Xavier8264/SAE-Aero-Design/reference/render/nau_2026_poster_p1.png

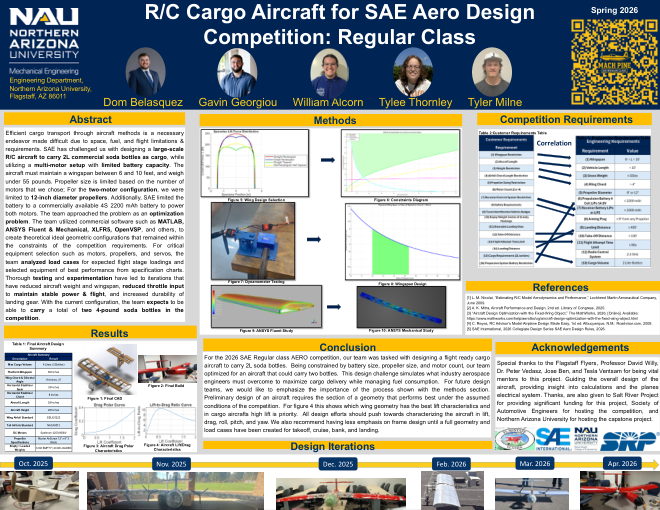
reference/render/nau_2026_poster_p1.png
