Xavier8264/SAE-Aero-Design/analysis/sizing/out/design_card.txt

DESIGN CARD: 2 x APC 12x6e, wing 95 x 26 in rectangular S1223, 6 bottle slots
Wing: S 17.15 ft2, AR 3.65, MAC 26 in, W/S 2.04 lb/ft2 at W_TO 35.0 lb
Tail (V_H 0.55, V_V 0.045, l_t 72 in): H-tail 3.41 ft2 (44 x 11.1 in, AR 4); V-tail 1.02 ft2 (15 in tall x 9.9 in, AR 1.5)
Bay: 1 layer(s), 29.9 in long x 13.5 in wide x 5.7 in tall (bottles transverse); fuselage pod ~46 in + boom; overall length ~93 in (< 120 rule)
Empty weight 17.66 lb (structure band x0.8 14.79 / x1.2 20.54): wing 7.18, fuselage 3.16, tail 1.08, gear 1.89, misc 1.07, propulsion 1.68, battery 0.55, avionics 1.05
Payload capability 17.38 lb (band: 14.50 .. 20.25); 1E4F needs 17.25 lb, 0E4F 16.20, 2E4F 18.30, 0E5F 20.25
Aero: clmax_2D 2.10, eta_max 1.173, CLmax wing 1.715, trimmed 1.661; e 0.925; CD0 non-wing 0.0163 (fus 0.0055, boom 0.0003, tail 0.0028, gear 0.0049, nac 0.0014)
  Cruise/circuit V 46.4 ft/s (32 mph), CL 0.85, CD 0.102, L/D 8.3, drag 4.22 lbf
Takeoff W 35.0 lb, DA 2000 ft: distance 100.0 ft (ground 89.1 ft, 4.5 s), V_stall 33.1 ft/s, V_R 36.4 ft/s, T0 12.17 lbf, T(V_R) 9.52 lbf
Takeoff W 35.0 lb, DA 1400 ft: distance 96.9 ft (ground 86.1 ft, 4.4 s), V_stall 32.8 ft/s, V_R 36.1 ft/s, T0 12.31 lbf, T(V_R) 9.64 lbf
Circuit (DA 2000): climb gradient 0.129 (5.6 ft/s at 1.3 V_s), 30 deg turn thrust margin 0.102 W, CL_turn 0.98
  current level 38 A / turn 48 A, flight 117 s, charge 1.38 Ah of 1.76 usable; landing roll from 1.2 V_s: 393 ft free, 114 ft braked (400 ft zone incl. touchdown)
Prop static DA  2000: Kv 843 rpm/V, 10527 rpm (APC limit 12500), thrust 6.54 lbf/motor (model, x0.93 applied in takeoff), battery 87 A total, shaft 519 W/motor, V_batt 13.8 V
Prop static DA  1400: Kv 843 rpm/V, 10494 rpm (APC limit 12500), thrust 6.62 lbf/motor (model, x0.93 applied in takeoff), battery 88 A total, shaft 524 W/motor, V_batt 13.8 V
Prop static DA     0: Kv 843 rpm/V, 10418 rpm (APC limit 12500), thrust 6.79 lbf/motor (model, x0.93 applied in takeoff), battery 90 A total, shaft 534 W/motor, V_batt 13.7 V
Bay option 6 slots: band 0.8: pay 20.3 -> 0E5F FS 55, E_FFS 59.2; band 1.0: pay 17.4 -> 1E4F FS 47, E_FFS 52.4; band 1.2: pay 14.5 -> 2E3F FS 39, E_FFS 45.0
Bay option 8 slots: band 0.8: pay 19.8 -> 3E4F FS 53, E_FFS 60.0; band 1.0: pay 16.8 -> 4E3F FS 45, E_FFS 52.0; band 1.2: pay 13.9 -> 5E2F FS 37, E_FFS 44.0
Aluminum-tube boom (4.1 ft): +0.38 lb empty -> payload 17.00 lb
