Xavier8264/SAE-Aero-Design/PROJECT_MEMORY.md

# SAE Aero Design 2027 Regular Class -- Project Memory Log

## RULES FOR THIS FILE (read first, every session)

1. APPEND-ONLY. Never delete or edit existing text. Add new entries at the END of the file only
   (e.g. `cat >> PROJECT_MEMORY.md <<'EOF' ... EOF`), never rewrite the file.
2. Every entry starts with a timestamp header: `## [YYYY-MM-DD HH:MM TZ] <task title>`.
   Get the time from the system clock (`date`), do not guess it.
3. CONTRADICTIONS: if two entries disagree, the entry with the LATEST timestamp is correct.
   To correct something, append a new entry that says what it supersedes. Do not edit the old one.
4. When in doubt, document. Record what was done, what was decided, the numbers used, where
   files/scripts live, sources, and what is still unverified, so a future Claude Code session
   can pick up without re-deriving anything.
5. Tag confidence where it matters: [VERIFIED] = read from a source/file, [INFERRED] = my
   reasoning, [UNVERIFIED] = assumption that still needs checking.
6. ASCII only in this file.

---

## [2026-09-18 20:31 CDT] Log created; back-fill of session 1 work (earlier this evening)

Note: the items below were done earlier in session 1 on 2026-09-18 before this file existed.
They are recorded now, so the timestamp is when they were written down, not when they happened.

### Source documents
- Rules: `2027_SAE_AeroDesign_Rules_Set.pdf` (Version 2027.0) in this folder.
- Text extraction: `pdftotext -layout` works (Git Bash, /mingw64/bin/pdftotext). Equations lose
  their symbols in text; render the page with PyMuPDF (`import pymupdf`, page.get_pixmap) to read them.
  The Read tool cannot render PDFs here (no pdftoppm).
- Regular Class = rules section 7 (pp. 33-36). TDS prediction = section 4.5 (p. 26).
  Flight rules = section 3 (pp. 17-20). Gross weight = p. 12.

### 2027 Regular Class rules summary [VERIFIED from rules PDF]
- Wingspan: > 72 in and < 96 in (max reduced vs 2026; Regular mission is in "year 2").
- Wing chord > 4 in. Body axis length < 120 in. Gross takeoff weight <= 55 lb.
- NO fiber-reinforced plastic anywhere (carbon, fiberglass; duct tape counts as FRP). Exceptions:
  commercially available FRP motor mounts, propellers, landing gear, control linkage parts.
- Rubber bands / elastics may not retain the wing or the payload.
- Propulsion: exactly 2 or 4 electric motors, any make/model. Props at motor RPM (1:1 if geared/belted).
  Max prop diameter 12 in (2 motors) or 9 in (4 motors). No metal props. Spinner or rounded safety nut.
- Battery: one commercially available 4S (14.8 V) LiPo, max 2200 mAh. NO power limiter required.
- Separate receiver battery required (Regular): LiPo or LiFe, >= 1000 mAh. Rx must work with arming plug out.
- Red arming plug on + lead, >= 9 in from any prop, top of fuselage near centerline, clearly visible.
- Wheeled gear needs ground steering (not aero surfaces alone).
- Ballast allowed if permanently installed, not in payload bay, not tradeable for payload.
- Payload: unmodified commercially available 2L cylindrical plastic bottles, carried internally.
  - EMPTY BOTTLE: gross weight > 1.0 lb and < 4.0 lb (unpressurized air or inert material).
  - FILLED BOTTLE: gross weight >= 4.0 lb.
  - Min 1 bottle per flight. After a scored flight, next attempt must add >= 1 empty bottle AND/OR
    swap >= 1 empty for a filled one. Total scored bottle count must stay constant or increase.
  - Spill that delays flight ops -> forfeit one flight attempt.
  - Cargo bay fully enclosed, bottles not exposed to airstream, must not shift. Any size/shape, multiple bays OK.
  - Unload demo at weigh station: <= 2 people, 1 minute, configuration unchanged since flight.
    Filled < 4.0 lb counts as empty; empty < 1.0 lb not counted. No tethers/harnesses on bottles.
- Flight: one flight per attempt, 60 s time limit from call to flight line, NO multiple takeoff tries (Regular).
  Airborne within 100 ft. No turn before 400 ft from start. One full 360 deg circuit. No aerobatics.
  Land within 400 ft, same direction as takeoff, no touch-and-go, stay on runway/zone.
  Two escorts + pilot; one member may hold the aircraft; main gear on takeoff line; no push on release.
  Anything other than a prop broken on landing falling off -> flight disqualified. Stickers/tape/covering
  detaching -> 25% deduction.
- Scoring (rules p. 36):
  - FS = 3*EB + 11*FB   (EB = # empty bottles, FB = # filled bottles)
  - FFS = (FS1 + FS2 + FS3)/3 + PPB   (top 3 flights)
  - PPB = max(10 - (FS - PS)^2, 0), PS = predicted max flight score read off the TDS curve at the
    measured density altitude. PPB uses whichever of the top-3 flights gives the largest PPB.
  - Tie-break: total filled bottles in top 3 scored flights.
- TDS: 1-page stand-alone doc (graph of predicted max flight score vs density altitude, English units,
  one value per altitude, monotonic, may include headwind/rolling drag/etc.) + a JSON data file.
  Bad JSON -> may lose the prediction bonus.
- Deadlines: lottery interest window Sept 16-30, 2026; lottery published Oct 1, 2026.
  Design Report + TDS + 2D drawing due 02/01/2027 11:59:59 EST (East/Florida, March)
  or 03/08/2027 (West/California, April). ECR deadline 02/26/2027 East, 04/02/2027 West.
  Late penalty 5 pts/day up to 5 days.

### Scoring insights [INFERRED]
- Points per pound are nearly equal: empty ~3.0 pts/lb (at ~1.0 lb), filled ~2.75 pts/lb (at 4.0 lb).
  Per bottle, filled is 3.7x better. Empties cost bay volume and drag more than weight.
  Likely direction: size the bay around filled bottles, use empties as +3 increments.
- Payload must increase every scored flight and FFS averages the top 3, so a planned payload
  "ladder" of >= 3 successful rungs is needed, and the bay must fit the top rung.
- PPB is effectively "predict your exact max configuration": missing by one empty bottle (3 pts)
  drops PPB from 10 to 1. Worth nearly one filled bottle.

### Team context (answers from Jordan)
- First-year team (no prior SAE aircraft or legacy data).
- Pilot: experienced with large/heavy (10+ lb) RC aircraft.
- Shop: laser cutter, 3D printers, machine shop / CNC mill. NO foam hot-wire.
- CAD: SolidWorks.
- Aircraft budget: under $1,000 (one airframe, value components, few spares). [INFERRED] favors 2 motors.
- Testing: thrust stand (have or can build) + flying field. No wattmeter/telemetry yet
  (recommended buying an inline wattmeter).
- Jordan wants help on everything: sizing & performance, aero & stability, structures & layout,
  report & TDS, and wants real external/online tools used (e.g. OpenFOAM, FluidX3D, not limited to these).

### Local compute [VERIFIED 2026-09-18]
- Laptop: AMD Ryzen 5 PRO 5675U, ~16 GB RAM, AMD integrated Radeon graphics only (no NVIDIA).
- WSL2 Ubuntu + docker-desktop distros installed (stopped). Python 3.14 with numpy 2.3.4, scipy 1.17.1,
  matplotlib 3.10.7, pandas 2.3.3, pypdf, pymupdf, pdfplumber.
- NOT installed: xfoil, avl, xflr5, openvsp, OpenFOAM, gmsh, paraview, aerosandbox.
- [INFERRED] FluidX3D (OpenCL) should run on the iGPU but at limited resolution; OpenFOAM feasible in WSL
  for a few-million-cell RANS case. Plan: AeroSandbox+NeuralFoil for sizing now, AVL/XFLR5 for
  stability, CFD later for targeted questions (fuselage drag, prop wash, flapped wing).

### Proposed plan (draft, to Feb 1, 2027)
1. Now -> mid-Oct: scoring/ladder model + conceptual sizing (100 ft takeoff model, motor/prop/battery,
   wing area, bottle count, 2 vs 4 motors). AeroSandbox + Python.
2. Mid-Oct -> Nov: airfoil, tail, CG/stability (AVL/XFLR5); spar/structure (wood/ply/aluminum);
   SolidWorks layout; thrust stand tests.
3. Late Nov -> Dec: build prototype, test-fly, measure takeoff distance at stepped weights.
4. Early Jan: targeted CFD. Jan: calibrate prediction with test data -> TDS curve + JSON, report, 2D drawing.

---

## [2026-09-18 20:31 CDT] Decisions from Jordan (session 1, second message)

- EVENT: assume the SOONER competition = East / Florida (March 2027). Design deadline = Feb 1, 2027
  (Design Report + TDS + 2D drawing, 11:59:59 PM EST). This supersedes "event undecided".
- This file (`PROJECT_MEMORY.md`) is the project memory: append-only, timestamped, latest wins.
- Standing rule: when in doubt, document work here for future Claude Code sessions.
- Bottle dimensions: use standard US 2L bottle dimensions from a web lookup (see next entries).
- Research what typically goes in the bottles, using 2026 (last year) info where possible.

---

## [2026-09-18 20:39 CDT] Research: standard US 2L bottle dimensions

- dimensions.com "Soda Bottle - 2 Liter": overall height 12.4 in (31.5 cm), diameter 4.33 in (11 cm). [VERIFIED source]
- Wikipedia "Two-liter bottle": height 300-330 mm (12-13 in), diameter 100-120 mm (3.9-4.7 in); PET, one piece,
  corrugated (petaloid) base. [VERIFIED source]
- Empty bottle mass: web sources disagree (30-80 g quoted); most say ~40-50 g. Working value 0.10 lb (~45 g)
  incl. cap. [UNVERIFIED -- weigh the actual bottles]
- WORKING BOTTLE MODEL for sizing: 4.33 in dia x 12.4 in tall, 0.10 lb empty.
- DESIGN ENVELOPE per bottle slot until real bottles are measured: 4.7 in dia x 13.0 in long [INFERRED:
  covers the whole Wikipedia range]. Shrink once the team buys and measures its chosen brand.
- TODO (Jordan/team): buy the brand you will fly, measure dia/height/empty mass of several, record here.

## [2026-09-18 20:39 CDT] Research: what goes in the bottles (2026 info)

### What the rules actually say [VERIFIED]
- 2026 rules: bottles contain "unpressurized air or material". 2027 rules: "unpressurized air or INERT material".
- No rule and no official FAQ (as of 2026-09-18) names a specific filler. Teams supply their own bottles
  [INFERRED from rules wording; not stated explicitly].
- Spill that delays flight ops -> forfeit one flight attempt (both years).
- 2027 adds: unloaded bottles must be free of tethers, harnesses, or similar external modification.
- Searched: official FAQ list, 2026 NAU capstone docs, TAMU/UC news articles, general web. No public source
  states what 2026 teams filled bottles with. Articles only say "weighted 2-liter plastic bottles".
  Per-team 2026 flight scores are not public (require saestars.com team login).

### Filler analysis [INFERRED; bulk densities are typical values, UNVERIFIED]
Targets with margin: FILLED = 4.05 lb gross, EMPTY = 1.05 lb gross (bottle 0.10 lb assumed).
Filler mass: FILLED 1.792 kg (3.95 lb), EMPTY 0.431 kg (0.95 lb). Nominal volume 2.0 L.
Brim-full average density needed: FILLED 0.896 kg/L, EMPTY 0.215 kg/L.

| Filler | kg/L | FILLED fill % | EMPTY fill % | Notes |
|---|---|---|---|---|
| water | 1.00 | 90% | 22% | sloshes if not full; brim-full = 4.51 lb (+0.46 lb waste); leak/spill risk; "inert"? ask FAQ |
| dry sand | 1.6  | 56% | 13% | cheap, dense; half-empty bottle lets sand shift at high pitch/vibration |
| pea gravel | 1.6  | 56% | 13% | like sand, less dust, easier cleanup |
| white rice | 0.8  | 112% (NO) | 27% | TRAP: brim-full rice = 3.63 lb gross -> scores as EMPTY, not filled |
| steel BBs | 4.7  | 19% | 5% | very compact, rolls freely -> worst for CG shift |
| sawdust | 0.21 | no | ~103% | brim-full ~1.03 lb gross: right at the 1.0 lb empty limit, too marginal |

Takeaways:
1. Most practical choices: dry sand or pea gravel (cheap, inert, dense, cleanable), or water if the FAQ allows it.
2. Free space inside the bottle lets the payload CG move when the aircraft pitches (rotation ~10-15 deg).
   Liquid moves immediately. Sand/gravel only flows past its angle of repose (~30-35 deg), so it is much
   better. Best: a BRIM-FULL dry mix tuned to the target density (e.g. sand + a lighter granular filler)
   so nothing can move.
3. Never use rice alone for a filled bottle (it cannot reach 4.0 lb).
4. Weigh every bottle on a calibrated scale before each flight; the weigh station is final.
   Filled < 4.0 lb scores as empty; empty < 1.0 lb does not count.
5. Cap security matters (spill = forfeit attempt), but tape/tethers may count as "external modification".

### Recommended official FAQ question to submit (saeaerodesign.com FAQ)
"Regular Class 2027 7.4: (a) Is water an acceptable 'inert material' for bottle fill? (b) May teams seal the
bottle cap with tape or thread sealant, or does that count as modification? (c) Are there restrictions on
granular fillers such as sand or gravel?"

## [2026-09-18 20:39 CDT] Research: 2026 Regular Class (last year) findings

### 2026 -> 2027 rule changes (diffed section 7 text) [VERIFIED]
- Max span: < 120 in (2026) -> < 96 in (2027). Min span > 72 in unchanged.
- Flight score: FS = 4*EB + 15*FB (2026) -> FS = 3*EB + 11*FB (2027). PPB formula unchanged.
- Filler wording: "material" -> "inert material".
- Payload increase rule now in the rulebook: "Total scored bottle count must remain constant or increase".
- New: unloaded bottles must be free of tethers/harnesses/external modification.
- Tie-break: lowest empty weight (2026) -> most filled bottles in top 3 flights (2027).
- Everything else in section 7 (materials, propulsion, battery, props, cargo bay) is unchanged.
- [INFERRED] every 2026 aircraft (many had 10 ft spans) must be redesigned for 96 in, so a first-year
  team is less disadvantaged than usual.

### Official FAQs (verbatim copies in reference/2026/SAE_FAQ_394_393_395_382.txt) [VERIFIED]
- FAQ 394 (2026): total bottle count must be constant or increasing. 2 empty + 2 filled -> 3 filled is NOT
  allowed. Valid: -> 1 empty + 3 filled, or -> 3 empty + 2 filled.
- FAQ 393 (2026): TDS breakpoints need not be evenly spaced; duplicate a density altitude at a score step to
  avoid interpolation (the highest score is used for duplicates); otherwise linear interpolation.
  (2026 used CSV; 2027 rules say JSON. Assume the same interpolation behavior [UNVERIFIED for 2027].)
- FAQ 395 (2027, posted 2026-09-14): prop diameter limit is the SUM of prop diameters per motor
  (2 motors: 12 in per motor, e.g. 1x12 or 2x6; 4 motors: 9 in per motor). No blade-count limit.
  SAE says battery + prop limits were set deliberately to cap payload capability since the power limiter was removed.
- FAQ 382 (2025): differential thrust does NOT count as ground steering; need a steerable wheel/mechanism.

### 2026 results (placings only; scores not public) [VERIFIED docs, column mapping INFERRED]
- East: March 6-8, 2026, Lakeland FL. Regular mission 1st Politechnika Poznanska (White Eagle), 2nd UW-Platteville
  (Pioneer Flyers), 3rd UFBA (Axe Fly). Regular overall: same order. Design 1st Warsaw UT (WUT Regular).
- West: April 17-19, 2026, Fort Worth TX (note: the 2027 rules say West is in California).
  Regular mission and overall: 1st NUAA (Phoenix), 2nd Poznan (White Eagle), 3rd Tarleton State (Texan Aero).
- TAMU Regular (Farmers Flight): 5th overall, 6th mission, 14th design report; 1st presentation.
  UC AeroCats Regular: 4th overall; ten-foot span.

### NAU "Mach Pine" 2026 Regular (a first-time capstone team) -- a useful low-end data point [VERIFIED poster/slides]
- Final: 80 in span, 19 in chord, 3 deg dihedral, S1223 wing airfoil, NACA 0012 tail, 39 in x 8 in stab,
  60 in long, 26 in tall. 2x Spektrum 4250-800kV with Master Airscrew 12x6 3-blade props.
  12.2 lb empty, 20 lb loaded. Cargo volume: 2 bottles. Goal: two 4-lb filled bottles.
- Tools: MATLAB, ANSYS Fluent & Mechanical, XFLR5, OpenVSP.
- Test: took off within 100 ft carrying 2 empty bottles (~1 lb each), but the flight ended in a crash.
- Lesson [INFERRED]: an empty-weight fraction around 60% leaves little payload. Plan early flight testing and repair time.

### Reference files saved to the project (for future sessions)
- reference/2026/2026_SAE_AeroDesign_Rules_Set.pdf
- reference/2026/2026_SAE_Aero_Design_East_Final_Results.pdf, ..._West_Final_Results.pdf
- reference/2026/NAU_MachPine_2026_Regular_poster.pdf
- reference/2026/UW_2026_rule_summary.pdf (a team's summary; it wrongly says "single electric motor")
- reference/2026/SAE_FAQ_394_393_395_382.txt

### Sources
- https://www.dimensions.com/element/soda-bottle-2-liter
- https://en.wikipedia.org/wiki/Two-liter_bottle
- https://saeaerodesign.com/cdsweb/rqa/BrowseFAQs.aspx (FAQ 382, 393, 394, 395)
- https://saeaerodesign.com/cdsweb/gen/DownloadDocument.aspx?DocumentID=10643d37-9fd1-4821-b413-9b7ddae8724b (2026 rules)
- https://www.saeaerodesign.com/content/2026-SAE-Aero-Design-East-Final-Results.pdf
- https://www.saeaerodesign.com/content/2026-SAE-Aero-Design-West-Final-Results.pdf
- https://www.ceias.nau.edu/capstone/projects/ME/2026/F25toSp26_Aero26/RegularClass.html (poster, slides;
  design report and most slides are password protected and were not opened)
- https://news.engineering.tamu.edu/news/2026/04/27/aero-design-team-continues-international-success/
- https://www.uc.edu/news/articles/2026/05/engineers-place-first-in-aircraft-design-competition.html
- https://aerouw.org/rule_summary.pdf

---

## [2026-09-18 20:54 CDT] Workflow: local reference library for token efficiency (tools/doc2text.py)

Jordan proposed: download documents once, convert PDFs/web pages to text with a Python script, and look
at the text instead of re-reading originals. Adopted, with these additions: an index, page markers,
per-page reliability flags, on-demand page rendering, and the file-rule amendments in the next entry.

### Commands (run from the project root)
- `python tools/doc2text.py fetch URL --name ID [--note TEXT]`  download + convert (cached; --force to refresh)
- `python tools/doc2text.py add PATH --name ID [--source URL] [--note TEXT]`  convert a local file in place
- `python tools/doc2text.py render ID PAGES`  PNG of PDF page(s) -> reference/render/ (only when needed)
- `python tools/doc2text.py note ID TEXT`, `rebuild`, `list`
- Handles PDF (PyMuPDF), HTML (BeautifulSoup+lxml), DOCX, PPTX (incl. truncated files), XLSX.
  Detects encrypted Office files and plain zips (flagged, not converted). No new packages were installed.

### Layout
- reference/INDEX.md: one row per document (ID, type, pages, ~tokens, flags, source, note). READ THIS FIRST.
- reference/text/ID.txt: text with markers like `=== PAGE 44 | p.36 | math ===` (PDF page | printed page | flags).
- reference/raw/: downloaded originals. reference/manifest.json: machine-readable index.
- reference/2026/: 2026 originals added in place.

### Lookup procedure (token-efficient)
1. Read reference/INDEX.md (small), not whole documents.
2. Grep reference/text/ for keywords, then Read only those line ranges. Cite printed page numbers.
3. Render a page image only if it is flagged (math/garbled/img) and the exact form matters.

### Measured [VERIFIED 2026-09-18]
- 15 documents: 4.30 MB of originals -> 0.30 MB of text (7%).
- Each SAE FAQ page: 17-30 KB of HTML -> about 150-420 tokens of text.
- rules_2027.txt is about 33k tokens in total: never read it whole, grep it.

### Extraction caveats found while testing [VERIFIED]
- PyMuPDF + Unicode NFKC recovers the Cambria Math equations that pdftotext drops. Rules p.36 reads
  "FS= Flight Score= 3(EB) + 11(FB)", "PPB= ... MAX(10 -(FS-PS)2, 0)". Sub/superscripts are flattened:
  "(FS-PS)2" means squared, "FS1" means FS_1. Those pages carry the `math` flag.
- The rules PDFs draw section NUMBERS (e.g. "7.6") as small images, so they are missing from the text.
  Search by heading words instead.
- The NAU poster has broken font encoding (flag `garbled`). Render it if needed.
- saeaerodesign.com is ASP.NET and wraps the whole page in a <form>; the converter must not strip <form>.
  The `lowtext` flag caught this bug on the first run.
- TOOL QUIRK: backslash-u escape sequences typed into Claude tool inputs (Write/Edit/Bash) get turned into
  literal Unicode characters. In code, build non-ASCII characters with chr(0x...) instead.

### Superseded / new
- reference/2026/SAE_FAQ_394_393_395_382.txt is superseded by reference/text/faq_*.txt (kept, not deleted).
- Library IDs as of now: rules_2027, rules_2026, results_2026_east, results_2026_west, nau_2026_poster,
  uw_2026_rule_summary, faq_list, faq_157, faq_170, faq_382, faq_393, faq_394, faq_395,
  wiki_two_liter_bottle, dimensions_2l_bottle.
- NEW [VERIFIED FAQ 170]: every pilot must present a valid AMA (Academy of Model Aeronautics) card at the
  field. The only exception is MAAC (Canada) members. ACTION: confirm the team pilot's AMA membership is current.
- NEW [VERIFIED FAQ 157]: all team members and the faculty advisor must be affiliated on www.sae.org. Students who
  submit documents or ask rules questions must also be affiliated on www.saeaerodesign.com.

## [2026-09-18 20:54 CDT] Amendment to RULES FOR THIS FILE (rules 7-9; appended, since the file is append-only)

7. CURRENT STATE SUMMARY entries: at the end of each design phase, or once ~400 lines have been added since the
   last one, append an entry titled "CURRENT STATE SUMMARY" that consolidates the latest truth (decisions,
   key numbers, open items, file locations). Future sessions: read the RULES header, then the LAST
   "CURRENT STATE SUMMARY" and everything after it. Grep older entries only when needed.
   (None written yet: the log is still short enough to read in full.)
8. Analysis scripts write full outputs to files and print only a short summary. Never paste full solver or CFD
   logs into the conversation.
9. Look things up library-first: reference/INDEX.md -> grep reference/text/ -> read line ranges -> render only
   if flagged. Use WebFetch only for one-off facts; archive anything that will be cited again with
   `doc2text.py fetch`.

---

## [2026-09-18 21:06 CDT] AI token-efficiency workflow set up (CLAUDE.md, AI_WORKFLOW.md, settings)

Verified against official Claude Code docs, archived as reference/text/cc_*.txt (costs, prompt_caching,
model_config, memory, best_practices, vs_code, context_window, commands, sessions, hooks, statusline,
troubleshooting, settings_reference, env_vars). These are big files (cc_hooks ~82k tokens,
cc_env_vars ~124k): grep them, never read them whole.

### Key facts [VERIFIED from docs]
- Every request re-sends the full conversation; cached re-reads still count toward usage. /clear costs nothing.
  /compact is itself a large request and is lossy.
- Auto-compact is ON by default. On Opus 4.7+ / Sonnet 5 / Fable (1M window, Anthropic API) it fires at about
  967K tokens. Settings: `autoCompactEnabled` (the /config "Auto-compact" toggle), `autoCompactWindow`
  (100K-1M; /autocompact writes it to USER settings), env CLAUDE_CODE_AUTO_COMPACT_WINDOW,
  CLAUDE_AUTOCOMPACT_PCT_OVERRIDE, DISABLE_AUTO_COMPACT.
- CLAUDE.md may contain a "# Compact instructions" section. The project-root CLAUDE.md and auto memory are
  re-injected from disk after compaction.
- These invalidate the prompt cache: switching model, changing effort (except Fable 5.1), fast mode, MCP
  connect/disconnect, plugin toggle, compaction, many images, upgrading Claude Code. Rewind keeps the cache.
  Editing CLAUDE.md mid-session keeps the cache but only applies after /clear, /compact or restart.
- Cache TTL: 1 hour on a subscription within limits (5 min on an API key / usage credits).
- VS Code extension: supports only a subset of slash commands (type / to list), has checkpoints/rewind via the
  message hover button, a context indicator in the prompt box, a Session history button, and /usage.
- Keep CLAUDE.md under 200 lines. MCP servers add tool names + server instructions to every session.
  Agent teams use about 7x the tokens.

### Changes made (Jordan approved both via questions)
- CREATED .claude/settings.json (project scope): {"autoCompactEnabled": true, "autoCompactWindow": 200000}.
  It is a backstop only. It takes effect from the NEXT session: the settings watcher only watches directories
  that had a settings file at session start [per update-config skill; not directly verified].
- EDITED C:/Users/jprun/.claude/settings.json (GLOBAL): effortLevel "xhigh" -> "high". Model stays "opus".
  Applies to new sessions. Pick xhigh at the START of hard design sessions.
- CREATED CLAUDE.md (project root, ~40 lines, auto-loaded every session): session-start protocol,
  working rules, checkpoint procedure, "# Compact instructions".
- CREATED AI_WORKFLOW.md: the human guide (session loop, which reset to use, auto-compact, model/effort,
  tips, cheat sheet). CLAUDE.md tells Claude not to load it unless asked.

### Session protocol (summary; CLAUDE.md is authoritative)
Start fresh with one task -> Claude reads the log header + LAST "CURRENT STATE SUMMARY" + later entries ->
work -> Jordan says "checkpoint" -> Claude appends to the log -> Jordan runs /clear.
Wrong path -> rewind (cheapest). Long session mid-task -> /compact with focus. Side question -> /btw.
Break > 1 hour -> checkpoint first.

### Suggestions left to Jordan (not done)
- Disable MCP connectors this project does not use (Indeed, Canva probably) via /mcp.
- Gmail / Google Calendar connectors need authorization in claude.ai connector settings if ever wanted.

## [2026-09-18 21:06 CDT] CURRENT STATE SUMMARY (end of setup/research phase; start here)

Consolidates everything above. Older entries hold the detail and sources; grep them only when needed.

### Project
- SAE Aero Design 2027 Regular Class (2L-bottle cargo). First-year team. Jordan leads the work with Claude.
- Event: plan for EAST / Florida (March 2027). Design Report + TDS (1-page PDF + JSON) + 2D drawing due
  2027-02-01 11:59:59 PM EST. Lottery interest window closes 2026-09-30.
- Team: experienced heavy-RC pilot; laser cutter, 3D printers, machine shop/CNC mill (no hot-wire);
  SolidWorks; budget < $1,000; thrust stand + flying field; no wattmeter yet (buy one).
- Compute: Ryzen 5 5675U laptop, 16 GB, AMD iGPU, WSL Ubuntu. Python: numpy/scipy/matplotlib/pandas,
  pymupdf, bs4, lxml, python-docx/pptx, openpyxl, requests. No aero tools installed yet.

### Rules that drive the design (rules_2027, printed pages 33-36 unless noted)
- Span > 72 in and < 96 in; chord > 4 in; length < 120 in; gross weight <= 55 lb (p.12).
- NO FRP (carbon/fiberglass/duct tape) except bought motor mounts, props, gear, linkages.
- 2 motors (12 in props) or 4 motors (9 in props); the limit is the SUM of prop diameters per motor
  (FAQ 395). One 4S LiPo <= 2200 mAh; no power limiter. Separate Rx battery >= 1000 mAh.
- Airborne within 100 ft, single try; one 360-degree circuit; land within 400 ft, same direction.
  Steerable ground gear required (differential thrust does not count, FAQ 382).
- Bottles carried internally, fully enclosed, no shifting; unloaded by 2 people in 60 s; no tethers.
  EMPTY: > 1.0 and < 4.0 lb. FILLED: >= 4.0 lb. Each scored flight must add payload, and the total bottle
  count can never go down (FAQ 394).
- FS = 3*EB + 11*FB. FFS = mean of the top 3 FS + PPB, where PPB = max(10 - (FS - PS)^2, 0).
  Tie-break: filled bottles in the top 3 flights.
- TDS: predicted max FS vs density altitude, monotonic, English units, plus JSON. Breakpoints may be uneven
  and duplicated at score steps (FAQ 393, 2026; assume the same for 2027).
- All pilots need a current AMA card (FAQ 170). Team + advisor must be affiliated on sae.org (FAQ 157).

### Working design assumptions
- Bottle slot envelope 4.7 in dia x 13.0 in until real bottles are measured (typical 4.33 x 12.4 in, ~0.10 lb).
- Targets: filled 4.05 lb, empty 1.05 lb gross. Filler: dry sand or pea gravel, ideally a brim-full mix
  tuned to ~0.9 kg/L (filled) so nothing shifts. NOT rice alone (brim-full = 3.63 lb, scores as empty).
  Water only if an FAQ confirms it counts as inert.
- Strategy [INFERRED]: size the bay around filled bottles; use empties as +3 steps; plan a payload ladder of
  3 or more successful flights; PPB rewards predicting the exact maximum configuration.
- 2 motors favored by budget (trade study still to do). 2026 NAU data point: 80 in span, 12.2 lb empty,
  aimed at 2 filled bottles, crashed in testing.

### Tooling in place
- PROJECT_MEMORY.md (this log, append-only). CLAUDE.md (auto-loaded rules). AI_WORKFLOW.md (human guide).
- tools/doc2text.py + reference/INDEX.md: 29 documents (rules 2026/2027, results, FAQs, bottle pages,
  Claude Code docs).
- .claude/settings.json: autoCompactWindow 200000. Global effort: high.

### Open items / action items for Jordan
1. Register interest in the lottery by 2026-09-30.
2. Confirm the pilot's AMA membership; affiliate everyone on sae.org.
3. Buy and measure the bottles you will fly (diameter, height, empty weight).
4. Optional: submit an FAQ on water as filler / cap sealing.
5. Optional: disable unused MCP connectors (/mcp).

### NEXT TASK (start of the design phase)
Conceptual sizing: pip install aerosandbox (with NeuralFoil); build the scoring/payload-ladder model and a
100 ft takeoff model; motor/prop/battery; wing area and span; bottle count; 2 vs 4 motors.
Suggested session setup: Opus, effort high (or xhigh), fresh session.

---

## [2026-09-18 21:25 CDT] Reference library expanded to 118 docs; model/agent selection guidance; project agents

### Jordan's standing guidance on models and agents (verbatim intent, 2026-09-18)
- Clearing chat context is often worth it: many tasks only need an agent doing one specific job, not the whole chat.
- Sometimes a Sonnet model is all a task needs. Sometimes an extra-high (xhigh) Opus 5 agent is needed.
  Do not lock yourself below Opus xhigh.
- Fable 5: sometimes needed, but use it SPARINGLY and ASK JORDAN FIRST.
- Now encoded in CLAUDE.md ("Model and agent selection") and in the project agents below.

### Project agents created: .claude/agents/ (docs verified in cc_sub_agents: frontmatter model + effort)
- sae-researcher: Sonnet, effort medium; tools WebSearch/WebFetch/Bash/Read/Grep/Glob. Web research; returns tables.
- sae-worker: Sonnet, effort medium. Routine execution: scripts, archiving, reformatting, small edits.
- sae-analyst: Opus, effort xhigh. Trade studies, analysis models, reviews.
- Subagents do NOT receive CLAUDE.md or the global rules, so each profile body repeats the essentials
  (never delete/vault.ps1, ASCII/chr() quirk, library-first, never write PROJECT_MEMORY.md).
- A running session does not detect a newly created .claude/ directory. Jordan must RESTART Claude Code
  (not just /clear) before the agents and .claude/settings.json (autoCompactWindow 200000) load.
  [per cc_sub_agents and the update-config skill]

### How the library was built (method worth reusing)
- 5 Sonnet general-purpose agents ran in parallel, one per topic (design methods, aero data/tools,
  propulsion/electrical, structures/materials, site climate + precedent). Each verified every URL by download
  and returned a table. The main session imported sequentially (tools/doc2text.py add), so manifest.json had
  one writer. Cost: about 546k subagent tokens total (101k-127k each), 7-10 min wall time.
- Import helper used: a script that copies the files into reference/raw/<id>.<ext>, then runs doc2text add with
  --source/--note. (It lived in the session scratchpad and is gone; trivial to rewrite.)
- doc2text.py fixes: on SSL certificate errors it falls back to curl (the NAU server sends an incomplete chain);
  fetch failures now print one line instead of a traceback, and nothing is added to the manifest.
- APC site (apcprop.com) returns 403 unless given a full browser UA + a Referer of the performance-data page.
  doc2text fetch does not send these, so download APC files with curl + headers, then `add`.

### What is in the library now (118 docs, ~2.9M tokens total; READ reference/GUIDE.md, the topic map)
- Methods: drela_design_rules, nicolai_rc_model_aero (written for SAE Aero; hosted by SAE), mit_airpower,
  mit_prop_appendix, scholz_tail_volume, nasa_grc_propeller_thrust.
- Aero: 10 airfoil .dat files (S1223, S1223RTL, S1210, E423, FX74-CL5-140, CH10sm, SD7062, NACA4412; tails SD8020,
  NACA0012), selig_guglielmo_1997, selig_lowre_lecture, UIUC LSAT wind-tunnel volumes 1-3 (plots: render pages),
  tool docs (AeroSandbox, NeuralFoil, AVL, XFOIL, XFLR5 parts 1-3, VSPAERO), CFD docs (OpenFOAM, FluidX3D).
- Propulsion: 11 APC PER3 data files (12x6E/8E/10E/12E, 11x7E/10E, 9x6E/4.5E/7.5E, 6x4E/5.5E), APC RPM limits,
  drela_motorprop, QPROP/QMIL docs, UIUC prop DB + Brandt-Selig paper, LiPo papers, servo sizing sources.
- Structures: Wood Handbook 2021 ch5/8/10/11/12, ANC-18 wood aircraft (OCR text), aluminum 6061/7075, balsa vs
  density (hobbyist), PLA/PETG/LW-PLA data sheets, FDM infill paper, spar design tutorial.
- Site/TDS: KLAL elevation 141.8 ft [VERIFIED airnav]; NOAA March normals Tmax 80.2 F / Tmin 56.5 F (Lakeland 2
  station); NWS density-altitude equations; reference/data/klal_asos_2021-03_to_2026-04.csv (hourly KLAL
  weather, all months, 68k rows, kept out of text/ so it does not flood grep; see reference/data/README.txt).
- Precedent: NAU 2026 reports 1+2 (same mission), FAMU-FSU 2020/2021, NAU 2018/2019/2021/2025, NYU 2018 (older
  missions; use for methods: payload prediction, takeoff analysis).

### Known gaps (searched, not found free/legit)
- Stanford AA241 (Kroo) site is offline (NXDOMAIN); no archived takeoff/tail/weight chapters.
- No public 2026 reports from the top teams (Warsaw, Concordia, TAMU, Poznan, NUAA).
- MatWeb is blocked (403); DTIC hinge-moment report down; Borrega & Gibson balsa paper behind a captcha.
- No LiPo-specific (vs Li-ion) government paper on voltage sag at high C; only nasa_uav_battery_model.
- The FAA 5010 record for KLAL needs a login (used AirNav instead).

### Files changed this entry
- NEW: reference/GUIDE.md (topic map), reference/data/ (CSV + README), .claude/agents/sae-{researcher,worker,analyst}.md
- EDITED: CLAUDE.md (model/agent section; GUIDE.md pointer), AI_WORKFLOW.md (tip 8), tools/doc2text.py (curl fallback)
- The CURRENT STATE SUMMARY above is still valid, except: the library is now 118 docs (not 29), and there are project agents.

---

## [2026-09-18 23:47 CDT] Conceptual sizing started (unattended overnight session)

- Installed with pip for Python 3.14.0: aerosandbox 4.2.10, neuralfoil 0.3.3, casadi 3.8.1, plus dill and
  sortedcontainers. All import cleanly [VERIFIED by running python].
- Delegated conceptual sizing to the sae-analyst agent (Opus xhigh). Its work goes ONLY in analysis/sizing/
  (scripts, out/, REPORT.md). Scope: scoring/payload-ladder model, KLAL March density altitude, 2x12 vs 4x9
  propulsion from APC PER3 data, 100 ft takeoff model, NeuralFoil airfoil comparison, empty-weight model,
  span/area/AR sweep -> recommended design point.
- IF THIS IS THE LAST ENTRY: the agent may not have finished (usage limit or session end). Check whether
  analysis/sizing/REPORT.md exists and is complete; if it does not, resume the sizing task from what is in
  analysis/sizing/.

---

## [2026-09-19 00:28 CDT] Conceptual sizing DONE (sae-analyst agent, ~41 min, 88k tokens)

All work in analysis/sizing/. Run order: density_altitude, scoring, propulsion, airfoils (slowest), aero, weight,
takeoff, sweep (~12 s), design_card, wing3d_check (~4 s). Libraries: common.py, mission.py. Headline numbers are
in analysis/sizing/out/design_card.txt [VERIFIED: file read by main session; values below match it].
Main session spot-checked rule citations in rules_2027.txt l.1548-1560, 1576-1578, 1592-1599 [VERIFIED].

### Recommended design point (DA 2000 ft, zero wind, 100 ft takeoff) [INFERRED, medium confidence overall]
- Wing 95 x 26 in rectangular S1223, untwisted: S 17.15 ft^2, AR 3.65, W/S 2.04 lb/ft^2.
- 2 x APC 12x6E, Kv ~840, ~90 A peak total, one 4S 2200 mAh pack (>= 45C burst). 4 x 9x4.5E ties on score
  (E_FFS 52.4 vs 52.6) but weighs 0.39 lb more -> choose 2 motors.
- 6-slot single-layer transverse bay, 29.9 x 13.5 x 5.7 in. Tail V_H 0.55, V_V 0.045, l_t 72 in
  (H 44 x 11.1 in, V 15 x 9.9 in), wood boom. Overall length ~93 in.
- W_TO 35.0 lb (takeoff-limited; the 55 lb limit is not active). W_empty 17.66 lb (band 14.8-20.5).
  Payload 17.4 lb (band 14.5-20.3).
- Top rung 1E4F = 17.25 lb, FS 47, margin only 0.13 lb. Ladder 1E3F (36) -> 0E4F (44) -> 1E4F (47);
  FFS 52.3 with full PPB.
- Speeds: Vs 33.1 ft/s, V_R 36.4, circuit 46.4 ft/s at L/D 8.3; the circuit uses 1.38 of 1.76 Ah usable.
- Draft TDS curve: payload = 18.96 - 0.79 lb per 1000 ft DA (out/design_payload_vs_DA.csv).
  FS 50 (2E4F) below DA ~900 ft, 47 (1E4F) from 1000 to 2000 ft, 44 (0E4F) from 2250 to 3000 ft.
- KLAL March, 09-17 local (n=1441): DA P10 533, P50 1410, P90 1975, max 2484 ft [VERIFIED from ASOS CSV via
  script]. Median wind 9 kt; no wind credit taken.

### Key findings
- The biggest levers on payload are empty weight (1:1; structure x1.2 -> 2E3F), span (~0.13 lb/in near 95 in),
  and pilot rotation technique (k_R 1.2 instead of 1.1 -> -2.8 lb W_TO). Then peak current (70 A 29.2 lb,
  110 A 33.5 lb W_TO), thrust (x0.85 -> -1.5 lb) and CLmax (-10% -> -1.8 lb). A 5 kt headwind is worth +6 lb W_TO.
- Airfoil ranking (NeuralFoil, anchored to tunnel data): S1223 > S1223RTL (-0.4 lb, fallback if the thin trailing edge
  is hard to build) > FX74 > E423 > CH10 > S1210 > SD7062. High confidence in the ranking.
- Chord at 95 in span is flat for 26-32 in; the agent took the smallest wing within 0.5 E_FFS of the optimum.
  The 6-slot bay beats 8 slots (2x4) at every empty-weight band.
- FRP ban (l.1557-1560) -> no carbon boom or spar. An aluminum tube boom costs 0.38 lb and drops the top rung to 0E4F.
- Landing roll 393 ft free vs the 400 ft zone (touchdown included) -> a WHEEL BRAKE IS REQUIRED (114 ft braked).
- AeroSandbox VLM check (wing3d_check.py): the Raymer AR/(AR+2) factor on Cm0 is wrong for this wing. Best wing
  Cm0 is ~ -0.28 (aero.py uses -0.178), and x_np is ~0.44c with the fuselage (hand formula 0.39c). The two errors
  nearly cancel (trimmed CLmax +1.1%), so the sizing stands. USE THE VLM VALUES FOR STABILITY WORK.
- Weight estimate calibrated only on NAU 2026 (K_BUILD 1.066). Our payload fraction of 0.50 vs NAU's 0.39 is the
  single largest uncertainty.

### UNVERIFIED (what confirms it)
- Thrust x0.93 knock-down, 90 A peak, pack sag, motor Rm 0.028 / I0 1.8 -> thrust stand with the real pack.
- Empty-weight coefficients, battery 0.55 lb, prop group 1.68 lb -> build and weigh a test wing panel.
- Bottle slot 4.7 x 13.0 in and the 4.05/1.05 lb fill targets -> measure real bottles.
- Landing friction and brake effectiveness; event runway heading.
- Stability and trim: no AVL/XFLR5 model yet; the tail is sized by volume coefficients only.

### Housekeeping
- analysis/sizing/REPORT.md was NOT written. The agent said the harness blocked sub-agents from writing report
  .md files and asked the main session to write it. It was not written without Jordan's approval. The full
  report text exists only in the overnight session's chat. The numbers are in out/*.txt and out/*.csv.
- out/airfoil_summary.txt still cites selig_guglielmo_1997 l.266 (the correct line is l.267) until airfoils.py is rerun.
- The agent archived one stray output to the vault (id 0e9c883b).
- Not committed to git.
- A multi-line heredoc append with shell variables was blocked by the delete-safety hook (false positive; nothing
  was being deleted). Workaround: write the entry to the scratchpad with the Write tool, then run a plain cat >>.

---

## [2026-09-19 00:28 CDT] CURRENT STATE SUMMARY (end of conceptual sizing; start here)

The [2026-09-18 21:06] summary still holds for the project, rules, team, bottles and scoring, with these updates:
- Library: 118 docs; the topic map is reference/GUIDE.md. Project agents are in .claude/agents/ (researcher,
  worker, analyst).
- Tools installed: aerosandbox 4.2.10, neuralfoil 0.3.3, casadi 3.8.1 (Python 3.14). No AVL/XFLR5/OpenFOAM yet.
- Design point (see the entry above; analysis/sizing/out/design_card.txt): 95 x 26 in rectangular S1223 wing,
  2 x APC 12x6E on 4S 2200, 6-slot bay, W_TO 35 lb, W_e 17.7 lb, payload 17.4 lb, top rung 1E4F (FS 47) at DA 2000 ft.
- Required features found by the analysis: wheel brake, wood (non-FRP) spar and boom, big tail for the S1223 Cm0.

### Action items for Jordan (hardware; these retire the top uncertainties)
1. Lottery interest by 2026-09-30; AMA card; sae.org affiliation (unchanged).
2. Buy and measure bottles.
3. Thrust stand: 12x6E and 12x8E on 800-900 Kv motors with a real 4S 2200 pack (thrust, amps, sag).
4. Build and weigh a wing test panel (refit K_BUILD in weight.py).
5. Decide whether to save the sizing report text as analysis/sizing/REPORT.md (see Housekeeping above).

### NEXT TASK
Stability and trim: install AVL (or XFLR5) and build a model of the design point, starting from the VLM values
(wing Cm0 -0.28, x_np ~0.44c). Size the tail and elevator for trim at CLmax with every bottle-ladder CG, and check
static margin, Cn_beta and Cl_beta. Then fix the Cm0 factor in aero.py and rerun sweep.py.
Suggested: sae-analyst agent; main session on Opus.

---

## [2026-09-19 16:11 UTC / 11:11 CDT] Dedicated compute box: task backlog brainstorm (no scripts written)

Task: Jordan has an always-on mini PC to dedicate to this project for its duration and asked for
ideas for long-running iterative jobs. Brainstorm only; explicitly NO scripts written this session.

### Hardware [VERIFIED 2026-09-19 via AMD product page / TechPowerUp / LaptopMedia]
GMKtec NucBox M6 Ultra. AMD Ryzen 5 7640HS: 6 cores / 12 threads, Zen 4, 4.3 GHz base, 5.0 GHz
boost, 16 MB L3, 35-54 W TDP. Radeon 760M iGPU (8 RDNA3 CUs). 32 GB RAM (DDR5-5600 supported),
512 GB SSD. NOTE: 6 cores, not 8; the 8-core part is the 7840HS.

### Compute budget [INFERRED, order of magnitude, not benchmarked]
- Analytic eval (takeoff integration + weight + aero + score): ~1 ms -> ~1e9 evals/day.
- NeuralFoil point ~1 ms. AVL run ~0.05-0.5 s -> ~2e6-2e7/day.
- XFOIL alpha sweep ~5-30 s -> ~3e4-2e5 polars/day.
- OpenFOAM 2D RANS (~1e5 cells) ~5-15 min -> ~100-300 cases/day.
- OpenFOAM 3D RANS (~5e6 cells, fits in 32 GB) ~8-20 h -> ~1-2 cases/day.
- FluidX3D on 760M: ~60 GB/s effective bandwidth / ~55 bytes per cell-step -> ~1e9 cell-updates/s,
  i.e. 256^3 at ~60 steps/s. UNVERIFIED arithmetic; benchmark before relying on it.

### Backlog written to COMPUTE_BACKLOG.md (NEW FILE, 184 lines)
Tier 1 (highest value per compute hour):
  T1-1 Model validation harness (RUN FIRST): reproduce NAU 2026 aircraft and UIUC LSAT tunnel
       polars; sweep XFOIL Ncrit/transition/roughness settings until they match, then freeze.
  T1-2 Payload-ladder + TDS strategy as a stochastic dynamic program over
       (flights remaining, bottles loaded, successes, scores banked); sweep declared PS to
       maximize expected FFS. Quadratic PPB term makes PS choice worth real compute.
       OPEN [UNVERIFIED]: number of flight attempts available at EAST 2027 (DP input).
  T1-3 Robust takeoff Monte Carlo: P(airborne within 100 ft) vs payload, with uncertainty on
       empty weight, CLmax, mu, thrust, LiPo sag, and density altitude/headwind drawn from
       reference/data/klal_asos_2021-03_to_2026-04.csv (March daytime hours). Feeds T1-2.
  T1-4 Full-factorial design-space MAP (8 vars x 10 levels = 1e8 evals ~ 2-3 h), then NSGA-II /
       CMA-ES multi-start; deliverable is the score plateau, not a single peak.
  T1-5 Structural weight optimization with Monte Carlo over balsa density scatter and spruce
       variability; CalculiX FEA on the shortlist.
Tier 2: T2-1 XFOIL polar farm + NeuralFoil-driven airfoil shape optimization; T2-2 propulsion
  combinatorics (prop x Kv x 2 vs 4 motors x sag, APC RPM limits as hard constraint);
  T2-3 AVL sweeps (trim, static margin, elevator authority at rotation, gust/crosswind vs KLAL
  wind rose); T2-4 bottle packing + CG across EVERY loading state of the ladder; T2-5 mission
  energy / 3-DOF trajectory (2200 mAh must fly the full pattern); T2-6 cross-validation of
  independent models over the whole sweep space.
Tier 3: T3-1 CFD used narrowly (2D check on XFOIL; 3D only for ground effect, junction drag,
  propwash; FluidX3D as an experiment); T3-2 surrogates + Bayesian calibration against thrust
  stand / flight test data; T3-3 QMIL custom prop [legality UNVERIFIED, stretch only];
  T3-4 topology optimization of printed parts (low payoff).
Background chores: daily SAE FAQ/rules diff with alert; nightly pipeline re-run + regression
  tests; density-altitude watch; build/weight tracker feeding the score prediction.
Setup: Ubuntu Server bare metal (not WSL), systemd + tmux, checkpointed resumable jobs writing
  SQLite/Parquet, 6-worker pools for bandwidth-bound work and 12 for cheap evals, log clocks and
  temps (a 35-54 W part in a mini chassis will throttle), watch SSD fill from CFD writes.

### Key judgement recorded
The biggest risk is hours of compute on an uncalibrated model producing a confident wrong
airplane. T1-1 gates everything else. Second judgement: T1-2 and T1-3 are where this project is
most likely to gain points over other teams, because the physics is cheap and the decision
analysis is what teams skip.

### Files changed
- NEW: COMPUTE_BACKLOG.md
- No scripts written (per Jordan's instruction).

### NEXT TASK
Either (a) stand up the mini PC: Ubuntu Server, Python env, aerosandbox/NeuralFoil, XFOIL, AVL,
and implement T1-1 the validation harness; or (b) proceed with conceptual sizing on the laptop as
the previous CURRENT STATE SUMMARY planned and let the mini PC pick up T1-1 in parallel.

---

## [2026-09-19 21:49 CDT] Git consolidated; 20 sources archived for the post-sizing phases

Task from Jordan: talk through how to approach building the airplane, with every decision grounded in an
outside source and using free/open-source tools; make the repo good for future sessions and token-efficient;
merge everything to main and trim stray branches.

### Git housekeeping [VERIFIED by running the commands]
- Local main had the uncommitted analysis/sizing work; origin/main was 2 commits ahead (COMPUTE_BACKLOG.md,
  merged from PR #1 branch claude/mini-pc-compute-ideas-p4tp5m).
- Committed the sizing work (9d8f8d6), merged origin/main (9c8168b), pushed. main == origin/main.
- PROJECT_MEMORY.md merge conflict resolved by keeping BOTH appended blocks in timestamp order
  (00:28 CDT sizing entries, then the 16:11 UTC compute-backlog entry). No existing text was changed.
- Branches: main is the only branch, local and remote. The PR branch was already deleted on GitHub.
  Nothing to trim.
- NOTE: reference/raw/ is tracked in git and is now ~213 MB; .git is 114 MB. Works, but if the repo keeps
  growing consider gitignoring reference/raw/ (text/ + manifest.json are what sessions actually read).

### Jordan's decisions this session
1. Push to GitHub: yes, done.
2. Session task: archive the researched sources.
3. ORDERING, standing guidance: TESTS FIRST. Physical tests (wing panel weigh-in, thrust stand) come before
   further analysis refinement, because the weight model rests on a single calibration point (NAU 2026) and
   every downstream number is scaled by it. This supersedes the "AVL stability and trim" next task from the
   [2026-09-19 00:28] summary as the immediate priority; AVL work resumes after or alongside the test data.

### Library: 118 -> 138 documents (~2.9M -> ~4.1M tokens)
sae-researcher pass (Sonnet, ~58k tokens) found free sources for the gaps conceptual sizing left open.
Every URL was HTTP-200 verified before archiving. New IDs, by gap:
- Design process: vt_aoe_a5_initial_sizing, vt_aoe_a7a_config_layout, vt_aoe_a10_prelim_design (Virginia Tech
  AOE 4065/4066, Raj), mit_1682_flight_vehicle_intro, nasa_se_handbook (SP-2016-6105 Rev2, 262k tokens).
- Structures and loads: nasa_vgh_load_factor_stats (NASA CR-132531, VG/VGH statistics -> V-n load factor),
  uf_wing_spar_optimization (14 lb / 7 ft span RC aircraft, closest scale match), syracuse_wing_spar_design,
  fpl_minimum_weight_sandwich (USDA FPL RN-086).
- Tools: openvsp_user_manual, gmsh_reference_manual (298k), calculix_manual (CalculiX 2.22, 448k),
  freecad_fem_workbench, su2_quick_start, paraview_docs.
- Flight test: nasa_takeoff_flighttest_method (NASA TN D-7603, takeoff performance INCLUDING pilot technique),
  ardupilot_airspeed_calibration, ama_national_safety_code.
- Build technique: modelaviation_sliced_rib_method, modelaviation_diy_laser_cutting (AMA magazine grade:
  cite as practice, never as allowables).
reference/GUIDE.md updated with three new sections and the notes above. The big ones are GREP ONLY.

### Gaps and dead ends found by the search [VERIFIED this session]
- NO published study compares AVL / XFLR5 / VSPAERO / OpenFOAM against wind-tunnel data at Re 100k-500k.
  We therefore have NO external error band for our own aero predictions. Close it in-house by running our
  tools against the uiuc_lsat_* polars already held (this is COMPUTE_BACKLOG T1-1, validation harness).
- Stanford AA241 is confirmed dead (adg.stanford.edu does not resolve). Stop looking for it.
- MIL-HDBK-23 was canceled in 1988 and folded into MIL-HDBK-17, which is not free. Use fpl_minimum_weight_sandwich.
- wiki.freecad.org is behind Anubis bot protection: curl and doc2text get an interstitial page, not content.
  The first freecad_fem_workbench download captured that interstitial; it was vaulted (id a1aad00b) and
  replaced by the raw.githubusercontent.com FreeCAD-documentation mirror. Browser-only for other wiki pages.
- Still missing: stall-speed and static-margin flight-test procedures; covering-film guidance; no
  SAE-Aero-specific requirements-traceability source (the held student team reports are the closest thing).

### Approach proposed to Jordan (not yet built; his reaction pending)
- DECISIONS.md: a flat ledger, one row per decision (ID, decision, number with units, source citation as
  library ID + line range or script path + output file, confidence, what would overturn it). Rule: nothing
  enters without an external citation or a script whose inputs are cited; anything else is [UNVERIFIED] with
  a retirement path. Purpose: a new session learns WHY the wing is 95 in without reading 600 log lines.
- analysis/README.md (run order and which outputs are current) and a short pinned state file, so context
  loading is one short read. The log stays append-only as the audit trail.
- Three kinds of claim need three kinds of grounding: physics/method -> literature; component behavior ->
  manufacturer data plus independent measurement; OUR airframe -> our own tests, because no source exists
  for an airplane nobody has built. That third category is why tests come first.

### NEXT TASK
Write the test plan for the two tests that retire the biggest uncertainties, with procedures grounded in the
new sources: (1) wing test panel build and weigh, to refit K_BUILD in analysis/sizing/weight.py; (2) static
thrust stand for 12x6E and 12x8E on 800-900 Kv motors with a real 4S 2200 pack, measuring thrust, current
and pack sag against the apc_* data. Include what to measure, how many runs, and how each result feeds back
into a specific script. Then, with data in hand, resume AVL stability and trim.

## [2026-09-20 21:55 CDT] TEST_PLAN.md written (T-1 wing panel weigh-in, T-2 static thrust stand)

Task: the NEXT TASK from the [2026-09-19 21:49] entry. Wrote the test plan for the two physical
tests that retire the biggest uncertainties, under Jordan's TESTS FIRST ordering.

### Files changed
- NEW: TEST_PLAN.md (about 440 lines, project root).
- NEW: analysis/tests/data/ (empty; holds the CSVs the plan specifies).
- No analysis scripts changed. No model constants changed. Nothing committed to git.

### Value of each test, computed from existing outputs [VERIFIED by reading the files]
- T-1: structure band x0.8/x1.0/x1.2 -> payload 20.25 / 17.38 / 14.50 lb -> FS 55 / 47 / 39
  (out/design_card.txt). 16 Flight Score points of spread, about 2.8 FS per lb of empty weight.
- T-2: THRUST_FACTOR x1.00 -> W_TO_max +1.18 lb; x0.85 -> -1.41 lb (out/takeoff_sensitivity.csv).
  About 2.6 lb of takeoff weight, roughly 7 FS points.
- Therefore T-1 ranks first if only one test gets done. The two are independent and can run in
  parallel with two people.

### Design choices in the plan worth remembering
1. T-1 weighs COMPONENTS, not just the finished panel. One panel total is one equation for three
   unknowns (A_WING0, A_WING1, K_BUILD) and wrong combinations that match the total extrapolate
   differently to a 95 in wing. Phase A weighs every piece of stock (n >= 15, gives the balsa
   density scatter that COMPUTE_BACKLOG T1-5 needs), Phase B weighs each rib (n = 9) and each
   part, Phase C weighs the assembly and the film. K_BUILD then becomes a measured glue-and-
   assembly overhead instead of a catch-all fudge factor.
2. T-2 takes all model-critical points at 100 PERCENT THROTTLE, varying load by changing props
   rather than throttle. At full throttle the ESC is effectively a closed switch, so
   V_motor = V_batt and the Drela first-order model applies directly (drela_motorprop eqs 1-2).
   At part throttle the effective motor voltage is an extra unmeasured quantity. Part-throttle
   points are still taken for the mission energy model but tagged lower confidence.
3. T-2 always logs THRUST AND RPM TOGETHER, so measured thrust is compared against the APC table
   at matched RPM. That isolates prop model error from motor, battery and ESC error. Comparing at
   matched throttle would yield a meaningless THRUST_FACTOR.

### Finding: A_WING1 looks 2 to 4 times too high [INFERRED, computed this session]
weight.py A_WING1 = 0.05 implies 23.7 g per rib at 26 in chord (0.05 * 2.167 * 4.33 ft^2 over
9 ribs). Computed the real number: S1223 area coefficient 0.0649 (aerosandbox af.area()), so a
26 in chord section is 43.9 in^2; in 1/8 in balsa that is 8.6 g solid at 6 lb/ft^3, 11.5 g solid
at 8 lb/ft^3, and 5.2 to 6.9 g at 40 percent lightening. So a real rib is 5 to 11 g against the
model's 23.7 g. Either A_WING1 is badly overestimated (wing lighter than modeled, payload goes UP)
or it is silently absorbing capstrips, shear web and rib doublers the model names nowhere else.
T-1 settles it. This is the single most likely-to-move number in the weight model.

### Load cell sizing for the DIY thrust gauge (Jordan asked) [VERIFIED from prop_candidates.csv]
Worst-case static thrust per motor across all 2-motor candidates at the 110 A sensitivity case,
DA 1400: 12x6e 7.30, 12x8e 6.88, 11x7e 6.62, 12x10e 6.33, 11x10e 5.80, 12x12e 5.78 lbf.
4-motor candidates are about 3.2 lbf per motor.
- Max expected one motor: 7.3 lbf (3.3 kg). Design the rig to 10 lbf (4.5 kg) for model error,
  denser air and spin-up transients.
- RECOMMENDATION: 10 kg (22 lbf) load cell, single-point or S-beam, loaded in line with the
  thrust axis at 1:1. Peak then sits near 33 percent of rating. A 5 kg cell puts peak at 66
  percent, fine on resolution, thin on overload margin. Both motors on one stand would need 20 kg.
- Resolution is NOT the binding constraint: the test needs about 0.065 lbf (30 g) and a 10 kg cell
  on an HX711 beats that easily. Rigidity, alignment and overload survival are the real limits.
- [INFERRED, verify on the board] the HX711 runs 10 or 80 SPS per its RATE pin and many cheap
  breakouts tie RATE to ground for 10 SPS. That is exactly the plan's minimum with no margin for
  the D3 droop test. Pick a board exposing RATE, cut the trace for 80 SPS, or use a faster ADC.
- A bare digital kitchen or luggage scale will NOT do: no 10 Hz logging, so it cannot measure
  thrust droop over the 4.5 s roll or give the V-vs-I trace that R_BATT is fitted from.

### What the plan feeds back into (tables in TEST_PLAN.md sections 2.8 and 3.8)
T-1 -> weight.py:27 A_WING0, :28 A_WING1, :32 SPRUCE_DENS, :73-84 calibrate() (keep the NAU case
as a printed cross-check, do not delete it), :34 BATTERY_LB. Then rerun weight, sweep, design_card
and diff design_card.txt; the wing area, bay size and top rung can all move, and the 6-vs-8 slot
decision re-opens.
T-2 -> takeoff.py:33 THRUST_FACTOR; propulsion.py:35 V_OC_TO, :36 V_OC_CRUISE, :37 R_BATT,
:38 I_DESIGN, :43 MOTOR_CLASS Rm/I0 and component masses, :100 allow a measured-Kv override;
weight.py:34,:38. Then rerun propulsion, takeoff, sweep, design_card. The prop choice is genuinely
in play: 2x12x6e and 4x9x45e differ by 0.1 lb of W_TO_max, far below the model's own error.

### Stated limits of the plan [VERIFIED as written into section 6]
- T-1 gives n = 1 on K_BUILD unless a second panel is built. If only one, keep a band of at least
  x0.92/x1.08. Two panels built by two different people is the most informative version.
- T-2 is STATIC only. It cannot measure thrust lapse with airspeed, and thrust at V_R (9.5 lbf at
  36.4 ft/s) is what actually decides the 100 ft takeoff. The static test calibrates the prop
  model and the calibrated model predicts the lapse. A taped-down measurement from a moving
  vehicle is NOT a substitute. The lapse gets checked later against flight data using
  nasa_takeoff_flighttest_method (NASA TN D-7603).
- No covering-film source is archived, so film weight has no external cross-check (GAP noted at
  reference/GUIDE.md:94).
- ETA_ESC_PART (propulsion.py:39) is only indirectly checked by the part-throttle map.

### Listed but NOT done (section 7, Jordan's call)
1. Proof-load the panel to n = 3.0 after weighing, to retest SPRUCE_ALLOW 3700 psi and N_DESIGN
   (both [INFERRED]). Needs its own rig and safety case and destroys the T-1 article; build a
   third panel if wanted.
2. Static thrust in ground effect vs clear of it.
3. Rolling friction (MU_R 0.04) by towing the finished gear on the real surface with a fish scale.

### Standing guidance recorded this session
Jordan: do not wait for approval to write PROJECT_MEMORY.md entries. Write them as part of
finishing the task; he commits to GitHub himself most of the time. Saved to Claude auto-memory.

### NEXT TASK
Jordan buys the load cell and builds the thrust gauge, and the team buys wing stock. Meanwhile the
next session should either (a) resume AVL stability and trim from the VLM values (wing Cm0 -0.28,
x_np ~0.44c) as the [2026-09-19 00:28] summary planned, since T-1 and T-2 are now blocked on
hardware, or (b) write analysis/tests/reduce_panel.py and reduce_thrust.py against the CSV schemas
in TEST_PLAN.md so the reduction is ready before data exists. (b) is cheap and removes a step from
test day; (a) is the bigger open design question.

## [2026-09-21 22:51 CDT] Hardware bought, E423 locked, TEST_PLAN.md v1.1 (T-2 rewritten for real hardware)

### Decisions (Jordan, 2026-09-21)
- AIRFOIL LOCKED: Eppler E423. Supersedes the S1223 design point. At the SAME 95 x 26 in wing the
  model gives E423 trimmed CLmax 1.55 vs S1223 1.66 and payload 16.2 vs 17.4 lb
  (analysis/sizing/out/sweep_summary.txt line 20). The sizing has NOT been re-optimized for the E423,
  so design_card.txt is stale (it is still the S1223 point).
- MOTOR BOUGHT: SunnySky X2820 800 KV, original black X Series (not the "X V3" line, which has no
  800 KV). Quantity on hand: OPEN (ask Jordan).
- PROPS ON HAND: APC 9x4.5E, 9x6E, 12x6E, 12x8E, 12x10E. All five have APC PER3 data in the library.
- THRUST STAND BOUGHT: Mayatech MT10PRO 10 kg. This replaces the DIY load cell + HX711 plan in v1.0.

### X2820 800 KV datasheet [VERIFIED from the official SunnySky USA page]
Kv 800; Rm 41 mOhm; I0 0.9 A at 10 V; 46 A for 30 s max continuous; 700 W; 3-5S; ESC 60 A;
12N14P (7 pole pairs); stator 28 x 20 mm; 5 mm shaft; 138 g. No PDF exists; the page is the datasheet.
4S 100 pct points (V column is nominal 14.8 V, W = 14.8 x A, no RPM published):
  12x6 32.7 A 2240 gf 54 C | 12x8 38.5 A 2300 gf 56 C | 13x6.5 40.1 A 2670 gf 60 C | 13x8 45.2 A 2790 gf 64 C.
  The 9x4.5E, 9x6E and 12x10E are not in SunnySky's table.
Files: reference/raw/sunnysky_x2820_800kv_datasheet.txt (library ID sunnysky_x2820_800kv_spec, READ THIS ONE),
reference/raw/sunnysky_x2820_800kv.html (ID sunnysky_x2820_800kv, raw page, ~47k tokens),
reference/data/sunnysky_x2820_800kv_testdata.csv (48 rows; checked against the typed table, 20 rows, 0 mismatches).

### MT10PRO findings [VERIFIED from the reseller page, reference/text/mayatech_mt10pro.txt lines 87-111]
Thrust 0-10 kg ("down to the gram" = display resolution, accuracy unpublished), V 0-60 V, A 0-150 A,
W; motor base 16/19/25 mm; power input 5-26 V (XT60); 733 g; CNC aluminium base with bench holes.
DISPLAY ONLY: no RPM, no torque, no data logging. No official Mayatech page or manual was found.
Safety sheet archived as mayatech_mt10pro_safety (generic).
Consequences written into the plan: a separate optical tach is required; the data logger is a phone
on a tripod at 60 fps with sound (display for T/V/A/W, audio blade-pass 2 x RPM/60 for RPM, via
ffmpeg + STFT in reduce_thrust.py); the display update rate must be measured once (Run 0.5).

### Model predictions on the X2820 [computed, analysis/tests/predict_x2820.py -> analysis/tests/out/predict_x2820.csv]
Datasheet constants (Kv 800, Rm 0.041, I0 0.9, Resc 0.003), V_oc 16.0 V, R_batt 0.025 ohm, DA 1400 ft, J = 0.
  prop    stand 1 motor: rpm / g / A / pct of 46 A      aircraft: n / total lbf / pack A
  9x4.5E  11883 / 1435 / 16.6 / 36                     4 / 11.0 / 59
  9x6E    11635 / 1634 / 21.1 / 46                     4 / 12.2 / 72
  12x6E   10531 / 3024 / 41.1 / 89                     2 / 12.0 / 74
  12x8E   10074 / 3210 / 49.4 / 107                    2 / 12.5 / 88
  12x10E   9736 / 3201 / 55.5 / 121                    2 / 12.4 / 98
- 12x8E and 12x10E are predicted ABOVE the 46 A rating on a fresh pack (upper bound, see next item).
  Plan now has a current ramp rule (50 -> 75 -> 90 pct, 3 s each; above 42 A at 90 pct means no
  100 pct; above 46 A is a hard cut) and tests props in increasing load order.
- vs design card: 2 x 12x6E static was 13.2 lbf (design_card.txt, generic 42xx-50xx motor, Kv 843,
  88 A). With the X2820 the model gives 12.0 lbf; SunnySky's table implies 9.9 lbf (2 x 2240 gf).
- Model vs SunnySky at a stiff 14.8 V, sea level: 12x6 model 3056 gf 41.6 A vs 2240 gf 32.7 A (0.73
  thrust ratio); 12x8 model 3323 gf 51.1 A vs 2300 gf 38.5 A (0.69).
- Back-calculation [INFERRED]: at the RPM where an APC prop absorbs SunnySky's measured current
  (12x6 9182 rpm, 12x8 8692 rpm), SunnySky thrust is 0.943 and 0.929 of APC, i.e. right at
  THRUST_FACTOR 0.93. That fits if their motor saw only about 12.4-12.8 V (3.1-3.2 V/cell) vs the
  model's ~15 V. So the gap is most likely voltage under load, not the prop data, and it is worth
  about 30 pct of static thrust. Unconfirmed: SunnySky publishes neither its loaded voltage nor
  whether its props were E versions. Only measured V_batt + RPM on our stand settles it.

### TEST_PLAN.md v1.1 changes
- Header and section 0: v1.1 note; E423 cost at fixed geometry.
- T-1 (section 2): airfoil row E423; rib table recomputed for E423 (area coefficient 0.0827, t/c
  0.125, 55.9 in^2 at 26 in chord; 1/8 in rib 7-15 g vs the model's implied 23.7 g, a factor of
  1.6-3.6); build note on the E423 thicker TE (0.015c vs 0.008c at 95 pct chord, 0.39 vs 0.20 in);
  record as-built TE thickness at 3 ribs.
- T-2 (section 3) rewritten: 3.1 objective with model status; 3.2 hardware on hand + ESC throttle
  calibration; 3.3 equipment around the MT10PRO (hanging-mass pulley calibration up and down, tach,
  60 fps video logging, mount fit check); NEW 3.4 variables to measure (per sample: T, RPM, V_batt,
  I, P, throttle, time; per run: IDs, cell V before/after, temperatures, air density inputs, prop
  clearance; per session: cal, display rate, masses; not measured: torque, airspeed) with the
  SunnySky worked example; 3.5 predictions + current ramp rule; 3.6 methodology (video is the log);
  3.7 procedure (Run 0 setup/cal, Run A masses, Run B pack, Run C motor constants over 6 load
  points incl. no-prop Kv check 12,000-13,400 rpm, Run D thrust with D5 Y-harness downstream of the
  MT10PRO); new CSV schemas (T_g raw grams, rpm_source, pack_id, pack_fresh, video_file, t2_cal.csv);
  3.8 reduction incl. audio RPM; 3.9 gates (Kv +/-10 pct, V_batt near 12.5-13 V, 46 A per motor,
  92 A pack, motor can 158 F, pack 140 F); 3.10 code feedback.
- Section 4 safety: transmitter throttle cut + failsafe OFF test, ramp rule, leads clear of the arc.
- Section 5: Run 0 added. Section 6: no torque; MT10PRO accuracy unpublished (calibration is the only
  accuracy statement); time resolution = display rate; D5 RPM by optical tach (two audio peaks).

### Code facts checked this session
- PropSystem already accepts kv= and motor= (propulsion.py:106); callers takeoff.py:43 and
  propulsion.py:196 do not pass them. So fixing Kv at 800 is a caller change, not a model change.
- ffmpeg is installed on the laptop (winget ffmpeg full build).

### Files
New: analysis/tests/predict_x2820.py, analysis/tests/out/predict_x2820.csv,
reference/raw/sunnysky_x2820_800kv_datasheet.txt, reference/data/sunnysky_x2820_800kv_testdata.csv,
library IDs sunnysky_x2820_800kv, sunnysky_x2820_800kv_spec, mayatech_mt10pro, mayatech_mt10pro_safety.
Modified: TEST_PLAN.md (v1.1), reference/GUIDE.md (Propulsion section), reference/data/README.txt,
reference/INDEX.md and manifest.json (via doc2text).

### UNVERIFIED / OPEN
- How many X2820s are on hand, and which ESC (SunnySky recommends 60 A). Ask Jordan.
- X2820 mount holes vs the MT10PRO 16/19/25 mm patterns.
- Whether the MT10PRO's 5-26 V power input is the pack itself or a separate supply.
- Rm 41 mOhm is presumably line-to-line [INFERRED]. I0 0.9 A is at 10 V; higher at 4S speed.
- The SunnySky low-voltage explanation above [INFERRED].
- The recharge threshold of about 3.9 V/cell per resting cell in Run B5 [INFERRED].
- None of the predictions above have been checked against a measurement yet.

### NEXT TASK
Rerun the sizing with the E423 locked and the X2820 as the fixed motor (Kv 800, datasheet Rm/I0,
passed through takeoff.py:43 and propulsion.py:196) as the interim baseline, so the design card
reflects the hardware actually bought; and/or write analysis/tests/reduce_thrust.py against the
TEST_PLAN.md 3.7 schemas before test day.

## [2026-09-21 22:56 CDT] Prop ranking on the X2820 800 KV, 2-motor and 4-motor

Task: Jordan asked for a best-to-worst ranking of the props in analysis/tests/out/predict_x2820.csv for
the 2-motor and 4-motor setups. Static (J = 0) alone is not enough because T(V_R) decides the 100 ft
takeoff, so the same model was also run over the ground roll.

### Method [computed; scratch script, not saved to the repo]
PropSystem(n, prop, kv=800, X2820 datasheet motor dict, v_oc=V_OC_TO 16.0, r_batt=0.025), DA 1400 ft,
THRUST_FACTOR 1.0 (raw APC). full_throttle over 0 -> V_R 36.4 ft/s (25 points); Tmean = velocity-averaged
thrust over the roll (rough). Peak current = max over the roll (APC Cp rises with J, so the peak is not
at V = 0). Cruise: part_throttle_current at 4.22 lbf, 46.4 ft/s, V_OC_CRUISE 15.2 (design_card.txt
line 8, S1223 point, so absolute cruise numbers are stale for the E423).

  cfg        T0 lbf  Tmean  T(V_R)  Ipk/motor A  pct 46 A  pack pk A  cruise A
  2x12x6e    11.99   10.68   9.23     38.2         83        76.3      34.5
  2x12x8e    12.54   11.49  10.31     47.1        102        94.3      34.2
  2x12x10e   12.38   11.58  10.67     53.5        116       107.0      35.0
  2x9x6e      6.79    6.21   5.52     21.2         46        42.4      37.1
  2x9x45e     6.03    5.26   4.36     16.1         35        32.2      cannot hold cruise
  4x9x6e     12.19   11.04   9.69     19.1         41        76.2      33.4
  4x9x45e    11.03    9.55   7.83     14.8         32        59.3      35.3

### Ranking given to Jordan [INFERRED from the model above]
2-motor: 1) 12x8E, conditional on the stand showing <= 46 A per motor (+1.08 lbf at V_R, +12 pct over
12x6E; model peak 47.1 A = 102 pct, pack 94 A just over the TEST_PLAN 92 A gate). 2) 12x6E, the only
12 in prop with current margin (83 pct); the fallback if 12x8E reads over. 3) 12x10E, out: 116 pct of
rating, 107 A pack, and only +0.36 lbf at V_R over 12x8E. 2 x 9 in is legal but about half the thrust.
4-motor (9 in max): 1) 9x6E (T(V_R) 9.69, above 2x12x6E's 9.23). 2) 9x45E (-1.86 lbf at V_R).
On this 800 Kv motor the 9 in props run at 32-46 pct of rating, so 4 motors carry the weight of two extra
motors and ESCs without using them. The earlier "2x12x6e vs 4x9x45e within 0.1 lb" result used Kv matched
per prop and does not apply to the fixed X2820.
Cruise current is 33-37 A for every viable setup, so it does not separate them.

### UNVERIFIED
- All numbers are model output. The model is about 30 pct above SunnySky's published thrust, most likely
  loaded voltage [INFERRED, see 22:51 entry]. Lower real voltage cuts current too, which helps 12x8E's
  current case, but also cuts high-load props the most, so the 12x8E/12x10E thrust edge may shrink.
- Stand vs aircraft: one motor on the stand draws more than one motor in the aircraft (less pack sag):
  12x8E 49.4 A stand vs 44.0 A aircraft static. Judge the 46 A question with the aircraft-equivalent
  current, or with the D5 two-motor run.
- Number of X2820s on hand is still OPEN; the 4-motor option needs four.

### NEXT TASK
Unchanged from the 22:51 entry. T-2 settles the 12x6E vs 12x8E call.

## [2026-09-23 22:53 CDT] MT10PRO video reader written (read_mt10pro_video.py); 12x8E.MOV not yet processed

### What was done
- Jordan filmed the Mayatech MT10PRO screens during a 12x8E run (phone on a tripod, gantry clamped to a
  table, some wind shake). Video moved to analysis/tests/video/12x8E.MOV (201.7 MB).
- New .gitignore: analysis/tests/video/ (the video is over GitHub's 100 MB file limit) and
  analysis/tests/out/video/ (the script's regenerable cache and overlays).
- Wrote analysis/tests/read_mt10pro_video.py (v1.0, 1303 lines, accuracy over speed). Claude did NOT run
  it on the video; Jordan runs it (commands below). Only its functions were imported in scratch tests.
- Product facts (ranges, display-only, no RPM/torque/logging) are already in the 2026-09-21 22:51 entry.
  This entry adds what the video shows.

### Video [VERIFIED, OpenCV + ffprobe]
3840x2160 H.264, 30.0 fps CFR (TEST_PLAN asked for 60), 3676 frames, 122.53 s, AAC audio 48 kHz stereo.
The displays leave the picture from about frame 3580 (119.3 s). Motion blur from about 40-75 s (high
throttle).

### MT10PRO display, as read from the video [VERIFIED from frames unless tagged]
- Blue backlit dot-matrix LCD, 2 rows x 16 cells of 5x7 dots, HD44780 A00 ROM glyph forms.
  Row 0 "  34.12A  13.14V": current A (2 dp), battery V (2 dp). Row 1 "    2.0Wh 448.4W": aux field, power W (1 dp).
- Aux field cycles about every 3 s: Ap, Vm, Wp, Ah, Wh. Meanings [INFERRED from units and values]: peak A,
  minimum V, peak W, charge used, energy used. Frames 0/45/150: 0.17Ap, 15.40Vm, 1.7Wp at 0.11-0.12 A, 15.40-15.41 V live.
- Glyphs seen (18): space . 0-9 A V W p h m.
- Thrust: red-plate 7-segment LCD, 5 digits, grams [UNVERIFIED unit, none shown], triangle marker at the
  left; the leading digit was blank in every frame checked.
- Blue display refresh about 0.46 s (2.2 Hz), from frame counting in the prototype work; the script
  re-measures it and logs it. The thrust value can change on consecutive frames, so its refresh is faster
  than 30 fps can resolve [VERIFIED lower bound only]. Frames at a blue update are rolling-shutter mixes
  (upper cells from one state, lower from the next).
- |P - V x I| = 0.09, 0.18, 0.32, 0.07 W on four hand-checked states.

### Hand-checked single frames [VERIFIED; points only, not the processed run]
  frame  t s    I A     V      P W     thrust g
  1147   38.2   2.83   15.17    43.0     352
  2059   68.6  32.33   13.38   432.9    2053
  2129   71.0  34.12   13.14   448.4    2111
  2142   71.4  33.95   13.12   445.6    (not checked)
First look vs the 22:51/22:56 model [INFERRED, throttle position unknown]: the model's 12x8E stand peak is
49.4 A; 34.12 A is the highest hand-checked here. Voltage went 15.41 V at 0.12 A -> 13.14 V at 34.12 A,
an apparent source resistance of 0.067 ohm (an upper bound for pack + leads, because the open-circuit
voltage also fell as 2.0 Wh were used). The model assumes V_OC 16.0 V, r_batt 0.025 ohm. This supports the
earlier guess that loaded voltage explains the model's thrust over-prediction. Wait for the full run and
the Ap/Vm aux values before concluding.

### Script method (analysis/tests/read_mt10pro_video.py)
- Setup: scan every 15th frame; the sharpest clean in-state pair is the registration reference; up to 8
  sharp frames at least 45 frames apart train lit/unlit dot footprints by least squares (with gain
  normalization and outlier drop/relearn).
- Pass 1, per frame: color detection of both displays -> homography from the fitted outline -> masked ECC
  homography against the reference using static features only (borders, A/V/W unit glyphs, thrust
  triangle). ECC failure falls back to the outline homography. Blue: frame = plane + gain * K conv
  (sharp dot model); per-frame NNLS blur kernel K; glyph costs in dot-equivalents. Thrust: 35 segment
  darkness values, per-frame on/off levels, costs in segment-equivalents.
- Pass 2: per-cell / per-digit Viterbi (switch penalty 4.0 dot-eq blue, 1.0 seg-eq thrust; blurry frames
  down-weighted). Blue mix runs (1-3 frames) dropped; thrust 1-2 frame neighbor mixes kept, flagged
  possible_mix, and left out of T_g. P check tolerance 0.5 + 0.003 P W. T_g per blue state = mean of the
  thrust frames over that state.
- ECC finding: most frames converge in 15-50 iterations (1.0-1.9 s); frame 2058 needs 200-330 (13 s), with
  corners moving 0.42 px while the correlation changes 0.0005. Cap kept at 200 for accuracy.
- Outputs: analysis/tests/data/RUN_t2.csv (TEST_PLAN t2 columns, one row per clean blue state),
  RUN_blue_states.csv, RUN_thrust_states.csv, RUN_frames.csv; debug in analysis/tests/out/video/RUN/
  (log, setup.json, model.npz, pass-1 chunk cache, overlays). RUN defaults to the video name. An interrupted
  run resumes from the chunk cache (--fresh ignores it).

### Validation [VERIFIED, scratch tests importing the script's functions; not an end-to-end run]
- Blue reader: 832/832 cells on 26 truth frames, with the prototype footprints and with the script's own
  training path. Thrust reader: 17/17 frames. Registration and frame seek match the prototype.
- Pass-2 block executed on synthetic pass-1 data with known truth (900 frames, 49 injected mixes, blur,
  6 invalid frames): 66/66 blue states correct, T_g within 0.51 g of the true state mean, 117/117 thrust
  states, refresh period 0.4615 s recovered (true 0.4613 s).
- First 10 s: displays found and 31-32 of 32 cells decode in frames 0-299, so the smoke test is valid.

### Commands (Git Bash, repo root)
  python analysis/tests/read_mt10pro_video.py analysis/tests/video/12x8E.MOV --end 10 --run-id 12x8E_smoke
  python analysis/tests/read_mt10pro_video.py analysis/tests/video/12x8E.MOV --prop 12x8E
  (optional: --motor-id --esc-id --pack-id --pack-fresh --n-motors-live --throttle-pct, copied into t2)

### UNVERIFIED / open
- Full-video runtime: estimate 2-3 s per frame per worker, 6 workers -> about 35-75 min; share of slow-ECC
  frames unknown.
- Thrust unit (grams assumed); thrust refresh rate; latency between the thrust and blue displays (T_g
  pairing may lag); aux field meanings; throttle position during the run.
- Only the 18 glyphs above are modeled; other camera framings/orientations untested.
- RPM: the audio track is present but not processed (TEST_PLAN blade-pass method, not written yet).
- Next videos: film at 60 fps as TEST_PLAN says (30 fps cannot resolve the thrust refresh).

### NEXT TASK
Jordan runs the two commands. Next session: review 12x8E_t2.csv, the flagged states and a few overlays,
then write the audio blade-pass RPM extraction for the same video.

## [2026-09-24 03:04 CDT] 12x8E.MOV processed: video reader run reviewed, audio RPM tool written; first T-2 data

Task (Jordan, overnight, no permission prompts): run the two read_mt10pro_video.py commands, review the output
and fix the script, then write the RPM estimator. All done unattended. Nothing committed (Jordan commits).

### Video reader run [VERIFIED against hand reads of the video]
- Smoke (frames 0-299): 15.3 min, 100 pct readable, 20 blue states, refresh 0.455 s. The 12x8E_smoke_*.csv
  files are left in analysis/tests/data/.
- Full video: 3676 frames (122.5 s at 30 fps) took 171.8 min on 6 workers = 15.6 s per frame per worker
  (median 9.2 s, p90 50 s, max 105 s; slow ECC convergence dominates). The 22:53 estimate (35-75 min) was wrong.
- Readable: blue 3601 (98 pct), thrust 3596 (98 pct). All unreadable frames are at 119.3-122.5 s (unit off).
- 237 blue states (231 good, 5 short, 1 bad end state), 231 rows in 12x8E_t2.csv. 221 thrust states, 0-2193 g.
- Blue refresh 0.457 s (alignment R 0.50). Thrust value changes: median interval 0.333 s, min 0.100 s.
- Hand checks, exact match: frame 1147 2.83 A 15.17 V 43.0 W 352 g; 2059 32.33 A 13.38 V 432.9 W 2053 g;
  2129 34.12 A 13.14 V 448.4 W 2111 g; 2142 2193 g.
- |P - V x I| max 0.39 W. Fit T = 17.07 x P^0.800 g (105 states with P > 20 W, residual std 5.8 pct).
- One current spike (frame 1017, 2.91 A) is a mid-update frame and is excluded from every state.
- Fix: the run_jobs() ETA divided elapsed time by chunks done, so early in the pool it read 576 min (true
  about 150). It now counts at least one chunk per worker. Edited after the run ended, because spawned
  workers re-import the file.

### Audio RPM tool: analysis/tests/audio_rpm.py v1.0 (new)
Method:
1. ffmpeg audio -> STFT (8192 window, 20 ms hop). Stationary lines are removed.
2. Harmonic salience of the blade-pass frequency F = B x RPM/60 over 10 harmonics.
3. Sub-harmonic penalty at m = 2 and 3. For a 2-blade prop the m = 2 threshold is relative:
   max(C_THR, mean of the neighbouring harmonic levels - SUB_REL 6 dB). Without it, the 1/rev imbalance lines
   (10-18 dB below the blade-pass lines) made the tracker lock onto the shaft rate (F/2).
4. Power prior from the display states: n_lim = 1.3 x ((dP + 1 W)/(0.8 Cp_min rho D^5))^(1/3). The motor is
   treated as off when I is within 0.05 A of idle.
5. Viterbi with an unvoiced state (max jump 1/8 octave per hop), then WLS refinement on the harmonic peaks.
6. Each blue state's window is shifted by --state-lag, default -0.35 s (display latency, below).
7. APC PER3 thrust check: flag rpm_thrust_mismatch when T_meas/T_apc is outside 0.5-2.0 and
   max(T_apc, T_meas) >= 100 g. The max catches an F/2 error, which drops T_apc by 4x.
Outputs:
- data/RUN_rpm.csv (per hop) and data/RUN_rpm_states.csv.
- The rpm, rpm_source and notes columns are merged into RUN_t2.csv; rerunning the merge gives the same file.
- out/audio/RUN/RUN_rpm.png and RUN_rpm_log.txt.
- Runtime 0.2 min.
Command: python analysis/tests/audio_rpm.py analysis/tests/video/12x8E.MOV --prop 12x8E

Fixes made during review:
- The octave error at about 38 s is fixed by the relative m = 2 threshold. Verified on real and synthetic data.
- The thrust gate uses the max of T_apc and T_meas, as in step 7.
- A column-name clash with the pandas .flags attribute.
- The docstring.

Validation:
- Synthetic: state means 4999.3 / 7000.2 / 8250.0 / 2999.4 rpm (truth 5000 / 7000 / 8250 / 3000). Held states
  have an rpm std of 0.6-0.9.
- 12x8E: 3619 of 6127 hops voiced; 883-8315 rpm; no lock onto the motor whine (7F).
- States: 151 have an rpm. Flags: motor_off 35, unsteady 44, no_rpm 51, rpm_thrust_mismatch 1. The mismatch is
  state 12, the start transient (2037 rpm at 0 g, weak evidence), and it is correctly excluded.
- 150 of the 231 t2 rows have an rpm.

Display latency [measured, one video only]:
- The MT10PRO shows values about 0.35-0.40 s after they are measured. The best lag is -0.35 s for I and P and
  -0.40 s for T. The two halves of the run give -0.40 and -0.35 s.
- Fit rms improves from 4.3 to 2.5 pct for I and from 3.3 to 2.0 pct for T.
- Throttle cut: heard at 76.46-76.50 s, while the display still showed 33.49 A until 77.07 s.

### First T-2 data: X2820 800 KV + APC 12x8E on 4S [measured; throttle position not recorded]
  state  t s    rpm (std)   I A    V V    P W    T g    T_apc g  T/T_apc
  77     38.07  3502 (31)   2.83   15.17   43.0   352    388     0.908  unsteady
  143    68.33  8125 (51)  32.33   13.38  432.9  2029   2114     0.960
  145    69.27  8276 (16)  33.86   13.17  446.2  2119   2195     0.965  highest rpm
  148    70.73  8235 (13)  34.12   13.14  448.4  2111   2173     0.971  highest current
  149    71.13  8242 (5)   33.95   13.12  445.6  2108   2177     0.968
- Peaks: current 34.1 A (74 pct of the 46 A rating), rpm 8276, thrust 2120 g state mean (2193 g single frame).
- Measured / APC thrust at the audio rpm (rho 1.20, T_apc >= 200 g): median 0.957, range 0.869-1.056, n 105.
  At matched rpm the APC PER3 data holds within about 4 pct.
- Thrust offset [INFERRED, medium confidence]:
  - Below 400 g of T_apc: T_meas = 0.9986 T_apc - 27.3 g (n 39).
  - All steady states: T_meas = 0.9747 T_apc - 20.0 g (residual 13.3 g, n 107).
  - An offset that stays constant with thrust looks like stand zero or friction, not a Ct error.
  - With +27 g added, the top-end ratio is about 0.98.
  - Settle it with the TEST_PLAN Run 0.2 hanging-mass calibration (load up, then down).
- During the 69-76.5 s hold, rpm decays from 8280 to 8170 as V sags from 13.26 to 13.03 V.
- At 8276 rpm the shaft power is about 348 W (APC Cp 0.0417) against 446 W electrical, so motor + ESC
  efficiency is about 0.78 [INFERRED].
- Against the model (22:51 entry), which predicted 10074 rpm / 3210 g / 49.4 A for the 12x8E stand at full
  throttle:
  - The measured top was 8276 rpm / 2120 g / 34.1 A.
  - The throttle position is unknown, so this is not a full-throttle comparison. A Kv back-calculation
    (about 708 rpm/V if the throttle was at 100 pct) is inconclusive.
  - The prop data matches at matched rpm, so the thrust gap is in the rpm reached (motor/voltage side). This
    agrees with the 22:51 inference.
  - If the run was at full throttle, the 12x8E stays inside the 46 A rating and wins the 12x6E vs 12x8E call.
    Ask Jordan.
- After shutdown the displayed current decays from 0.44 to 0.17 A over about 25 s (idle was 0.11-0.12 A
  before). Cause UNVERIFIED; possibly current-sensor zero drift after load. Those states are not treated as
  motor off, but they are correctly flagged no_rpm.

### Files
New (untracked):
- analysis/tests/audio_rpm.py
- analysis/tests/data/: 12x8E_{t2,blue_states,thrust_states,frames,rpm,rpm_states}.csv and 12x8E_smoke_*.csv
- analysis/tests/out/audio/12x8E/ (plot 0.86 MB + log; not in .gitignore)
- analysis/tests/out/video/12x8E/ (37 MB, gitignored)
Modified: analysis/tests/read_mt10pro_video.py (the ETA line in run_jobs).
Scratch only (not in the repo): diag4.py (penalty variants), lag.py (latency fit), synthetic test data.

### UNVERIFIED / open
- Display latency (-0.35 s) is from one video only.
- --order 7 (tracking the motor whine instead of blade pass) is untested.
- The cause of the -20 to -27 g thrust offset.
- rho 1.20 is assumed: air temperature and pressure were not recorded.
- The cause of the post-shutdown current decay.
- The throttle position during the run.
- The start transient at 5.2-6.5 s is ambiguous in the audio.
- Stand vs aircraft current (22:56 entry), unchanged.

### Adjacent issues (listed, not fixed)
- The video reader is slow: 172 min for 122 s of video. ECC iterations dominate. Starting ECC from the
  previous frame's warp may cut this; worth trying before the next batch of videos.
- Blank end frames (unit off) read as thrust 0, which stretches the last thrust state.
- Post-shutdown states are flagged no_rpm, not motor_off (idle current drifts up after load).
- The smoke outputs are still in data/. Archive them once they are no longer needed.
- Next videos: 60 fps (TEST_PLAN); write down the throttle pct, air temperature and pressure; run Run 0.2.

### NEXT TASK
See the CURRENT STATE SUMMARY below.

---

## [2026-09-24 03:04 CDT] CURRENT STATE SUMMARY (after the first T-2 data; start here)

The [2026-09-19 00:28] summary (and the [2026-09-18 21:06] one it points to) still hold for rules, team,
bottles, scoring and the library, with these updates:
- AIRFOIL LOCKED: E423 (2026-09-21).
  - analysis/sizing/out/design_card.txt is STALE: it is still the S1223 point (95 x 26 in).
  - At the same wing the E423 gives CLmax 1.55 and a payload of 16.2 lb (model).
  - The sizing has not been re-optimized.
- Hardware on hand:
  - Motor: SunnySky X2820 800 KV. Quantity OPEN.
  - ESC: OPEN.
  - Thrust stand: Mayatech MT10PRO 10 kg (display only, no logging).
  - Props: APC 9x4.5E, 9x6E, 12x6E, 12x8E, 12x10E.
- Prop ranking (model, 22:56 entry): for 2 motors, 12x8E if it draws <= 46 A per motor, else 12x6E. For
  4 motors, 9x6E.
- Tests (TEST_PLAN.md v1.1):
  - T-1 wing panel weigh-in: no data logged yet.
  - T-2 thrust stand: first run done (12x8E; entry above).
- T-2 data pipeline:
  1. Phone video.
  2. analysis/tests/read_mt10pro_video.py (display values; about 15.6 s per frame per worker).
  3. analysis/tests/audio_rpm.py (rpm from blade pass; 0.2 min).
  4. Output: analysis/tests/data/RUN_t2.csv.
  - analysis/tests/reduce_thrust.py (TEST_PLAN 3.8) is NOT written yet.
- First T-2 result, 12x8E (throttle unknown): up to 34.1 A, 8276 rpm, 2120 g. APC PER3 thrust matches within
  about 4 pct at matched rpm (median ratio 0.957). There is a probable -20 to -27 g stand offset.
- Stability and trim (the 2026-09-19 NEXT TASK) is not started. AVL/XFLR5 is not installed.

### Action items for Jordan
1. For the 12x8E run: was it full throttle? Also the air temperature and the pressure or altitude. Also: how
   many X2820s are on hand, and which ESC?
2. Next stand session:
   - Film at 60 fps.
   - Run 0.2 hanging-mass calibration (settles the thrust offset).
   - Full-throttle ramps for 12x6E and 12x8E using the TEST_PLAN current rule.
   - Write down the throttle pct for each hold.
3. T-1 wing panel weigh-in (tests before analysis).
4. From the old summary: lottery interest by 2026-09-30, AMA card, sae.org affiliation (status not logged).
5. Commit the new files (audio_rpm.py, the 12x8E data, the reader ETA fix, this log).

### NEXT TASK
Write analysis/tests/reduce_thrust.py per TEST_PLAN.md 3.8, using 12x8E_t2.csv as the first input:
- air density;
- T_apc from parse_apc/coeffs in propulsion.py:51-93;
- THRUST_FACTOR_meas per prop, with the zero-offset term;
- Kv/I0/Rm fit.
Then rerun the sizing with the E423 and the X2820 as the fixed motor. Use the throttle answer from item 1
if Jordan has given it.

---

## [2026-09-24 10:11 CDT] reduce_thrust.py written; 12x8E run reduced as full throttle; ESC identified

### Jordan's answers (2026-09-24), from the 03:04 action item 1
- The 12x8E run WAS AT FULL THROTTLE at the peak thrust. It is an assumption: the stick was not recorded,
  and ESC throttle-range calibration is NOT confirmed. Full-throttle window: states 145-160 (69.3-76.5 s).
- Air: 72 F indoors (assumed, not measured), Jackson TN.
- ESC: SunnySky X series ESC X60A V2 (label ESC-X60, 2-6S, SBEC 8 A at 5.6/7.4 V) [VERIFIED sunnysky_esc_x60]:
  60 A continuous, 80 A for 10 s, 61 g, XT60 in, 3.5 mm bullets out, $45.99. Firmware, on-resistance and
  programmability for the X60A itself: UNVERIFIED. sunnysky_esc_manual (32-bit proprietary firmware; calibration =
  stick max, power on, "beep~beep" within 2 s, stick to min, cell-count beeps, long beep; default timing 15 deg,
  LVC 3.0 V/cell) is written for X45A/X65A/X85A LW/PRO; the X60A is not in its model table.
  The model's m_esc_lb 0.14 lb (63.5 g) matches the 61 g listing.
- Still OPEN: how many X2820s are on hand.

### Test conditions (analysis/tests/data/t2_conditions.csv, new; one row per run, each value with its source)
- Video metadata: 2026-09-23 20:56:43 CDT (01:56 UTC), GPS 35.6750 N 88.8635 W, iPhone 15.
- Elevation 464.1 ft [VERIFIED USGS EPQS]. KMKL field is 434.8 ft [VERIFIED airnav].
- KMKL altimeter 30.20 inHg at 01:53Z and 30.21 at 02:53Z; outdoor 68 F / dewpoint 59 F
  [VERIFIED IEM ASOS, saved as reference/data/kmkl_asos_2026-09-24.csv].
- Indoor dewpoint taken as the outdoor 59 F [INFERRED]. It is worth under 0.3 pct of density.
- Result: rho 1.1785 kg/m^3 (0.962 x ISA SL), DA 1333 ft. The 03:04 entry assumed 1.20, 1.8 pct too high.
  DA 1333 ft is close to the design DA of 1400 ft, so these numbers compare directly with the sizing.

### analysis/tests/reduce_thrust.py (new, TEST_PLAN 3.8)
Run: `python analysis/tests/reduce_thrust.py 12x8E`
- Inputs: RUN_rpm_states.csv and t2_conditions.csv.
- Outputs: analysis/tests/out/reduce/RUN_{summary.txt, points.csv, predict.csv}.
- Reuses parse_apc/coeffs (propulsion.py) and density_altitude() (density_altitude.py).
- Covers items 1, 3-9. Item 2 (rpm) stays in audio_rpm.py. Item 7 uses the hold, not a D3 burst.
- pyflakes clean. Checked by running on 12x8E: fits A and B reproduce the measured point (8218 vs 8228 rpm,
  33.6 vs 33.7 A, 2077 vs 2083 g).

### 12x8E results, full throttle (16 states, mean 8228 rpm, 33.67 A, 13.09 V, 2083 g, 441 W) [measured + INFERRED fits]
- THRUST_FACTOR_meas = 0.978 +/- 0.007 (full throttle, rho 1.1785). The median over all steady points is 0.975.
  - Offset fit over steady points: T = 0.9747 T_apc - 20 g (unchanged).
  - The APC PER3 Ct holds to about 2 pct. Gate 3.9 "0.90-1.00": PASS. The takeoff.py value is still 0.93;
    not changed yet.
- Current: 33.7 A mean, 34.1 A peak = 73-74 pct of the motor's 46 A (30 s) and 56 pct of the ESC's 60 A.
- Pack [measured]:
  - Resting before the run: 15.40 V = 3.85 V/cell. THE PACK WAS NOT FULLY CHARGED (full = 16.8 V).
  - Fit over the ramp: V = 15.37 - 68.3 mOhm x I (includes polarization).
  - Step at the throttle cut: 39.2 mOhm (13.03 V at 33.3 A -> 14.32 V at 0.44 A, 0.6 s later).
  - The model assumed V_oc 16.0 V and 25 mOhm.
  - Gate 3.9 "V_batt 12.5-13 V instead of about 15 V" is TRIGGERED (13.09 V), but partly because the pack
    was part-charged.
- Against predict_x2820 (datasheet motor, V_oc 16.0 V, 25 mOhm): rpm 0.817, I 0.682, V 0.886, T 0.649.
  Most of the gap is voltage. Fed this pack's V-I line, the datasheet motor would give 8845 rpm and 38.4 A.
  Measured rpm is 0.930 of that, which is the motor-side part of the gap.
- Motor fit. One prop = one load point, so Kv and R cannot both be pinned:
  - A (torque from APC Cp, I0 0.9 A): Kv 809 rpm/V, R_eff 86.6 mOhm, i.e. datasheet 44 mOhm + 43 extra
    (ESC, wiring, hot winding). A +/-5 pct Cp error moves Kv to 770-851.
  - B (R fixed 44 mOhm): Kv 709 rpm/V (-11.4 pct vs 800). The APC Cp would have to be x 1.141 to match the
    current. A duty ceiling near 89 pct from an uncalibrated throttle would look the same on the speed side.
  - C (free LSQ over the hold): Kv 690 +/- 20, R 35 mOhm. Leans toward B, but the hold is 7 s of warming
    winding and sagging pack, so low confidence.
  - Power balance at datasheet constants: 48 W of 441 W unaccounted (= 43 mOhm at 33.7 A). A explains it with
    resistance, B with APC Cp being 14 pct low. Either could be true [UNVERIFIED].
  - What separates them: the no-prop run on the same pack predicts about 12,340 rpm under A and 10,850
    under B. Also do the ESC throttle calibration first.
- Hold droop over 7.2 s: thrust 0.967, rpm 0.990, V 0.989. rpm^2 alone gives 0.980; the extra 1.3 pct
  may be room recirculation or stand drift [INFERRED]. Gate 3.9 (10 pct): PASS.

### Predictions at full throttle, static, rho 1.1785, thrust x 0.978 (out/reduce/12x8E_predict.csv) [INFERRED]
Fresh-pack bracket: pessimistic = V0 16.0 V with 68 mOhm; optimistic = V0 16.4 V with 39 mOhm.
  prop    per motor A, 1 motor (pct of 46 A)      aircraft 2 motors: total lbf / pack A
  12x6E   29-35 A (62-77 pct)                     7.2-9.7 lbf / 47-63 A
  12x8E   34-42 A (73-90 pct)                     7.4-9.8 lbf / 55-72 A
  12x10E  37-47 A (80-102 pct)                    7.2-9.7 lbf / 60-80 A
Fits A and B agree within about 3 pct on every 12 in case, so the prop call does not depend on the
Kv/R question.
- PROP DECISION (2-motor): 12x8E.
  - It stays under 46 A in every case (worst 41.6 A, 90 pct).
  - It gives the most static thrust of the three (1-4 pct over 12x6E).
  - Per the 22:56 rule, 12x8E wins. 12x10E: no thrust gain, and it reaches 46.8 A in the optimistic case. Drop it.
- BIG FLAG for the sizing: 2 x 12x8E gives 7.4-9.8 lbf static against 12.5 lbf in predict_x2820 / the
  sizing assumptions. The pack is the main lever: V0 and R_pack are worth about 2.4 lbf between the
  bracket ends. A pack IR check and a fully charged run are needed before the sizing rerun means much.

### Files
New:
- analysis/tests/reduce_thrust.py
- analysis/tests/data/t2_conditions.csv
- analysis/tests/out/reduce/12x8E_{summary.txt,points.csv,predict.csv}
- reference/data/kmkl_asos_2026-09-24.csv (+ README entry)
- reference: sunnysky_esc_x60, sunnysky_esc_manual (doc2text; INDEX/manifest updated; GUIDE line 61)

### UNVERIFIED / open
- Full throttle is an assumption. Whether the ESC throttle range was calibrated is unknown.
- Air temperature 72 F not measured. Indoor humidity inferred.
- Kv/R split (fit A vs B). APC Cp accuracy for the 12x8E at static (uiuc_propdb may have measured APC TE data).
- Pack identity, C rating and IR. The fresh-pack V0 bracket 16.0-16.4 V is a guess.
- Motor count on hand.
- I0 at 4S rpm (0.9 A at 10 V used).

### Adjacent issues (listed, not fixed)
- analysis/sizing/__pycache__/ is untracked and not in .gitignore.
- t2_conditions.csv is hand-entered; read_mt10pro_video.py still writes empty temp/throttle columns in RUN_t2.csv.

### NEXT TASK
Next stand session, then rerun the sizing:
1. Fully charge the pack and write down its resting V. Get the pack IR from the charger if it reports it.
2. Do the ESC throttle-range calibration (sunnysky_esc_manual steps).
3. No-prop run (C1) with the motor-whine audio (--order 7), to settle Kv (A vs B).
4. 12x8E and 12x6E full-throttle holds. Record the stick/throttle pct, a thermometer reading and Run 0.2.
Then update propulsion.py and takeoff.py per TEST_PLAN 3.10 with the measured THRUST_FACTOR, Kv/R and
pack, and rerun the sizing with the E423 and 2 x X2820 + 12x8E. If no new stand data is coming soon, run the
sizing now with the bracket above (V0 16.0/68 mOhm and 16.4/39 mOhm).

---

## [2026-09-26 12:00 CDT] 2026-09-25 T-2 session: 5 videos read, audio rpm, throttle from callouts, battery / ESC check

Task (Jordan, unattended): run the MT10PRO frame reader on the new videos (camera moved), get audio rpm despite the
spoken callouts, interpolate throttle between the logged callout points (prop_data_9.25.xlsx), put the videos in a
dated folder, and check Jordan's idea that low packs limited the motor above ~80 pct throttle.

### Layout (use this for future sessions)
- Videos: analysis/tests/video/YYYY-MM-DD/<PROP> Trial #N.MOV (gitignored, 0.6-1.6 GB each). 2026-09-25 folder:
  12X6E Trial #1/#2, 12X10E Trial #1/#2, 9X4.5E Trial #1. run_id = YYYY-MM-DD_<prop>_T<N> (e.g. 2026-09-25_12x6E_T1).
- Callouts: analysis/tests/data/2026-09-25_throttle_callouts.csv (run_id, video_file, prop, point, throttle_pos,
  thrust_callout_g, source), transcribed from prop_data_9.25.xlsx (one sheet per video). throttle_pos is the stick on
  -100..+100 (Jordan, confirmed); throttle_pct = (pos + 100) / 2.
- Per-run data (analysis/tests/data/RUN_*.csv): frames, thrust_states, blue_states, t2 (reader); rpm, rpm_states
  (audio_rpm); throttle, holds (throttle_merge). Session: 2026-09-25_battery_{runs,holds}.csv, 2026-09-25_rpm_drops.csv.
- Plots: analysis/tests/out/audio/RUN/, out/throttle/, out/battery/. Reader debug (gitignored): out/video/RUN/.
- Weather: reference/data/kmkl_asos_2026-09-26.csv (+ README entry). t2_conditions.csv: 5 new rows.

### Pipeline, in order (from the repo root)
  V=analysis/tests/video/2026-09-25; C=analysis/tests/data/2026-09-25_throttle_callouts.csv
  python analysis/tests/read_mt10pro_video.py "$V/12X6E Trial #1.MOV" --run-id 2026-09-25_12x6E_T1 --prop 12x6E --step 2 --workers 6
  python analysis/tests/audio_rpm.py "$V/12X6E Trial #1.MOV" --run-id 2026-09-25_12x6E_T1 --prop 12x6E --rho 1.175 --blades 1 --kmax 4
  python analysis/tests/throttle_merge.py $C            (all runs in the callouts file; --run-id for one)
  python analysis/tests/battery_check.py $C
Reader: about 35-180 min per video at --step 2 (30 fps effective) on this laptop, with several running in
parallel. A v1.4 re-sample of a cached run takes 15-38 min. The rest takes minutes.

### Tool changes
All four scripts carry the details and the evidence in their docstrings. All are ASCII and compile.
- read_mt10pro_video.py v1.0 -> v1.4.
  - v1.1: 59.94 fps phone video with 90 deg rotation metadata (--rotate auto). The thrust pocket runs off the
    bottom of the picture (new camera position), so it is handled as a "partial" pocket: the bottom is placed
    THR_ASPECT 0.422 x the top width down, and the sampler offset search also fits a vertical scale. Other changes:
    - ECC is masked, and thrust ECC is Euclidean.
    - ECC stops at 100 iterations or 1e-5.
    - "- 98" parses as -98.
    - Relaxed setup for blurred video.
    - Frame-count constants scale with fps.
  - v1.2: thrust top-segment (a) row refinement. A hundreds "7" was read as "1" (1745 -> 1145 g) because the
    a bar was half off its sample row. Pass-1 caches are split: blue/registration is keyed by PASS1_VERSION,
    thrust by a thrust key, so a sampler change re-samples the cached chunks in minutes instead of re-reading.
  - v1.3: sampler guard. The fitted offset is kept only if it lowers the training-frame thrust sigma below
    its value at (0, 0). 12X10E Trial #1 fitted (8, 33, 1.02) and decoded every training frame blank (sigma
    0.394 vs 0.240 at (0, 0)).
  - v1.4: thrust darkness against a per-frame background field, and a sampler geometry fit on high-power frames.
    - Cause of the remaining misreads [VERIFIED on frames]: uneven light and a moving shadow on the thrust display
      in the new camera position. Against the per-digit loop-center patches, an unlit tens "a" read 0.27 darkness
      (lit ~0.6), so a tens "1" could read "7". The v1.3 geometry of 12X10E T1 was also off (its training frames
      showed 1-2 digits, so the v1.3 fit was rejected and (0, 0, 1.0) used).
    - Darkness is now (B - I)/B, with B a robust full-cubic fit to patches in the unlit gaps between digits plus the
      loop centers, per frame. Geometry (offset, vertical scale, a row) minimizes the median decode sigma on up to 8
      high-power frames. It is kept only if it beats the v1.3 geometry. The v1.3 fit still runs (old darkness), so
      the pass-1 signature is unchanged: v1.3 caches are only re-sampled (~10-35 min per run).
    - Rejected on the way: a per-segment on/off calibration over time ("681" -> "68 ", "1627" -> "1621").
    - Pass-1 npz now keeps the (5, 7) segment darkness "tv" per frame.
    - Checks: legacy darkness bit-identical to v1.3; field darkness equals the offline prototype to 1e-16.
    - 12X10E T1: geometry (-9, 8, 0.945), a -9 px; high-power sigma 0.290 -> 0.102, training sigma 0.240 -> 0.065.
      Thrust states 315 -> 229 (under 0.1 s: 112 -> 50).
      - Hold 4 (callout 681) at 63.2-65 s: 770-778 -> 708-719 g (true ~713). 75.6 s: 1077 -> 1019 g.
      - Hold mean minus callout (max): 50.1 -> 22.6 g. The rest is real: a thrust rise after the hold-4 callout,
        sag in hold 5, and the uncalled stick push in hold 8.
    - 12X10E T2: geometry (-6, 9, 0.935), a -2 px; high-power sigma 0.100 (v1.3 geometry (-10, 25, 0.90),
      a -20) -> 0.080. Thrust states 352 -> 286 (under 0.1 s: 140 -> 74). The v1.3 misreads "1500" at 100.2 s
      and "1899"/"1878" in hold 13 are gone. Hold mean minus callout (max): 19.4 -> 17.3 g. Re-sample 30.7 min.
    - 9X4.5E T1: geometry (-7, 11, 0.935), a -2 px; sigma 0.095 -> 0.070. Hold mean minus callout (max, merge
      v1.2): 16.1 -> 6.3 g (hold 5: 16.1 -> 1.1). Short states 195 -> 192: 160 outside holds (real ramps), 29 of the
      32 inside holds are within 20 g of their neighbours (LCD digit transitions). Re-sample 37.6 min.
    - 12X6E T2: geometry (-10, 10, 0.945), a 0 px; sigma 0.069 -> 0.058. Thrust states 228 -> 177 (under 0.1 s:
      75 -> 34). Max hold error 17.5 -> 21.7 g, and both changes are real drift that v1.3 had hidden:
      - Hold 5: v1.3 read "1098" at 34.37 s and 37.67 s (true 1048/1038). That made two fake events and pulled
        the mean up to the 1040 callout. v1.4 shows a smooth drift 1040 -> 1017 g (mean 1033).
      - Hold 10: it now ends at 81.02 s, not 80.78 s. Mean 1915.5 -> 1911.3 g, with thrust decaying from 1929
        to 1885 g during the hold.
      Re-sample 15.1 min.
    - 12X6E T1 (the driver read it with v1.3 first, 178.9 min; the v1.4 re-sample took 16.3 min): geometry
      (0, 15, 0.93), a -2 px; high-power sigma 0.119 (v1.3 (-6, -6), a +8) -> 0.103, training sigma 0.051. Thrust
      states 238 -> 194 (under 0.1 s: 69 -> 38). Holds 1-9 move 0.6 g or less.
      - The v1.3 single-frame "88839" at 114.25 s (motor off, same pattern as the 9X4.5E "88880" tare state) is
        gone.
      - Hold 10: 88.9 -> -0.9 g against the callout. That comes from the throttle_merge uncalled-push rule, not the
        reader.
      - Two 0.13 s states "1094"/"1099" at 105.88-106.21 s are ramp misreads (true ~1994). They sit inside the
        uncalled push, not in a hold.
- audio_rpm.py v1.0 -> v1.3.
  - v1.1: thrust window. APC Ct(rpm) at the displayed thrust bounds F within a factor f.
  - v1.2: f 1.4 -> 1.25 (a 2/3 F alias at 270 g).
  - v1.3: tare = median of the motor-off states within 10 s of the motor-on span. It was every motor-off
    state; post-run stand handling set the 9x4.5E tare to 77 g.
  - Session flags: --blades 1 --kmax 4 (the 1/rev lines are as strong as blade-pass on these videos)
    --rho 1.175.
  - 12x8E.MOV is unchanged by v1.1-v1.3 (0 of 151 states moved > 50 rpm).
- throttle_merge.py (new, v1.3). Callouts -> throttle(t).
  - Each callout is anchored by dynamic programming to the display thrust state equal to it.
  - Stick moves are found from the thrust rate. Throttle is linear across each move and flat during holds.
  - Per-hold output: T, I, V, P, rpm, drift and events (RUN_throttle.csv, RUN_holds.csv); throttle_pct is
    written into RUN_t2.csv.
  - v1.1 pv_fallback: I = P/V where only the current cell is unreadable. The meter's P = V x I to 0.32 W.
    The readable d.ddA digits must agree mod 10 A within 0.1 A.
  - v1.2 staged stick moves: the move between two callouts also takes in any other same-direction fast thrust
    segment that is event-sized and whose blue current moves with it (dI/I >= 0.75 dT/T; a prop gives ~1.5).
    v1.1 kept only the largest segment, so a second stage > 1.2 s later stayed in the next hold. Cleaner v1.4
    thrust states exposed it: 12X10E T2 hold 11 started at 96.00 s during the move (mean 1586 g, callout 1600);
    v1.2 starts it at 97.55 s (1598 g). Changed 4 holds (12X10E T1 7, 12X10E T2 9 and 11, 9X4.5E 5), each mean
    moved toward its callout. 12X10E T1 hold 4 (+29 g at 62.93 s, I 8.14 -> 7.96 A) stays an in-hold event.
  - v1.2 uncalled stick push: a rising segment after the last callout that passes the same current test ends
    the last hold. Throttle is blank after it, and the phase is "uncalled" until the cut (flag
    uncalled_move_after). Found twice:
    - 12X6E T1 105.37-106.49 s, +378 g, I 21.55 -> 29.51 A. Hold 10 (stick 58) was 94.94-110.15 s, mean
      1790 g against the 1701 callout. Now 94.97-105.37 s, 1700 g.
    - 12X10E T1 111.05-111.51 s, +80 g, I 31.58 -> 36.69 A. Hold 8 (stick 70) mean 1767.6 -> 1751.3 g
      (callout 1745). 110 more throttle rows are blank.
    The stick position in these two windows is unknown. They are the highest-power parts of both runs, and they
    are where the full-throttle windows below come from.
  - v1.3 overshoot pulled back: after a stick move, an opposite-sign fast segment before the next callout state that
    passes the current test with the sign reversed also belongs to the move (flag overshoot_before). Two found:
    - 12X10E T1 move 0 -> 20: thrust 1093-1100 g, then 68.67-69.30 s -44 g with I 14.92 -> 13.66 A (ratio +2.0),
      callout 1030 at 73.48 s. Hold 5 mean 1044.1 -> 1035.1 g.
    - 12X10E T2 move 40 -> 50: 1486-1491 g, then 88.77-88.97 s -36 g, I 24.03 -> 23.09 A (+1.6), callout 1435 at
      91.00 s. Hold 10 mean 1452.3 -> 1443.8 g.
    The other opposite-sign segments score -0.53 to +0.22, so the 0.75 threshold separates them cleanly. No other
    hold changed. During the overshoot, throttle(t) is below the true stick (linear interpolation) [known limit].
- battery_check.py (new, v1.4). Per run and session:
  - Resting V before/after, pack line V0/R, V min loaded vs the 12.0 V LVC reference.
  - Duty d = (rpm/Kv + I R)/V per hold, with 12x8E fits A (Kv 809, R 86.6 mOhm) and B (709, 44 mOhm).
  - Sudden audio-rpm drops (>= 3 pct), classified against the display thrust (tracking artefact or real)
    and the blue I/V (load shed, or I and V unchanged).
  - ESC 3-beep alarm-group scan of the audio. The only 3-beep pattern in the SunnySky manual is LVC.
  - Plots.
  - v1.4: session CSVs written with %.6g (v1.3's %.4g wrote rpm >= 10000 as 1.004e+04).

### Results per run
Final data: reader v1.4, audio_rpm v1.3, throttle_merge v1.3, battery_check v1.4 (all 5 runs re-run on it).
Runs in time order (video start, CDT 2026-09-25): 12x6E T1 20:12, 12x6E T2 20:25, 12x10E T1 20:33, 9x4.5E T1 20:40,
12x10E T2 20:45.
  run          callouts  |hold mean - callout| max / median  holds with rpm  top of the run: T, rpm, I, V (stick)
  12x6E_T1     10        4.8 / 0.9 g                          9/10           2028 g, 8585, 29.5 A, 13.28 V (uncalled)
  12x6E_T2     10        21.7 / 4.2 g (real drift, hold 10)   10/10          1979 g, 8440, 29.2 A, 13.07 V (82)
  12x10E_T1    8         17.5 / 5.7 g (hold 4 real +29 g)     6/8            1823 g, 7337, 36.6 A, 12.22 V (uncalled)
  9x4.5E_T1    11        6.3 / 0.9 g                          11/11          1006 g, 10041, 13.3 A, 13.93 V (80)
  12x10E_T2    13        9.8 / 2.1 g                          12/13          1844 g, 7386, 36.4 A, 12.24 V (80)
- The callouts are the display values read aloud, so "hold mean - callout" checks the reader plus the hold finder.
  The holds without rpm are the lowest sticks (18-95 g), flagged no_rpm.
- throttle_pct in RUN_t2.csv is filled only between the first and last hold. It is blank before spool-up, in the
  uncalled windows and after the cut.
- The top-of-run numbers are wduty windows (overlap-weighted clean blue states, voiced audio hops) for the uncalled
  windows, and hold means otherwise.
- t2_conditions.csv: ft_t_start_s / ft_t_end_s filled for the 5 runs, each with its evidence in notes:
  - 12x6E_T1 106.49-110.42 s (uncalled)
  - 12x6E_T2 64.02-81.02 s (sticks 82 + 100)
  - 12x10E_T1 111.51-114.52 s (uncalled, ends before the LVC drop)
  - 9x4.5E_T1 68.84-96.76 s (sticks 80/91/100)
  - 12x10E_T2 109.33-113.25 s (stick 80, ends before the LVC drop)
  These windows are the ESC ceiling. Whether the ceiling is 100 pct duty is NOT known (see verdict).
- reduce_thrust.py was NOT run on these runs. It finds few clean rpm_states in the windows (most are flagged
  unsteady), and 12x6E_T2 has no per-state I_A. Use RUN_holds.csv and 2026-09-25_battery_holds.csv.

### Battery / ESC verdict (Jordan's question)
Jordan's report: both packs were low; above about 80 pct throttle the rpm sometimes dropped suddenly; was the low
battery limiting the motor? I read "80" as the stick value 80 on the -100..+100 callout scale (90 pct of travel)
[ASSUMPTION]. Nothing changes at stick 60, so the answer is the same if it meant 80 pct of travel.

Short answer: partly right. Two different things happened, and only one of them was the battery.

1. The sudden drops were the ESC low-voltage cutoff (LVC), caused by the low packs. Only the 12x10E runs hit it:
   they drew the most current (36-37 A) and ran on the lowest packs (14.69 and 14.76 V resting).
   [VERIFIED on the display, the blue meter and the audio; that it is LVC: medium-high]
   - 12x10E T1 (stick unknown, after an uncalled push past 70): at about 115.0 s thrust went 1818 -> 540-548 g,
     I 36.3 -> 7.4 A, V 12.17 -> 13.15 V (audio rpm 7346 -> about 4190 at 114.75 s).
   - 12x10E T2 (stick 80, 3.9 s into the hold): at 113.45 s thrust went 1854 -> 546-548 g, I 36.2 -> 7.4 A,
     V 12.20 -> 13.2-13.3 V (audio 113.55 s).
   - Why LVC and not the stick:
     a. The loaded V was 12.17-12.20 V, only 0.17-0.20 V above the 12.0 V cutoff (the manual's default is
        3.0 V/cell).
     b. Both runs dropped to the same level, 540-548 g at 7.4 A (about 0.5 of the ceiling duty), and held it
        until the operator cut (2.7 s and 1.0 s later). That matches the manual's default LVC "Reduce Power" mode.
        A hand on the stick would not land on the same level twice.
        The manual says 70 pct power in one place (line 25) and "at most 50 pct" in another (lines 123-125).
        Measured: 97 W against 442 W before the drop.
     c. The 3-beep alarm group (the manual's LVC alarm, line 145) started after the cut, at 118.9 s and 115.5 s.
        No other run had an alarm group.
2. The flat top was not the battery. Every run that went past stick 70 reached the same ESC output ceiling, and
   where the stick is known it got there by stick 80-82. From there to stick 100, rpm and current stay flat and
   thrust drifts down with pack sag:
   - 12x6E T2: 1979 g at stick 82 -> 1911 g at 100.
   - 9x4.5E: 1006 g at 80 -> 966 g at 91 -> 941 g at 100.
   This slow fall in thrust at higher stick may be part of what felt like the rpm dropping at the top.
   - One ceiling [fit VERIFIED numerically; meaning INFERRED, high]. All 8 top-end points sit on one motor line,
     rpm = 776.1 x (V - 0.0750 x I), to within 0.3 pct. They span 4 props, 2 sessions, 13-37 A and 12.2-13.9 V:
       12x8E 09-23 top +0.3, 12x6E T1 uncalled -0.1, 12x6E T2 st82 -0.1, st100 -0.0,
       12x10E T1 uncalled -0.2, 12x10E T2 st80 +0.0, 9x4.5E st80 +0.1, st100 -0.1 pct.
     The line is the ESC ceiling: K = Kv x dmax and R' = R / dmax^2. The motor sees I/d under PWM.
   - Relative duty from that line rises linearly with stick: 0.0057 per stick unit, rms 0.031 over 40 holds.
     It is 0.87-0.88 at stick 58-60, 0.94-0.95 at stick 69-70, and 1.00 from stick 80-82 on.
     The linear fit reaches the ceiling at stick 82 and zero near stick -93 (rough).
   - A low pack lowers rpm at every stick (rpm ~ d x V), but it cannot move the stick where the ESC tops out.
     [INFERRED, high that the plateau is not the battery]
   - Most likely cause: the ESC's stored throttle range does not match this radio, so the ESC reaches its maximum
     at about stick 80 [INFERRED, medium]. Radio endpoints, travel or a throttle curve could do the same.
   - Whether the ceiling is 100 pct duty is unknown.
   - The 12x8E "full throttle" point from 2026-09-23 is on the same line, so it was this same ceiling.
3. 12x6E T1: the callouts stop at stick 58. An uncalled push then took it to the same ceiling (-0.1 pct from the
   line) at 13.24-13.33 V, 1.24 V above the cutoff. No alarm, and a clean throttle cut at 110.4 s (2023 -> 23 g).
   No sudden drop.
4. The other real drops were throttle movements, not the battery.
   - 12x6E T2 at 81.2 s (audio 80.95 s): the cut at the end of the stick-100 hold (1889 -> 189 -> 0 g). It happened at 12.95 V,
     with no alarm and no reduced-power level.
   - 12x10E T1 at 68.95 s: the stick overshoot pulled back before callout 20 (-3 pct).
   - 9x4.5E at 97.95, 100.75 and 102.45 s: the operator stepped the throttle down in about 100 g steps
     (938 -> 100 g over 7 s), 1.9-2.3 V above the cutoff.
   The other 11 audio drops are tracking artefacts: the display thrust did not move.

Pack state:
- Resting V at the start of each run: 15.55, 15.01, 14.69, 15.06, 14.76 V (3.89-3.67 V/cell; full is 4.20).
  After the last run: 13.97 V (3.49 V/cell).
- Pack line V0 / R: 14.67-15.55 V / 64-85 mOhm.
- Loaded minimum: 12.17-13.83 V.
- Which pack was on which run was not logged.

Kv consequence (corrects the 2026-09-24 plan):
- The ceiling line gives only Kv x dmax = 776 rpm/V and R / dmax^2 = 75 mOhm.
- Fit B (Kv 709, R 44) would need dmax = 1.09 > 1, so it is excluded [INFERRED, medium-high].
- Fit A (Kv 809) implies dmax 0.96 and R about 69 mOhm.
- If dmax = 1: Kv 776 and R 75 mOhm (datasheet 44 + about 31 mOhm of ESC, wires and hot winding).
- A no-prop run at full stick also measures only Kv x dmax, so it cannot split them by itself.
- What splits them: calibrate the ESC first (then dmax is presumably 1 [UNVERIFIED]), or back-drive the motor
  (drill, phase voltage and rpm), or read the ESC's throttle telemetry. The manual lists telemetry, but it is
  UNVERIFIED for the X60A.
- For sizing on these packs and this ESC setting, the ceiling line is the measured top end:
  rpm_max = 776 x (V - 0.075 I).

What would settle it:
1. Fresh packs: 4S full is 16.8 V.
2. ESC throttle-range calibration to this radio, per reference/text/sunnysky_esc_manual.txt lines 116-133
   (X45/65/85 manual, UNVERIFIED for the X60A):
   a. Radio on, stick at the top.
   b. Connect the battery and wait 2 s for two beeps.
   c. Within 3 s, pull the stick to the bottom.
   d. N short beeps (the cell count), then a final long beep.
3. One 12x10E run to stick 100, with callouts at 60/70/80/90/100.
If duty keeps rising past stick 80 (rpm above the 776 line) and no alarm sounds, both findings are confirmed.

### UNVERIFIED / open
- ESC and motor for 2026-09-25 are assumed to be the same as for 12x8E (X60A, X2820 800KV) [UNVERIFIED].
  - The archived SunnySky manual is for the X45A/X65A/X85A.
  - The LVC default (3.0 V/cell, 12.0 V on 4S), the "Reduce Power" mode and the 3-beep LVC alarm come from it
    [UNVERIFIED for the X60A].
- ESC throttle-range calibration: not known (Jordan: "Not sure").
  - The ceiling at about stick 80 is explained by an uncalibrated range [INFERRED, medium].
  - Other causes are not excluded: radio endpoints or travel below 100 pct, a throttle curve, ESC limits.
- dmax (the ESC ceiling as a fraction of full duty) is unknown, so Kv and R are not separated (see the verdict).
- "80 pct" was read as stick 80 [ASSUMPTION; the conclusion does not depend on it].
- Indoor temperature 72 F assumed (not measured on 2026-09-25); indoor dewpoint = outdoor KMKL [INFERRED].
- Which of the two packs was on which run: not logged.
- The duty in battery_check.py v1.4 uses d = (rpm/Kv + I R)/V with the 12x8E fits.
  - It ignores that the motor sees I/d under PWM, so it reads about 0.01-0.02 low at stick 58-70.
  - It is exact at the ceiling.
  - The stick-duty numbers in the verdict use the PWM form and the ceiling line [INFERRED model].
- 12x10E T2 hold 2 (stick -40): audio rpm mixed (2215 median, likely about 2450) [UNVERIFIED].
- 12x6E T2 blue display from 56.9 s: glare and blur on the left LCD cells. I comes from P/V where the digit check
  passes.
- Thrust states under 0.1 s still exist (LCD digit transitions). Holds use means over long states.
- 12x10E T1 hold 5: a 1-frame v1.4 "1000" misread at 68.94 s, inside the overshoot (minor; the hold starts at
  69.30 s).
- During the two overshoots (12x10E T1 68.67-69.30 s, T2 88.77-88.97 s), throttle(t) is below the true stick
  (linear interpolation).

### Adjacent issues (listed, not fixed)
- 12x8E.MOV (2026-09-23) is not in a date folder, and prop_data_9.25.xlsx sits at the repo root.
- analysis/tests/__pycache__/*.pyc files show up in git status (one is tracked). A .gitignore entry would fix it.
- The 12x8E audio rpm was run with rho 1.200 (out/audio/12x8E summary), not the air() value of its t2_conditions
  row. rho only sets the APC thrust window, not the rpm itself [INFERRED].
- reduce_thrust.py needs states with flags == "" and with I_A and rpm, and it has no I = P/V fallback. The
  2026-09-25 windows are mostly "unsteady", and 12x6E_T2 has no per-state I_A. Its full-throttle model
  (V_motor = V_batt) does not hold if the ceiling is below 100 pct duty.
- battery_check.py could carry the ceiling-line fit and the PWM duty form. Both were done here in scratch; the
  inputs are listed in the verdict.
- Reader: the a-row sweep limit (+-20 px) was touched on 12x10E T1 (band -20..+2). Widen it if a run needs it.
- rh_pct in t2_conditions.csv is blank for all rows (RH is computed from the dewpoint by design).
- The read_mt10pro_video.py v1.2 docstring says thrust has "a separate cache key". Since v1.4 the key is
  SCRIPT_VERSION|offset|a-row and the geometry fit is in setup (imprecise wording, not a bug).
- The Gmail and Google Calendar MCP connectors need authorization in claude.ai connector settings (not used here).

### NEXT TASK
Next stand session (T-2), before any sizing rerun:
1. Fully charge both packs and write down the resting V and which pack goes on which run.
2. Do the ESC throttle-range calibration (steps in the verdict).
3. Re-run one 12x10E and one 12x8E to stick 100, with callouts at 60/70/80/90/100. Check that rpm rises above the
   776 x (V - 0.075 I) line and that no LVC cut happens.
4. If possible, check Kv directly (back-drive, or ESC telemetry).
Then feed the measured top end into propulsion.py and takeoff.py (TEST_PLAN 3.10) and rerun the sizing with the
E423.

---

## [2026-09-26 12:01 CDT] CURRENT STATE SUMMARY (after the 2026-09-25 T-2 session; start here)

The [2026-09-24 03:04] summary still holds (rules, team, library, TEST_PLAN, T-2 pipeline), with these updates:
- AIRFOIL LOCKED: E423.
  - analysis/sizing/out/design_card.txt is still STALE (S1223 point).
  - The sizing has not been rerun.
- Hardware:
  - Motor: SunnySky X2820 800 KV. Quantity OPEN.
  - ESC: SunnySky X60A V2.
  - Two identical 4S packs, both low on 2026-09-25. Capacity, C rating and IR are not logged.
  - Stand: MT10PRO.
  - Props: APC 9x4.5E, 9x6E, 12x6E, 12x8E, 12x10E.
- Prop decision (2026-09-24, 2-motor): 12x8E. The 2026-09-25 data does not change it.
  - At the same ESC ceiling on low packs:
    - 12x6E: 2028 g, 29.5 A at 13.28 V.
    - 12x10E: 1823-1844 g, 36.4-36.6 A at 12.2 V, and it tripped the LVC.
    - 12x8E (2026-09-23): 2083 g, 33.7 A at 13.09 V.
  - The packs differ between runs, so this is not a clean comparison [INFERRED].
- BIG FLAG (2026-09-24) still stands: 2 x 12x8E gives 7.4-9.8 lbf static, against 12.5 lbf in the sizing.
- NEW:
  - All stand data so far is at an ESC output ceiling that is reached at about stick 80. It may be below full
    duty (ESC throttle range probably not calibrated [INFERRED, medium]).
  - Measured top end on this setup: rpm_max = 776 x (V - 0.075 I), within 0.3 pct over 4 props.
  - Fit B (Kv 709) is excluded. Kv and dmax are not separated.
- T-2 pipeline (analysis/tests/; order and commands in the entry above):
  1. read_mt10pro_video.py v1.4
  2. audio_rpm.py v1.3
  3. throttle_merge.py v1.3 (throttle from spoken callouts)
  4. battery_check.py v1.4
  reduce_thrust.py has only been used on 12x8E. Videos go in analysis/tests/video/YYYY-MM-DD/.
- T-1 wing panel weigh-in: no data logged yet.
- Stability and trim: not started.

### Action items for Jordan
1. Commit. New: throttle_merge.py, battery_check.py, the 2026-09-25 data CSVs, out/audio|throttle|battery plots,
   reference/data/kmkl_asos_2026-09-26.csv. Modified: read_mt10pro_video.py, audio_rpm.py, t2_conditions.csv,
   reference/data/README.txt, and this log. prop_data_9.25.xlsx is still at the repo root.
2. Next stand session (NEXT TASK below). Write down which pack goes on which run.
3. T-1 wing panel weigh-in (tests before analysis).
4. From the old summary: lottery interest by 2026-09-30, AMA card, sae.org affiliation (status not logged).
5. How many X2820s are on hand (still OPEN).

### NEXT TASK
Next stand session:
1. Full packs.
2. ESC throttle-range calibration.
3. 12x10E and 12x8E to stick 100, with callouts at 60/70/80/90/100.
4. A Kv check if possible.
Then process it with the 4-step pipeline and rerun the sizing with the E423.

---

## [2026-09-26 19:59 CDT] Max-thrust layout prediction: 2 x 12 in vs 4 x 9 in, calibrated to the stand data

Task (Jordan): from the existing prop data, predict which setup gives the most thrust under ideal conditions,
2 or 4 motors, and which props.

### Method (analysis/tests/predict_config.py, new; out/predict_config/{calibration.csv, predict.csv, summary.txt})
Run: `python analysis/tests/predict_config.py`
- Top end = the measured ESC-ceiling line, rpm = K (V - R' I). Refit over 9 ceiling points gives K 776.2,
  R' 75.0 mOhm (log line 776.1 / 75.0, max err 0.35 pct) [VERIFIED numerically].
- Battery current I = c0 + K_si k_q Q_apc. This works at any duty because I = d I0 + (Kv d) Q. c0 = 0.9 A.
- Thrust = k_t T_apc. N identical motors on one pack: V = V0 - N I R_pack.
- Per-prop factors against APC PER3 [computed from the holds files and 12x8E_points.csv]:
    prop    k_t (upper half of thrust range)  k_t all holds  k_q (ceiling points)
    12x6E   1.018 (n 10)                      1.006          1.113 (n 3)
    12x8E   0.981 (n 43)                      0.975          1.042 (n 1, 2026-09-23)
    12x10E  1.009 (n 11)                      1.006          1.170 (n 2)
    9x4.5E  0.973 (n 6)                       0.950          1.150 (n 3)
  - k_t rises with rpm: 12 in props read 0.88-0.94 below 4500 rpm and 0.98-1.04 above 6000. Hence the
    upper-half rule.
  - APC Cp under-predicts the torque by 4-17 pct, so the measured current is higher than APC implies.
- 9x6E was never on the stand. It borrows the 9x4.5E factors. Band = worst/best factor pair over all 4 tested props.
- Scenarios [INFERRED brackets]:
  - ESC "as set": 776 / 75 mOhm. ESC "calibrated": 809 / 69 mOhm (fit A, dmax 0.96).
  - Pack "fresh ideal": 16.4 V, 39 mOhm. Pack "fresh real": 16.0 V, 68 mOhm.
  - DA 1400 ft. V_R 36.4 ft/s (from the stale S1223 card).
- Gotcha found: in 12x8E_points.csv, T_over_Tapc is from audio_rpm at rho 1.200. The reduce_thrust ratio at the
  run's rho 1.1785 is T_ratio (0.975). Use T_ratio.

### Results: totals per aircraft, full throttle, nominal factors (lbf, static T0 / at V_R)
    layout      as set+ideal   as set+real   calib+ideal   calib+real   calib+ideal: A/motor, pack A
    2 x 12x8E   9.80 / 7.71    7.91 / 5.97   10.22 / 8.07  8.16 / 6.17  41.0 (89 pct of 46), 82
    4 x 9x6E    9.75 / 7.43    7.83 / 5.68   10.23 / 7.84  8.12 / 5.93  18.9 (41 pct), 76
    2 x 12x6E   9.65 / 7.09    7.88 / 5.54   10.11 / 7.48  8.16 / 5.78  35.2 (77 pct), 70
    4 x 9x4.5E  9.07 / 6.21    7.43 / 4.84    9.56 / 6.64  7.75 / 5.12  15.2 (33 pct), 61
    2 x 12x10E  9.18 / 7.47    7.30 / 5.68    9.53 / 7.77  7.49 / 5.83  48.0 (104 pct), 96
- 4 x 9x6E band (calibrated + ideal): 10.16-11.12 lbf static, 7.78-8.60 at V_R.
- Sensitivity (calibrated + ideal):
  - c0 0.5 A: 2x12x8E 10.21 vs 4x9x6E 10.19 static. c0 1.5 A: 10.23 vs 10.28. The static order flips.
    V_R: 12x8E +0.22-0.25 lbf both ways.
  - Stiff 16.8 V, 0 ohm pack (theoretical bound):
    - 4x9x6E 15.23 / 12.64 at 28 A per motor.
    - 2x12x8E 15.01 / 12.69 at 60 A per motor. That is over the motor's 46 A and at the ESC's 60 A. Not reachable.
- APC-only props (not on hand, borrowed factors): 4 x 9x7.5E 10.29 / 8.40 nominal (calib+ideal), which is within
  about 1 pct of the leaders. The 11 in props and the 12x12E are worse. 12x12E is at 111 pct of 46 A.

### Answer given to Jordan [INFERRED from the model]
- STATIC thrust is a tie: 4 x 9x6E and 2 x 12x8E, about 10.2 lbf under ideal conditions. They are within 0.5 pct,
  which is inside the model error [confidence low on the order].
- At takeoff speed, 2 x 12x8E is ahead by about 3 pct in all 4 scenarios [medium].
- Recommendation unchanged: 2 x 12x8E.
- 12x10E is out: the least 12 in thrust and over 46 A. 4 x 9x4.5E is last or next to last.
- 4 x 9x6E is the only layout with a real upside, because its factors are borrowed.
  - One stand run of the 9x6E would settle it. The prop is on hand.
  - A 4-motor layout also needs 4 X2820s and 4 ESCs, and carries about 0.4 kg more motor+ESC mass.
    Motor count on hand is still OPEN.

### Findings to carry forward
- LVC risk: on the "fresh real" pack (16.0 V, 68 mOhm), 2 x 12x8E sags to 11.5-11.8 V and 4 x 9x6E to 11.9 V.
  Both are below the 12.0 V default LVC [INFERRED; LVC value UNVERIFIED for X60A].
  - So pack IR and the LVC setting matter as much as the prop choice.
- Pack current is 76-82 A for either leader, about 35-37C on 2200 mAh. The pack C rating is still not logged.
- BIG FLAG stands: best case about 10.2 lbf static against 12.5 lbf in the sizing.

### UNVERIFIED
- 9x6E factors (borrowed). The ESC-calibrated case (Kv 809 / dmax 0.96 is fit A, not measured). Both pack brackets.
- k_t and k_q are calibrated at J = 0 and applied at V_R. Thrust lapse with airspeed is unmeasured.
- k_q for 12x8E rests on 1 point from a different day.
- There is no prop-prop or airframe interference, and no harness resistance beyond the pack R.

### NEXT TASK
Unchanged (next stand session), plus one item: add a 9x6E run to stick 100. It is the only prop that could beat
the 12x8E, and the model cannot settle that without data.

---

## [2026-09-28 15:02 CDT] Memory system: STATE.md hot cache + DECISIONS.md register + memcheck (after claude-obsidian)

Task (Jordan): use github.com/AgriciDaniel/claude-obsidian (v2.2.0) to optimize memory for this project.

### What was adopted, and what was not
- Adopted the patterns only. The plugin itself was NOT installed: its mutation core refuses native Windows and
  Git Bash (UNSUPPORTED_PLATFORM; needs WSL/Linux/macOS) [VERIFIED in its compound-vault-guide.md].
- claude-obsidian -> this project:
  - wiki/hot.md (bounded cache, under 500 words, refreshed on every save) -> STATE.md.
  - claim/source ledger (status, support, confidence, contradictions visible) -> DECISIONS.md.
  - wiki-fold (extractive rollups; every line cites its child entry) -> citation rule: every STATE/DECISIONS
    item cites a log entry [YYYY-MM-DD HH:MM]. Folds themselves are deferred (not needed yet).
  - SessionStart hook injecting hot.md -> a native `@STATE.md` import in CLAUDE.md. No hook, no python on
    PATH needed. Claude Code docs: @imports expand at launch; the project-root CLAUDE.md is re-read after
    /compact [VERIFIED reference/text/cc_memory.txt lines 103-107, 586].
  - wiki-lint (deterministic, read-only) -> tools/memcheck.py.

### New files
- STATE.md: hot cache, 500 words max, overwritten at every checkpoint, auto-loaded through the CLAUDE.md
  import. Sections: Reflects log through, Phase, Hardware, Key numbers, BIG FLAG, Decisions in force,
  Open items, NEXT TASK.
- DECISIONS.md: 34 rows (R1-R8 rules, D1-D10 design, H1-H5 hardware, N1-N9 numbers, P1-P2 process).
  Columns: ID | decision/number | status (LOCKED/CURRENT/OPEN/SUPERSEDED) | conf | source | overturned by.
  Rows are never deleted; a changed decision gets a SUPERSEDED old row plus a new row.
- tools/memcheck.py (read-only). Checks:
  - log is ASCII; the committed HEAD copy is a byte prefix of the working copy (append-only);
    headers in time order (warning);
  - STATE.md is ASCII, <= 500 words, has the sections, and is not older than the newest log entry;
  - DECISIONS.md IDs unique, status/conf valid, every row cites an entry;
  - every cited [timestamp] exists as a log header; backticked paths exist.
  - Tested in a scratch git repo: stale cache, edited log line, duplicate ID, bad status, bad conf,
    missing citation, missing path, non-ASCII, over 500 words, missing section and CRLF working copy
    all behave as intended [VERIFIED this session].

### Changed files
- CLAUDE.md:
  - New session start: STATE.md (auto) -> grep DECISIONS.md -> grep the cited log entry and read only it.
  - New checkpoint: log entry -> DECISIONS.md rows -> rewrite STATE.md -> `python tools/memcheck.py`.
  - Agents never write STATE.md or DECISIONS.md either.
- AI_WORKFLOW.md: file table, session loop, section 7, cheat sheet.
- .claude/agents/sae-analyst.md and sae-researcher.md: read STATE.md/DECISIONS.md instead of the last summary.

### Supersedes (RULES amendment; rules 1-6 and 8-9 unchanged)
- Rule 7 and the old session-start protocol ("read the RULES header, then the LAST CURRENT STATE SUMMARY
  and every entry after it") are SUPERSEDED. Sessions now start from STATE.md.
- CURRENT STATE SUMMARY entries are now written only at the end of a design phase, as a copy of STATE.md,
  and must be self-contained (no "the older summary still holds" chains). The ~400-line trigger is dropped.
- This log stays the source of truth and stays append-only. STATE.md and DECISIONS.md are derived and may be
  overwritten (git history + vault snapshots keep old versions). If they disagree with the log, the log's
  latest entry wins.

### Numbers (session-start context, bytes; about 4 bytes per token [INFERRED rule of thumb])
- Before: CLAUDE.md 3166 + log header 2993 + latest summary and after 7856 = 14015 B. Following the
  "still holds" chain to the 09-24, 09-19 and 09-18 summaries: +8180 = 22195 B. Also 2-5 extra Read calls.
  It also grew with every entry after the last summary (up to about 400 lines).
- After: CLAUDE.md 4100 + STATE.md 2730 = 6830 B, loaded with no tool calls. The cap is about 500 words.
  DECISIONS.md (6688 B) is grepped, not read.
- Result: about 51-69 pct less at session start, and the cost no longer grows with the log.

### UNVERIFIED
- The VS Code extension expanding `@STATE.md`. Check: after a restart or /clear, /context -> Memory files
  should list STATE.md, or ask Claude for the NEXT TASK without letting it read files.
- The import being re-expanded after /compact (the docs say the project-root CLAUDE.md is re-injected).

### NEXT TASK
Unchanged: the next stand session (see STATE.md NEXT TASK).

---

## [2026-09-30 06:59 CDT] 2026-09-29 T-2 session: 3 videos read (reader v1.5 thrust refine), audio rpm, throttle from callouts, battery / ESC check

Task (Jordan, unattended overnight): pull the frames from the new videos and write the data to CSV "same as before"
(the 2026-09-25 pipeline, [2026-09-26 12:00]). Interpolate throttle from Throttle Data 9.29.xlsx (stick position
vs thrust in grams). State assumptions; ground decisions in data.

### Inputs and layout
- Videos (gitignored): analysis/tests/video/2026-09-29/{9X6E, 12X8E, 9X4.5E} Trial #1.MOV. run_id
  2026-09-29_<prop>_T1. Jordan wrote "4 video files"; there are 3 videos plus the Excel.
- Callouts: analysis/tests/data/2026-09-29_throttle_callouts.csv, 49 rows (13 / 18 / 18), transcribed from
  Throttle Data 9.29.xlsx (repo root, like prop_data_9.25.xlsx; one sheet per video) by make_callouts.py (scratch,
  not in the repo). Every sheet says "Battery A, Fully Charged". No sheet mentions the ESC calibration.
  throttle_pos is the stick -100..+100 as on 2026-09-25 [ASSUMPTION, same sheet layout]; throttle_pct = (pos+100)/2.
- Video metadata (ffprobe): 9x6E 19:54:17 CDT, 105.2 s; 12x8E 20:08:14, 159.0 s; 9x4.5E 20:42:08, 167.7 s. Phone GPS
  35.6750-35.6751 -88.8633/-88.8634, the same site as 2026-09-25 (t2_conditions.csv), elev 464 ft.
- Weather: reference/data/kmkl_asos_2026-09-30.csv (+ README entry). KMKL 00:53Z 67 F, dewpoint 52, 29.96 inHg;
  01:53Z 62 F, dewpoint 53, 29.98 inHg. rho 1.171 kg/m^3 at the assumed 72 F indoors [UNVERIFIED].
- t2_conditions.csv: 3 new rows. Numbers are pulled from the holds and battery files by a script, not typed.

### Pipeline, in order (from the repo root)
  V=analysis/tests/video/2026-09-29; C=analysis/tests/data/2026-09-29_throttle_callouts.csv
  python analysis/tests/read_mt10pro_video.py "$V/12X8E Trial #1.MOV" --run-id 2026-09-29_12x8E_T1 --prop 12x8E \
      --pack-id A --pack-fresh yes --step 2 --workers 4 --thrust-refine 24
  python analysis/tests/audio_rpm.py "$V/12X8E Trial #1.MOV" --run-id 2026-09-29_12x8E_T1 --prop 12x8E --rho 1.171
  python analysis/tests/throttle_merge.py $C
  python analysis/tests/battery_check.py $C
- Run times, one read at a time (4 workers use the whole CPU): v1.4 full reads 12x8E 134.2 min, 9x6E 80.2 min.
  v1.5 re-samples of those caches: 25.3 and 17.5 min. 9x4.5E v1.5 full read: 153.6 min. The rest takes minutes.
- Outputs: data/2026-09-29_<run>_{frames, thrust_states, blue_states, t2, rpm, rpm_states, throttle, holds}.csv;
  session 2026-09-29_battery_{runs, holds}.csv and 2026-09-29_rpm_drops.csv. Plots and logs: out/throttle/2026-09-29_*,
  out/battery/2026-09-29_*, out/audio/2026-09-29_*_T1/. Reader debug (gitignored): out/video/2026-09-29_*_T1/.

### Tool change: read_mt10pro_video.py v1.4 -> v1.5 (installed, NOT committed; md5 33cd4afc2f0b04b92529a5aade49f960)
- Symptom (12x8E, v1.4): a hundreds 6 read as 5 (1614 -> 1514) and a thousands 2 read as 3 (2200 -> 3200).
  Hold 13 (stick 49) read 1546 g while the display showed 1600-1618 g.
- Cause [VERIFIED on frames]: per-frame registration drift of 9-12 px on blurred high-power frames, so the left
  segments were sampled on their edges. The setup was relaxed (3 training frames); the geometry fit was skipped.
  A better fixed geometry was tested and refuted: the v1.4 fit run offline on 8 high-power frames decoded 2 / 18
  truth frames, against 10 / 18 for the v1.4 sampler.
- Fix: --thrust-refine PX. A per-frame translation search of the thrust sampler: 4 px grid over +-PX in x and
  +-2/3 PX in y, then 1 px steps within +-2 px of the best. The lowest decode sigma wins; ties keep the unmoved
  sampler. PX 24 is far below the 111 px between a digit's left and right segments. The default 0 = v1.4.
  The shift is stored per frame (frames.csv thrust_dx_px / thrust_dy_px). PX is in the thrust key, so cached
  chunks are re-sampled, not re-read. Details and evidence are in the docstring.
- Validation (scratch validate15.py; v1.4 outputs kept in scratch pre_v15/, session temp, may not survive):
    run      truth frames   sigma med      isolated outliers   states   max state g   frames moved >= 6 px
    12x8E    10/18 -> 18/18  0.074 -> 0.062  15 -> 2            408->449 2998 -> 2284  48 pct
    9x6E     -              0.070 -> 0.056  2 -> 0              264->291 1650 (1 frame) 72 pct
    9x4.5E   - (v1.5 only)  0.060           4                   -        -             44 pct
  An isolated outlier is a frame more than 100 g from the median of its +-0.5 s neighbours.
  - 12x8E: 441 frames changed T_g, 37 of them by >= 500 g. Hold max |error| 69.0 -> 12.1 g. The fake event in
    hold 13 is gone (1546 -> 1603 g). The 2 left outliers are flagged frames (127.94 s LCD transition 1984 -> 2024
    read 1084 / 2084; 153.59 s spin-down).
  - 9x6E: max state 1650 g is one possible_mix frame in the spin-down at 99.8 s; a 1383 g weak state at 90.8 s
    is in a ramp. Both are outside the holds.
  - 9x4.5E: geometry (13, 22, 0.955), a row -3 px. 4 frames read 114 at 141.5 s, in the slow throttle-down after
    the last hold (409 / 309 / 399 / 114 / 304, mostly weak). Outside the holds; true values UNVERIFIED.
  - 9x6E and 9x4.5E: the coarse geometry best sits on the search boundary [minor; the holds match the callouts].

### Audio rpm: audio_rpm.py defaults (blades 2, kmax 10), not the 2026-09-25 --blades 1 --kmax 4
Both settings were run on scratch copies (aud_cmp.py). Criterion as for the 12x8E choice: states not flagged
motor_off / no_rpm / mismatch, T_over_Tapc spread for T > 300 g, median rpm_std.
    run      clean states (b2k10 vs b1k4)  rpm_std median  unsteady flags  mismatch flags
    12x8E    329 vs 316                    5.9 vs 44.5     -               -
    9x6E     225 vs 223                    6.4 vs 42.4     28 vs 128       1 vs 4
    9x4.5E   312 vs 313                    5.4 vs 36.5     45 vs 165       1 vs 10
Measured / APC thrust at the audio rpm (rho 1.171, T_apc >= 200 g), median: 12x8E 0.996, 9x6E 0.984, 9x4.5E 0.964.
- 12x8E hold 1 (stick -78, 44 g): rpm 2980 is above hold 2 (148 g, 2361 rpm), so it is not credible [INFERRED].
  Low power only.

### Holds (throttle_merge v1.3): all 49 callouts anchored; hold mean minus callout
- 9x6E: 13 / 13, max |err| 9.9 g (hold 13), median 0.5 g.
- 12x8E: 18 / 18, max 12.1 g (hold 13: 1603 vs 1615, a real sag to 1600), median 1.6 g. Callout 17 now matches
  2100 g exactly at 140.45 s.
- 9x4.5E: 18 / 18, max 9.0 g (hold 15: 939 vs 948), median 0.8 g.
Stick-100 holds (full-throttle windows, also in t2_conditions.csv):
    run      window s         T g    rpm     I A     V V     duty A  duty B  rpm / 776 line  rpm / 809 line
    9x6E     90.98-99.36      1320   10458   18.70   14.99   0.970   1.039   0.991           0.943
    12x8E    143.02-152.43    2198   8364    36.11   13.70   0.983   0.977   0.980           0.922
    9x4.5E   124.71-137.35    1166   10859   15.75   15.26   0.969   1.049   0.994           0.947
776 line = 776 x (V - 0.075 I), the 2026-09-25 ceiling (N2). 809 line = 809 x (V - 0.069 I), the "calibrated"
case of [2026-09-26 19:59] (fit A, dmax 0.96).

### Battery / ESC (battery_check v1.4)
- Rest V at start 16.73 / 16.74 / 16.74 V (4.18 V/cell). 9x6E ended at 15.84 V, and 12x8E started at 16.74 V, so the
  pack was recharged between those runs [INFERRED from V; the sheets only say "Fully Charged"].
- Pack line V0 / R: 16.76 V / 93 mOhm (9x6E), 16.74 / 85 (12x8E), 16.75 / 92 (9x4.5E). R includes the leads and
  wiring. It is higher than on 2026-09-25 (64-85 mOhm, packs not full). Pack IR itself is still not logged.
- V min loaded: 14.95 V at 18.6 A; 13.63 V at 35.7 A; 15.20 V at 16.1 A. Margin to the 12.0 V LVC reference
  +2.95 / +1.63 / +3.20 V [LVC reference UNVERIFIED for the X60A]. No ESC alarm. All 8 real rpm drops are throttle
  cuts (display thrust fell with them), not LVC.

### Answer to the 2026-09-26 test ("rpm rises above the 776 line past stick 80")
1. Duty keeps rising past stick 80: YES. duty A climbs 0.05-0.06 per 10 stick units, all the way to stick 100
   (12x8E 0.757 / 0.819 / 0.879 / 0.931 / 0.983 at stick 59 / 70 / 81 / 90 / 100). On 2026-09-25 it went flat
   at stick 80-82. At stick 90, rpm / 776 line is 0.92-0.95.
2. rpm above the 776 line: NO. At stick 100 rpm is 0.980-0.994 of it.
   - Fit of rpm = K (V - R' I) to the 3 stick-100 holds (scratch top_fit.py): K 776.5 rpm/V, R' 81.2 mOhm,
     residuals under 0.05 pct [VERIFIED numerically; 3 points, 1 dof]. The same K as the 2026-09-25 ceiling
     (776.2).
   - With R' fixed at 75 mOhm, K_eff is 761-771, i.e. stick 100 sits 0.6-2.0 pct below the old line. The data
     cannot tell "at the ceiling, R' 81" from "just below it, R' 75". Either way, it is not above.
   - Meaning [INFERRED, medium-high]: the stick-to-output mapping changed, so stick 100 now reaches what stick 80
     reached on 2026-09-25. The maximum output did not rise. This fits an ESC throttle-range calibration (NEXT
     TASK item 2 of [2026-09-26 19:59]), but Jordan has not confirmed one was done. Radio endpoint changes would
     look the same.
3. Consequences [INFERRED; predict_config.py NOT rerun]:
   - The "calibrated" case (Kv x dmax 809) is not reached: stick-100 rpm is 5.3-7.8 pct below the 809 line. Of the
     N4 prediction cases, the "as set" ones match the measured top end. 2 x 12x8E: 9.80 / 7.71 lbf (ideal pack),
     7.91 / 5.97 (real). 4 x 9x6E: 9.75 / 7.43, 7.83 / 5.68 (borrowed factors). The "calibrated" 10.22 / 10.23 lbf
     is optimistic.
   - BIG FLAG: the best predicted static thrust is about 9.8 lbf, not 10.2, against 12.5 lbf in the sizing.
   - Kv and dmax are still not separated. If the calibrated ESC's top is 100 pct duty [UNVERIFIED], Kv x dmax 776
     means Kv about 776, not fit A's 809.

### Single-motor stick-100 results (measured; NOT a layout comparison)
- 9x6E 1320 g at 18.7 A / 14.99 V. 12x8E 2198 g at 36.1 A / 13.70 V. 9x4.5E 1166 g at 15.75 A / 15.26 V.
- These are one motor on one pack. In the aircraft either layout pulls about 76-82 A from one pack
  ([2026-09-26 19:59]), so the per-motor bench numbers sit at different pack voltages. Multiplying them by the
  motor count (9x6E x 4 = 11.6 lbf, 12x8E x 2 = 9.7 lbf) is NOT a valid comparison.
- The D4 / N4 overturn condition ("9x6E stand run") now has its data. The comparison needs predict_config.py rerun
  with the measured 9x6E factors and the 2026-09-29 top end and pack line. Not done here.

### UNVERIFIED / INFERRED
- Indoor 72 F assumed (not measured on 2026-09-29), so rho 1.171 is assumed. Indoor dewpoint = outdoor KMKL.
- ESC and motor assumed to be the same as for 12x8E on 2026-09-23 (X60A, X2820 800 KV).
- The pack recharge between 9x6E and 12x8E (from rest V). Pack A on all three runs (from the sheets).
- The ESC calibration (inferred from the duty curve; Jordan to confirm what changed since 2026-09-25).
- The LVC reference 12.0 V (from the X45/65/85 manual).
- Thrust in ramps outside the holds: some weak or flagged states are misreads (see validation).
- v1.5 was validated on the 2026-09-29 runs only, not rerun on the 2026-09-25 runs.
- 12x8E hold 1 audio rpm (not credible).

### Adjacent issues (listed, not fixed)
- v1.5 --thrust-refine defaults to 0. Consider making 24 the default after rerunning the 2026-09-25 runs with it.
- The reader's debug overlays call read_one without the rotation argument (overlays only; data unaffected
  [INFERRED]).
- The reader log's "mean s per frame" label is imprecise.
- The relaxed setup (3 training frames on 12x8E) skipped the geometry fit; the refine search covered it here.
- pre_v15/ (v1.4 outputs), validate15.py, aud_cmp.py, top_fit.py and make_callouts.py live in session scratch
  only. Copy them if they should be kept.
- Stale grep processes from 2026-09-26 may still be running.
- analysis/tests/__pycache__/*.pyc still shows in git status (one tracked). Throttle Data 9.29.xlsx is at the
  repo root.
- The Gmail and Google Calendar MCP connectors need authorization in claude.ai connector settings (not used).

### NEXT TASK
Rerun analysis/tests/predict_config.py (2 x 12x8E vs 4 x 9x6E) with the measured 2026-09-29 data: 9x6E factors
from its own run, the top end K 776.5 / R' 81 mOhm (drop the "calibrated" 809 case unless Jordan says the ESC was
not calibrated), and pack line 16.75 V / 85-93 mOhm. Then put the top end into propulsion.py / takeoff.py and rerun
the sizing with the E423. Ask Jordan first: was the ESC calibrated before 2026-09-29? Pack C rating and IR?
How many X2820s?

---

## [2026-09-30 09:21 CDT] 2026-09-29 T-2 data packaged as a zip for an outside Claude Code session

Task (Jordan): a comprehensive zip of the 2026-09-29 test data to hand to someone else's Claude Code.

- Output: C:\Users\jprun\Downloads\SAE_T2_2026-09-29.zip (63.5 MB, 1003 files, outside the repo).
  Zip integrity checked (testzip: all CRCs OK). Repo files unchanged.
- Layout mirrors the repo, so the scripts run from the zip root. Contents:
  - Throttle Data 9.29.xlsx.
  - All 29 analysis/tests/data/2026-09-29_* CSVs, plus t2_conditions.csv (all rows; 3 are 09-29).
  - out/{throttle, battery, audio} 09-29 plots and logs.
  - out/video/2026-09-29_*_T1: log, setup.json, thrust_sampler.jpg and 929 overlay JPGs (from the v1.5 reads).
  - Scripts as installed: read_mt10pro_video.py v1.5 (md5 33cd4afc...), audio_rpm.py 1.3,
    throttle_merge.py 1.3, battery_check.py 1.4.
  - analysis/sizing/{propulsion, common}.py; reference/raw/apc_{12x8e, 9x6e, 9x45e}.dat;
    kmkl_asos_2026-09-30.csv; X2820 test data and spec text.
  - context/: verbatim log entries [2026-09-30 06:59], [2026-09-26 12:00] and [2026-09-26 19:59], plus
    TEST_PLAN.md section 3.
  - README.md for a cold-start reader (setup, pipeline, file map, key results, caveats) and MANIFEST.csv
    (size and md5 per file).
- Left out: the 3 videos (4.5 GB), the reader .npz caches, data from 09-23 and 09-25, predict_config.py and
  the sizing code.
- Self-containment check [VERIFIED] on a copy of the package:
  - throttle_merge.py reproduced every holds, throttle and t2 CSV byte for byte.
  - battery_check.py --no-alarms reproduced every number. Without the videos three things are lost: the run
    order (from the video timestamps), the created column, and the alarm columns.
- The README's stick-100 table, hold errors and pack line were checked against the CSVs.
- Build script: scratch build_pkg.py (session temp only).
- The package contains the test site's phone-GPS coordinates (t2_conditions.csv, logs). Flagged to Jordan in
  the handoff message.

### NEXT TASK
Unchanged from [2026-09-30 06:59]: rerun predict_config.py with the 2026-09-29 data.

---

## [2026-09-30 09:24 CDT] Jordan's answers: ESC calibrated, lottery registered, 4 motors, prop counts

Jordan (2026-09-30), verbatim: "i did calibrate the esc and controller. we have already registered for the
lottery, so that is a closed matter. i have 4 motors and 2 of each of the 12" props and 4 of the 9" props."

### Recorded (Jordan)
- ESC throttle range calibrated to the transmitter before the 2026-09-29 session. This answers open item 1
  of [2026-09-30 06:59].
  - When this happened relative to the 2026-09-25 session was not stated. On 09-25 the output went flat near
    stick 80, which fits a range that was not yet calibrated [INFERRED].
- Competition lottery: registered. Jordan calls it closed.
  - The result (which event) is not logged. R8 (East/Florida) is unchanged.
  - The AMA card and sae.org affiliation (R7) were not mentioned. Their status is still not logged.
- Motors on hand: 4 x SunnySky X2820 800 KV.
- Props on hand: 12x6E, 12x8E and 12x10E, 2 of each.
  - 9 in props: "4 of the 9 in props". Read here as 4 each of 9x4.5E and 9x6E [INTERPRETED; Jordan to
    confirm, it could mean 4 in total].

### What changes [INFERRED unless marked]
- Top end. With a calibrated range, stick 100 is the ESC's full output.
  - So the measured rpm = 776.5 x (V - 0.081 I) ([2026-09-30 06:59]) is the calibrated maximum.
  - It has the same K (776) as the 09-25 ceiling. The calibration moved where the ceiling is reached, from
    about stick 80 to stick 100. It did not raise the maximum.
  - Confidence high: Jordan's confirmation plus 3 stick-100 holds.
- The "calibrated" prediction case of [2026-09-26 19:59] (Kv x dmax 809, fit A) is ruled out.
  - That case assumed the calibration would raise the top end. It did not.
  - The "as set" numbers are therefore the calibrated numbers: 2 x 12x8E 9.80 lbf static / 7.71 at V_R
    (ideal pack); 4 x 9x6E 9.75 / 7.43 (borrowed factors). predict_config.py is not rerun yet.
- BIG FLAG is firmer: about 9.8 lbf best static, against 12.5 lbf in the sizing.
- Kv and dmax are still not separated.
  - Whether the X60A's calibrated top is 100 pct duty is UNVERIFIED.
  - A Kv measurement that does not go through the ESC (for example a back-EMF spin test) would separate them.
  - If dmax = 1, Kv is about 776.
- Motor count. The hardware no longer limits the layout choice: both 2 x 12 in and 4 x 9 in can be built
  from the motors and props on hand. D4 (2 x 12x8E) stands until predict_config.py is rerun with the
  measured 9x6E factors.
- Not stated: how many ESCs are on hand. The 4-motor layout needs 4; the bench used one X60A V2.
- Spares (listed, not a decision):
  - 2 of each 12 in prop leaves a 2-motor aircraft with no spare of its prop.
  - 4 of each 9 in prop, if that reading is right, leaves a 4-motor aircraft with none either.
- TEST_PLAN 3.2 asks for at least 2 motors on the stand, to see motor-to-motor scatter. All bench data so
  far is from one motor (assumed to be the same unit).

### Files updated
- DECISIONS.md: D5, H4, N10 and N11 SUPERSEDED. New rows D11, H6, H7, N16, N17 and P4.
- STATE.md rewritten.
- TEST_PLAN.md 3.2: the motor count line.
- analysis/tests/data/t2_conditions.csv: in the three 2026-09-29 rows, the note "[ESC throttle-range
  calibration INFERRED from this, not confirmed by Jordan]" now says it is confirmed. Text replace only.
- C:\Users\jprun\Downloads\SAE_T2_2026-09-29.zip rebuilt with the updated README and t2_conditions.csv.
  The previous zip was archived to the vault.

### Still open for Jordan
- How many ESCs are on hand.
- Pack capacity, C rating and IR.
- AMA card and sae.org affiliation.
- T-1 wing panel weigh-in.
- Does "4 of the 9 in props" mean 4 of each?
- Commit reader v1.5 and the 2026-09-29 data.

### NEXT TASK
Rerun analysis/tests/predict_config.py with the 2026-09-29 data:
- drop the "calibrated" 809 case (ruled out);
- use the 9x6E factors from its own run;
- top end K 776.5 / R' 81 mOhm;
- pack line 16.75 V / 85-93 mOhm.
Then rerun the sizing with the E423.

---
