Xavier8264/SAE-Aero-Design/reference/INDEX.md

# Reference library index

Generated by `tools/doc2text.py`; do not edit by hand. Add notes with `python tools/doc2text.py note ID TEXT`.

How to use (token-efficient):
1. Read this index, not whole documents.
2. Grep `reference/text/` for keywords, then Read only the matching line ranges.
3. Page markers look like `=== PAGE 44 | p.36 | math ===` (PDF page | printed page | flags).
   Grep `=== PAGE 44 ` to jump to a page; cite the printed page.
4. Flags: math = equation recovered but sub/superscripts flattened; garbled = broken font, render it;
   lowtext = little text (scan/figure/JS page); img = figures not in text; truncated-file = partial recovery.
5. Render a page image only when a flag or a figure requires it: `python tools/doc2text.py render ID PAGE`.

| ID | Type | Pages | ~Tokens | Flags | Source | Note |
|---|---|---|---|---|---|---|
| aerosandbox_readme | txt | 1 | 4146 |  | https://raw.githubusercontent.com/peterdsharpe/AeroSandbox/master/README.md | AeroSandbox README (install, aircraft/airfoil optimization API) |
| aerotoolbox_wing_spar | html | 1 | 5375 |  | https://aerotoolbox.com/wing-structural-design/ | Wing structural design tutorial: spar caps, shear web, shear flow |
| airfoil_ch10sm | txt | 1 | 557 |  | https://m-selig.ae.illinois.edu/ads/coord/ch10sm.dat | UIUC airfoil coordinates. CH 10-48-13 smoothed (Hollinger) high-lift RC section |
| airfoil_e423 | txt | 1 | 361 |  | https://m-selig.ae.illinois.edu/ads/coord/e423.dat | UIUC airfoil coordinates. Eppler E423: high-lift low-Re benchmark vs S1223 |
| airfoil_fx74cl5140 | txt | 1 | 416 |  | https://m-selig.ae.illinois.edu/ads/coord/fx74cl5140.dat | UIUC airfoil coordinates. Wortmann FX 74-CL5-140 high-lift |
| airfoil_naca0012 | txt | 1 | 737 |  | https://m-selig.ae.illinois.edu/ads/coord/n0012.dat | UIUC airfoil coordinates. NACA 0012 tail / CFD validation. NOTE: coords start at LE, not TE |
| airfoil_naca4412 | txt | 1 | 173 |  | https://m-selig.ae.illinois.edu/ads/coord/naca4412.dat | UIUC airfoil coordinates. NACA 4412 baseline |
| airfoil_s1210 | txt | 1 | 571 |  | https://m-selig.ae.illinois.edu/ads/coord/s1210.dat | UIUC airfoil coordinates. S1210 (12%): high-lift, thicker than S1223 -> deeper spar |
| airfoil_s1223 | txt | 1 | 468 |  | https://m-selig.ae.illinois.edu/ads/coord/s1223.dat | UIUC airfoil coordinates (Selig format). S1223: classic ultra-high-lift low-Re (Clmax ~2.1 at Re 200k). Top wing candidate; large nose-down Cm |
| airfoil_s1223rtl | txt | 1 | 852 |  | https://m-selig.ae.illinois.edu/ads/coord/s1223rtl.dat | UIUC airfoil coordinates. S1223 RTL: reflexed-TE mod, lower pitching moment than S1223 (eases tail sizing). Data in LSAT vol 2 |
| airfoil_sd7062 | txt | 1 | 308 |  | https://m-selig.ae.illinois.edu/ads/coord/sd7062.dat | UIUC airfoil coordinates. SD7062 (14%) moderate high-lift low-Re |
| airfoil_sd8020 | txt | 1 | 307 |  | https://m-selig.ae.illinois.edu/ads/coord/sd8020.dat | UIUC airfoil coordinates. SD8020 (10%): tail candidate |
| aluminum_6061 | html | 1 | 1222 |  | https://www.aircraftmaterials.com/data/aluminium/6061.html | 6061-T6 properties by temper/form (vendor data page) |
| aluminum_7075 | html | 1 | 1471 |  | https://www.aircraftmaterials.com/data/aluminium/7075.html | 7075-T6 properties by temper/form (vendor data page) |
| ama_national_safety_code | pdf | 1 | 693 |  | https://www.modelaircraft.org/system/files/documents/105.pdf | AMA National Model Aircraft Safety Code (doc 105). Required safety reference. |
| anc18_wood_aircraft | txt | 1 | 119469 |  | https://archive.org/download/designofwoodairc00fore/designofwoodairc00fore_djvu.txt | ANC-18 Design of Wood Aircraft Structures (1944, public domain), OCR text: spar caps, shear webs, glue joints, allowables |
| apc_11x10e | txt | 1 | 31167 |  | https://www.apcprop.com/files/PER3_11x10E.dat | APC prop performance data (vortex-theory simulation, v2022). ~30k+ tokens: PARSE WITH A SCRIPT, do not read. Rows = airspeed at each RPM block |
| apc_11x7e | txt | 1 | 32851 |  | https://www.apcprop.com/files/PER3_11x7E.dat | APC prop performance data (vortex-theory simulation, v2022). ~30k+ tokens: PARSE WITH A SCRIPT, do not read. Rows = airspeed at each RPM block |
| apc_12x10e | txt | 1 | 31167 |  | https://www.apcprop.com/files/PER3_12x10E.dat | APC prop performance data (vortex-theory simulation, v2022). ~30k+ tokens: PARSE WITH A SCRIPT, do not read. Rows = airspeed at each RPM block |
| apc_12x12e | txt | 1 | 31167 |  | https://www.apcprop.com/files/PER3_12x12E.dat | APC prop performance data (vortex-theory simulation, v2022). ~30k+ tokens: PARSE WITH A SCRIPT, do not read. Rows = airspeed at each RPM block |
| apc_12x6e | txt | 1 | 31167 |  | https://www.apcprop.com/files/PER3_12x6E.dat | APC prop performance data (vortex-theory simulation, v2022). ~30k+ tokens: PARSE WITH A SCRIPT, do not read. Rows = airspeed at each RPM block |
| apc_12x8e | txt | 1 | 31167 |  | https://www.apcprop.com/files/PER3_12x8E.dat | APC prop performance data (vortex-theory simulation, v2022). ~30k+ tokens: PARSE WITH A SCRIPT, do not read. Rows = airspeed at each RPM block |
| apc_6x4e | txt | 1 | 56420 |  | https://www.apcprop.com/files/PER3_6x4E.dat | APC prop performance data (vortex-theory simulation, v2022). ~30k+ tokens: PARSE WITH A SCRIPT, do not read. Rows = airspeed at each RPM block |
| apc_6x55e | txt | 1 | 54736 |  | https://www.apcprop.com/files/PER3_6x55E.dat | APC prop performance data (vortex-theory simulation, v2022). ~30k+ tokens: PARSE WITH A SCRIPT, do not read. Rows = airspeed at each RPM block |
| apc_9x45e | txt | 1 | 42952 |  | https://www.apcprop.com/files/PER3_9x45E.dat | APC prop performance data (vortex-theory simulation, v2022). ~30k+ tokens: PARSE WITH A SCRIPT, do not read. Rows = airspeed at each RPM block |
| apc_9x6e | txt | 1 | 42952 |  | https://www.apcprop.com/files/PER3_9x6E.dat | APC prop performance data (vortex-theory simulation, v2022). ~30k+ tokens: PARSE WITH A SCRIPT, do not read. Rows = airspeed at each RPM block |
| apc_9x75e | txt | 1 | 39585 |  | https://www.apcprop.com/files/PER3_9x75E.dat | APC prop performance data (vortex-theory simulation, v2022). ~30k+ tokens: PARSE WITH A SCRIPT, do not read. Rows = airspeed at each RPM block |
| apc_engineering | html | 1 | 2554 |  | https://www.apcprop.com/technical-information/engineering/ | APC theoretical basis: aero, structural (RPM limits), performance-data methodology |
| apc_performance_data_page | html | 1 | 2260 |  | https://www.apcprop.com/technical-information/performance-data/ | APC: how PER3 data is generated; links every prop file. Site needs browser UA + Referer to download |
| apc_rpm_limits | html | 1 | 292 |  | https://www.apcprop.com/technical-information/rpm-limits/ | APC max RPM vs diameter by prop series (Thin Electric: 150000/D_in). Check since no power limiter |
| ardupilot_airspeed_calibration | html | 1 | 2584 |  | https://ardupilot.org/plane/docs/calibrating-an-airspeed-sensor.html | Official ArduPilot airspeed sensor calibration. Flight test instrumentation. |
| avl_doc | txt | 1 | 20215 |  | https://web.mit.edu/drela/Public/web/avl/avl_doc.txt | AVL 3.40 user primer (Drela/Youngren): geometry syntax, trim, stability derivatives |
| balsa_strength_vs_density | pdf | 4 | 1968 | img 1-2,4; math 2-4 | http://stealthsquadron-fac49.com/wp-content/uploads/2023/02/Balsa-Strength-Article.pdf | Balsa strength vs density (HOBBYIST article; cross-check against Wood Handbook ch5 before relying on it) |
| basicairdata_servo_sizing | html | 1 | 1909 |  | https://basicairdata.eu/knowledge-center/design/elevator-hinge-moment/ | RC-specific hinge moment -> servo torque worked method. KEY for rules-required servo sizing |
| brandt_selig_2011 | pdf | 18 | 11889 | img 2,4-6 | https://m-selig.ae.illinois.edu/pubs/BrandtSelig-2011-AIAA-2011-1255-LRN-Propellers.pdf | Brandt & Selig AIAA 2011-1255: low-Re prop test method and results (UIUC prop DB paper) |
| calculix_manual | pdf | 832 | 448498 | garbled 1-11,336-338,363,697,736-737; img 19,23-25,28-29,31,33,38,43-44,52,54-55,57-58,61,76-80,82-86,88-89,107,122,125,223,238-239,293 | http://www.dhondt.de/ccx_2.22.pdf | Official CalculiX CrunchiX 2.22 user manual (Dhondt). FEA solver behind the FreeCAD FEM workbench. |
| cc_best_practices | txt | 1 | 9996 |  | https://code.claude.com/docs/en/best-practices.md | Claude Code official docs (fetched for token-workflow guide) |
| cc_commands | txt | 1 | 44146 |  | https://code.claude.com/docs/en/commands.md | Claude Code official docs (fetched for token-workflow guide) |
| cc_context_window | txt | 1 | 15554 |  | https://code.claude.com/docs/en/context-window.md | Claude Code official docs (fetched for token-workflow guide) |
| cc_costs | txt | 1 | 10545 |  | https://code.claude.com/docs/en/costs.md | Claude Code official docs (fetched for token-workflow guide) |
| cc_env_vars | txt | 1 | 124061 |  | https://code.claude.com/docs/en/env-vars.md | Claude Code official docs |
| cc_hooks | txt | 1 | 82412 |  | https://code.claude.com/docs/en/hooks.md | Claude Code official docs (fetched for token-workflow guide) |
| cc_memory | txt | 1 | 13094 |  | https://code.claude.com/docs/en/memory.md | Claude Code official docs (fetched for token-workflow guide) |
| cc_model_config | txt | 1 | 27799 |  | https://code.claude.com/docs/en/model-config.md | Claude Code official docs (fetched for token-workflow guide) |
| cc_prompt_caching | txt | 1 | 10325 |  | https://code.claude.com/docs/en/prompt-caching.md | Claude Code official docs (fetched for token-workflow guide) |
| cc_sessions | txt | 1 | 9691 |  | https://code.claude.com/docs/en/sessions.md | Claude Code official docs (fetched for token-workflow guide) |
| cc_settings_reference | txt | 1 | 110931 |  | https://code.claude.com/docs/en/settings-reference.md | Claude Code official docs |
| cc_statusline | txt | 1 | 19747 |  | https://code.claude.com/docs/en/statusline.md | Claude Code official docs (fetched for token-workflow guide) |
| cc_sub_agents | txt | 1 | 28879 |  | https://code.claude.com/docs/en/sub-agents.md | Claude Code official docs: custom subagents (frontmatter: model, effort, tools) |
| cc_troubleshooting | txt | 1 | 3752 |  | https://code.claude.com/docs/en/troubleshooting.md | Claude Code official docs (fetched for token-workflow guide) |
| cc_vs_code | txt | 1 | 18306 |  | https://code.claude.com/docs/en/vs-code.md | Claude Code official docs (fetched for token-workflow guide) |
| colorfabb_lwpla_tds | pdf | 3 | 1113 |  | https://colorfabb.com/media/datasheets/tds/colorfabb/TDS_E_ColorFabb_LW-PLA.pdf | ColorFabb LW-PLA (foaming, lightweight) data sheet |
| data_readme | txt | 1 | 308 |  | reference/data/README.txt | Index of raw datasets in reference/data (KLAL hourly weather 2021-2026). Read this, then parse the CSV with a script |
| dimensions_2l_bottle | html | 1 | 444 |  | https://www.dimensions.com/element/soda-bottle-2-liter |  |
| drela_design_rules | pdf | 8 | 4265 |  | https://web.mit.edu/16.unified/www/SPRING/systems/Lab_Notes/desrules.pdf | Drela MIT 16.Unified Basic Aircraft Design Rules: wing loading, CLmax choice, tail volumes, stability margin, structure rules of thumb. KEY first-pass sizing source; short, OK to read whole |
| drela_motorprop | pdf | 6 | 3156 |  | https://web.mit.edu/drela/Public/web/qprop/motorprop.pdf | Drela MIT 16.50 DC motor/prop matching; first-order motor model (Kv, Rm, I0). KEY for propulsion sizing |
| famu_fsu_2020_report | pdf | 30 | 12706 | garbled 3-5; img 1-2,7,9,12-15,18-21,23-25,30; lowtext 2,29 | https://eng-web1.eng.famu.fsu.edu/me/senior_design/2020/team513/docs_pdfs/Design_Report.pdf | FAMU-FSU 2020 Regular design report (East): density altitude payload prediction method, no composites. Different mission year |
| famu_fsu_2021_report | pdf | 30 | 13533 | garbled 3-5; img 1,7-8,11-14,17-24; lowtext 26-28 | https://web1.eng.famu.fsu.edu/me/senior_design/2021/team507/docs_pdfs/Design_Report.pdf | FAMU-FSU 2021 Regular design report: canard layout, payload prediction and margin section. Different mission year |
| faq_157 | html | 1 | 156 |  | https://saeaerodesign.com/cdsweb/rqa/ViewFAQ.aspx?faqnum=157 |  |
| faq_170 | html | 1 | 404 |  | https://saeaerodesign.com/cdsweb/rqa/ViewFAQ.aspx?faqnum=170 |  |
| faq_382 | html | 1 | 165 |  | https://saeaerodesign.com/cdsweb/rqa/ViewFAQ.aspx?faqnum=382 |  |
| faq_393 | html | 1 | 320 |  | https://saeaerodesign.com/cdsweb/rqa/ViewFAQ.aspx?faqnum=393 |  |
| faq_394 | html | 1 | 238 |  | https://saeaerodesign.com/cdsweb/rqa/ViewFAQ.aspx?faqnum=394 |  |
| faq_395 | html | 1 | 419 |  | https://saeaerodesign.com/cdsweb/rqa/ViewFAQ.aspx?faqnum=395 |  |
| faq_list | html | 1 | 362 |  | https://saeaerodesign.com/cdsweb/rqa/BrowseFAQs.aspx | List of all official FAQs; re-fetch with --force to check for new ones |
| fdm_infill_orientation | pdf | 7 | 5352 | img 5-6; math 5-6 | https://iopscience.iop.org/article/10.1088/1757-899X/429/1/012101/pdf | Open-access paper: FDM PLA strength vs infill and build orientation |
| fluidx3d_readme | txt | 1 | 42932 |  | https://raw.githubusercontent.com/ProjectPhysX/FluidX3D/master/README.md | FluidX3D README (LBM CFD on consumer/integrated GPUs via OpenCL) |
| fpl_minimum_weight_sandwich | pdf | 17 | 4932 | img 1,4-6,8-17 | https://www.fpl.fs.usda.gov/documnts/fplrn/fplrn086_rev_a.pdf | USDA FPL RN-086 minimum weight structural sandwich design. Free substitute for the canceled MIL-HDBK-23. |
| freecad_fem_workbench | txt | 1 | 1419 |  | https://raw.githubusercontent.com/FreeCAD/FreeCAD-documentation/main/wiki/FEM_tutorial.md | Official FreeCAD FEM workbench tutorial (Gmsh mesh + CalculiX solve), from the FreeCAD-documentation GitHub mirror. wiki.freecad.org itself is behind Anubis bot protection and cannot be fetched by script: open it in a browser. |
| gmsh_reference_manual | pdf | 458 | 297628 | garbled 5,7-9,75,366-368,373-375,441-458; img 25,28,31,33,36,40,42-43,46-47,50,52-53,55,57-58,60-61,64-65,67,69,72,76,79,81,85,89-90; lowtext 1-2,6,10,12,14,16,88,100,318,336,364,388,426,432,440 | https://gmsh.info/doc/texinfo/gmsh.pdf | Official Gmsh mesh generator reference manual. Pairs with FreeCAD FEM and CalculiX. |
| klal_airnav | html | 1 | 5771 |  | https://www.airnav.com/airport/klal | KLAL Lakeland Linder: elevation 141.8 ft; runways 10/28 8500 ft, 5/23 5000 ft asphalt, 8/26 turf |
| klal_windrose | html | 1 | 1895 |  | https://mesonet.agron.iastate.edu/sites/windrose.phtml?station=LAL&network=FL_ASOS | IEM wind rose page for KLAL (select month on the live page) |
| mayatech_mt10pro | html | 1 | 2337 |  | https://www.flyingtech.co.uk/product/mayatech-mt10-pro-thrust-stand-and-power-analyser/ | Mayatech MT10PRO 10 kg thrust stand + power analyser, reseller spec page (no official Mayatech site found). Display-only: no RPM, no logging. |
| mayatech_mt10pro_safety | pdf | 1 | 341 |  | https://www.flyingtech.co.uk/wp-content/uploads/2021/02/Safety-Disclaimer-%E2%80%93-Thrust-Stand-and-Power-Analyser.pdf | Reseller (Flying Tech) safety sheet for the Mayatech MT10PRO thrust stand; linked from mayatech_mt10pro page. |
| mit_1682_flight_vehicle_intro | pdf | 15 | 8498 | img 5 | http://web.mit.edu/16.82/www/html/16.82_fall03/old%20html/Intro.pdf | MIT 16.82 capstone: phased flight vehicle design process (CDIO). Design process gap. |
| mit_airpower | pdf | 4 | 2541 |  | https://web.mit.edu/16.unified/www/SPRING/systems/Lab_Notes/airpower.pdf | MIT 16.Unified Lab 1: thrust/power/velocity relations, propeller efficiency |
| mit_prop_appendix | pdf | 7 | 3503 |  | https://web.mit.edu/16.unified/www/SPRING/systems/Lab_Notes/appendix.pdf | MIT 16.Unified Lab 10 appendix: measured thrust/RPM/power vs airspeed for small APC props |
| modelaviation_diy_laser_cutting | html | 1 | 3953 |  | https://www.modelaviation.com/diy-laser-cutting | AMA Model Aviation: DIY laser cutting of balsa and plywood parts. Magazine grade. |
| modelaviation_sliced_rib_method | html | 1 | 2897 |  | https://www.modelaviation.com/Sliced-Rib-Method-of-Building | AMA Model Aviation: sliced rib built-up wing construction. Magazine grade, cite as practice not allowables. |
| nasa_grc_propeller_thrust | html | 1 | 1277 |  | https://www1.grc.nasa.gov/beginners-guide-to-aeronautics/propeller-thrust/ | NASA Glenn: propeller thrust from momentum theory (thrust falloff with speed) |
| nasa_ground_effect_propellers | pdf | 11 | 4864 | img 1-11 | https://ntrs.nasa.gov/api/citations/19930094580/downloads/19930094580.pdf | NASA NTRS: ground effect on propellers/lifting rotors (limited relevance to fixed-wing takeoff) |
| nasa_liion_guidelines | pdf | 54 | 39879 | img 1,3,47-48 | https://ntrs.nasa.gov/api/citations/20090023862/downloads/20090023862.pdf | NASA Li-ion guidelines: internal resistance ranges, C-rate behavior. Background only (Li-ion, not LiPo) |
| nasa_se_handbook | pdf | 297 | 261603 | garbled 7; img 1,3,5-9,11,13,15,27,53,87,123,152,183,186,207,211,213,215-216,224,226,233,245-246,249-254,261,264,270,280; lowtext 251,253 | https://www.nasa.gov/wp-content/uploads/2018/09/nasa_systems_engineering_handbook_0.pdf | NASA SP-2016-6105 Rev2 Systems Engineering Handbook. Requirements and decision traceability. 297 pp, grep only. |
| nasa_takeoff_flighttest_method | pdf | 42 | 17963 | garbled 37; img 1-42; lowtext 27 | https://ntrs.nasa.gov/api/citations/19740008604/downloads/19740008604.pdf | NASA simplified flight test method for measuring takeoff performance. |
| nasa_tm78664_hinge_moment | pdf | 27 | 12723 | garbled 19,22; img 1-27 | https://ntrs.nasa.gov/api/citations/19780023100/downloads/19780023100.pdf | NASA TM-78664 hinge-moment calculation method (full-scale case; use method, not numbers). For servo sizing |
| nasa_uav_battery_model | pdf | 8 | 7559 | img 2-3 | https://c3.ndc.nasa.gov/dashlink/static/media/publication/2011_AIAA_UAVBHM.pdf | NASA AIAA 2011: Li-Po discharge model on an electric UAV (voltage sag under load) |
| nasa_vgh_load_factor_stats | pdf | 133 | 108754 | garbled 2,60-61,63-67,71,73,75,82,87-88,92,97,110,123,125,127; img 1-133; lowtext 21,54,59,68,70,74,84,99,103,109,117 | https://ntrs.nasa.gov/api/citations/19750002861/downloads/19750002861.pdf | NASA statistical VGH gust and maneuver load factor data. Basis for V-n diagram load factor. |
| nau_2018_report | pdf | 39 | 14542 | img 1,5,12-17,20,22-25,28,36-39; lowtext 35,38-39; math 14-15,17-18 | https://ceias.nau.edu/capstone/projects/ME/2018/18F5_SAEAeroReg/Site%20docs/FINAL%20REPORT.pdf | NAU Skyjacks 2018 Regular report: 72 in span, 18.6 lb empty, 28.3 lb loaded, payload prediction appendix. Different mission year |
| nau_2019_report | pdf | 56 | 26586 | img 1,8-11,13-14,21-29,31-35,38,40,44,51-56; lowtext 40,51,53-55 | https://ceias.nau.edu/capstone/ | NAU 2019 Regular report (Ponderosa). Exact URL not recorded by the research agent; from the NAU capstone site. Different mission year |
| nau_2021_report | pdf | 71 | 32480 | img 1,14,16-20,22,27-28,30-36,38-41,43-44,48-53,57-58,60-61,66-67; lowtext 33-35; math 38-42 | https://ceias.nau.edu/capstone/ | NAU 2021 Regular report. Exact URL not recorded; NAU capstone site. Different mission year |
| nau_2025_report | pdf | 27 | 8507 | img 1-2,5-8,15-22,26-27; lowtext 2,27; math 9-10,13,16 | https://ceias.nau.edu/capstone/ | NAU 2025 Regular report (Aerojacks). Exact URL not recorded; NAU capstone site. Mission year before the bottle mission |
| nau_2026_poster | pdf | 1 | 784 | garbled 1; img 1 | https://www.ceias.nau.edu/capstone/projects/ME/2026/F25toSp26_Aero26/RegularClass.html | NAU 2026 Regular poster. Fonts broken: use render. Key data already in PROJECT_MEMORY.md |
| nau_2026_report1 | pdf | 51 | 30314 | img 1,8,22-23,26-35,38-43,45,51; math 7,22-26,28,44 | https://www.ceias.nau.edu/capstone/projects/ME/2026/F25toSp26_Aero26/images/Report%201.pdf | NAU 2026 initial design report; EARLIER DRAFT of nau_2026_report2, prefer report2 |
| nau_2026_report2 | pdf | 73 | 41602 | img 1,8,24-25,28-37,40-45,47-54,56,63,72-73; math 7,24-28,30,46,59,62 | https://sce.nau.edu/capstone/projects/ME/2026/F25toSp26_Aero26/images/Report%202.pdf | NAU Mach Pine 2026 Regular: conceptual design report (later draft of report1) |
| neuralfoil_readme | txt | 1 | 7949 |  | https://raw.githubusercontent.com/peterdsharpe/NeuralFoil/master/README.md | NeuralFoil README (fast Cl/Cd/Cm vs Re/alpha; accuracy limits vs XFOIL) |
| nicolai_rc_model_aero | pdf | 13 | 6098 | img 6 | https://saeaerodesign.com/cdsweb/gen/DownloadDocument.aspx?DocumentID=cd49237c-65b1-4744-9638-68903b7faf1d | Nicolai (Lockheed Martin) Estimating R/C Model Aerodynamics and Performance, written FOR SAE Aero Design; hosted by SAE. KEY: drag polar, Re effects, performance. 13 pp |
| noaa_lakeland_normals | txt | 1 | 2801 |  | https://www.ncei.noaa.gov/access/services/data/v1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 | NOAA 1991-2020 monthly normals, Lakeland 2 FL (2 mi from KLAL). March: Tmax 80.2 F, Tmin 56.5 F. No dewpoint/pressure (use reference/data ASOS file) |
| nws_density_altitude_calc | html | 1 | 1136 |  | https://www.weather.gov/epz/wxcalc_densityaltitude | NWS density altitude calculator page (JS calculator; equations are in nws_density_altitude_formula) |
| nws_density_altitude_formula | pdf | 2 | 421 | math 1-2 | https://www.weather.gov/media/epz/wxcalc/densityAltitude.pdf | NWS density altitude equations (vapor pressure, virtual temperature, DA). KEY for the TDS prediction curve |
| nyu_2018_report | pdf | 29 | 16377 | img 1,5-7,9-10,12-13,15-17,19-20,23-24; lowtext 29; math 6,13,15-20,27-28 | https://raw.githubusercontent.com/m-roz/SAE-Aero/master/SAE%20Aero%20Technical%20Design%20Report.pdf | NYU WingingIt 2018 Regular report: payload prediction curve, takeoff analysis. 141 in span (old rules) |
| openfoam_airfoil2d_allrun | txt | 1 | 59 |  | https://raw.githubusercontent.com/OpenFOAM/OpenFOAM-dev/master/tutorials/incompressibleFluid/airFoil2D/Allrun | OpenFOAM-dev airFoil2D tutorial run script; full case at tutorials/incompressibleFluid/airFoil2D (foamRun) |
| openfoam_user_guide | pdf | 292 | 176246 | garbled 9-15,272-273,277-279,290; img 25,31-32,34-37,39-42,47,51,54-55,58,63,200-201,203,207,224-227,242,244; lowtext 8,16,18,152,196,222,248,268 | https://raw.githubusercontent.com/OpenFOAM/OpenFOAM-dev/master/doc/Guides/OpenFOAMUserGuide-A4.pdf | OpenFOAM Foundation user guide (dev) |
| openvsp_user_manual | pdf | 58 | 9255 | garbled 28,32,34,36; img 1,4,6-10,13,15-17,26-28,32,34,36,38-43,45-51,54,57 | https://openvsp.org/wiki/lib/exe/fetch.php?media=vsp_aircraft_analysis_user_manual.pdf | Official OpenVSP (NASA-derived) parametric geometry tool user manual. |
| paraview_docs | html | 1 | 542 |  | https://docs.paraview.org/en/latest/ | Landing/index page only (~540 tokens), not the guide itself. The full ParaView PDF is 106 MB (too big to archive); browse docs.paraview.org for detail. |
| prusament_petg_tds | pdf | 3 | 1213 | img 1-3 | https://www.prusa3d.com/file/2765253/prusament-petg-technical-data-sheet.pdf | Prusament PETG technical data sheet |
| prusament_pla_tds | pdf | 3 | 1186 | img 1,3 | https://prusament.com/wp-content/uploads/2022/10/PLA_Prusament_TDS_2021_10_EN.pdf | Prusament PLA technical data sheet |
| qmil_doc | txt | 1 | 1133 |  | https://web.mit.edu/drela/Public/web/qprop/qmil_doc.txt | QMIL user guide (prop design) |
| qprop_doc | txt | 1 | 8305 |  | https://web.mit.edu/drela/Public/web/qprop/qprop_doc.txt | QPROP user guide (file formats, motor parameter fit) |
| qprop_theory | pdf | 14 | 9943 |  | https://web.mit.edu/drela/Public/web/qprop/qprop_theory.pdf | Drela QPROP/QMIL theory (blade element / vortex) |
| results_2026_east | pdf | 1 | 718 |  | https://www.saeaerodesign.com/content/2026-SAE-Aero-Design-East-Final-Results.pdf | Placings only, no scores |
| results_2026_west | pdf | 1 | 762 |  | https://www.saeaerodesign.com/content/2026-SAE-Aero-Design-West-Final-Results.pdf | Placings only, no scores |
| rules_2026 | pdf | 52 | 30779 | img 1,18,33,44,48; lowtext 1,52; math 36,40,46,49 | https://saeaerodesign.com/cdsweb/gen/DownloadDocument.aspx?DocumentID=10643d37-9fd1-4821-b413-9b7ddae8724b | 2026 rules (last year). Superseded by rules_2027; use only for comparison |
| rules_2027 | pdf | 57 | 32971 | img 1,21,36,48; lowtext 1,57; math 40,44,50,54 | 2027_SAE_AeroDesign_Rules_Set.pdf | OFFICIAL 2027 rules v2027.0. Regular=sec 7 (printed p.33-36), TDS=sec 4.5 (p.26), flight ops=sec 3 (p.17-20). Section NUMBERS are images and absent from text: search by heading words |
| scholz_tail_volume | pdf | 16 | 11730 | img 2,5,9-10,13-14; math 5-6,8,11-12,14 | https://www.fzt.haw-hamburg.de/pers/Scholz/Aero/AERO_PUB_INCAS_TailVolume_Vol13No3_2021.pdf | Scholz 2021: tail volume coefficient sizing method, typical Vh/Vv ranges |
| selig_guglielmo_1997 | pdf | 10 | 11647 | img 1-7 | https://m-selig.ae.illinois.edu/pubs/GuglielmoSelig-1997-JofAC-S1223.pdf | Selig and Guglielmo 1997 J. Aircraft: High-lift low-Re airfoil design (the S1223 paper) |
| selig_lowre_lecture | pdf | 43 | 30976 | img 23-25,29,32-35,37,40-42 | https://m-selig.ae.illinois.edu/pubs/Selig-2003-VKI-LRN-Airfoil-Design-Lecture-Series.pdf | Selig 2003 VKI lecture: low-Re airfoil design principles (Clmax, transition, bubbles). Use first half |
| sjsu_propulsion_sizing | pdf | 75 | 31961 | garbled 71-73; img 10,12-14,19-22,25,29,31-32,35-36,39-40,42,46-51,53-54,56-57; lowtext 2; math 15-16,23,25-28,33-38,40-49,51-52 | https://www.sjsu.edu/ae/docs/project-thesis/Brayan.Mendez-F21.pdf | SJSU thesis: electric propulsion sizing (Kv, ESC current, motor/prop/battery matching) worked example |
| su2_quick_start | html | 1 | 2741 |  | https://su2code.github.io/docs/Quick-Start/ | Official SU2 open source CFD quick start (NACA0012). Alternative solver to OpenFOAM. |
| sunnysky_esc_manual | pdf | 1 | 11837 | img 1 | http://en.rcsunnysky.com/Uploads/20240723112321_989336.pdf | SunnySky brushless ESC user manual (X45A/X65A/X85A LW/PRO; X60A not listed): throttle calibration, beeps, defaults (timing 15 deg, LVC 3.0 V/cell). Use with caution for the X60A |
| sunnysky_esc_x60 | html | 1 | 3136 |  | https://sunnyskyusa.com/products/sunnysky-60a-2-6s-brushless-esc-with-5v-6v-7-4v-5a-bec-3-5mm-rc-plug | SunnySky X series ESC X60A 2-6S, 5.6/7.4 V 8 A SBEC V2 (the team's ESC): 60 A cont, 80 A 10 s, 61 g, XT60, 3.5 mm bullets |
| sunnysky_x2820_800kv | html | 1 | 47554 |  | https://sunnyskyusa.com/products/sunnysky-x2820-brushless-motors | OFFICIAL SunnySky USA page, original black X Series X2820 (KV 800/920/1100). Spec block + manufacturer test table (prop, V, A, gf, W, g/W; no RPM). Team motor = KV800. Not the V3 line. |
| sunnysky_x2820_800kv_spec | txt | 1 | 1266 |  | https://sunnyskyusa.com/products/sunnysky-x2820-brushless-motors | CLEAN EXTRACT of the official X2820 800KV spec + 4S test table (read this, not sunnysky_x2820_800kv). Watts column = nominal 14.8 V x A. No RPM published. |
| syracuse_wing_spar_design | pdf | 34 | 13219 | img 3-5,11-14,16-22,25-26,29,33-34; lowtext 15,31 | https://ecs.syr.edu/faculty/glauser/varty/Structures2.pdf | Syracuse senior design: worked main wing spar sizing (bending moment, I, stress). |
| uf_wing_spar_optimization | pdf | 6 | 6444 | img 1-2,4-5; math 3 | https://ufdcimages.uflib.ufl.edu/AA/00/04/68/60/00001/Wing%20Spar%20Optimization%20of%20Radio%20Controlled%20Size%20Aircraft-Schneider.pdf | Univ. of Florida: spar cross-section optimization for a 14 lb, 7 ft span RC aircraft. Same scale as ours. |
| uiuc_lsat_index | html | 1 | 2495 |  | https://m-selig.ae.illinois.edu/uiuc_lsat.html | UIUC LSAT landing page: all volumes + tabular page-locator PDFs |
| uiuc_lsat_vol1 | pdf | 315 | 269862 | garbled 69,86-89,92-95,98-101,103-106,108-110,112-121,123-125,127-133,136-137,140-142,144-147,149-153,155-158,160-162,164-165,168-170,172-176,178-180,182-188,190-192,194-198,200-209,211-228,230-238,240-242,244-246,248-250,252-262,264-266; img 1-315; lowtext 2,15,21,23,27,47,90,96,102,122,134,138,148,154,166,267,275,311 | https://m-selig.ae.illinois.edu/uiuc_lsat/Low-Speed-Airfoil-Data-V1.pdf | UIUC Summary of Low-Speed Airfoil Data vol 1 (wind tunnel, Re 30k-500k). S1223 pp.214-217, S1210 209-211, CH10 111-114, FX74 132-134, SD8020 267-268 (PRINTED page numbers; PDF offset differs) |
| uiuc_lsat_vol2 | pdf | 281 | 264458 | garbled 78-80,82-84,86-96,98-100,102-103,106-108,110-116,118-132,134-144,146-149,151-154,156,158-160,162-168,170-180,182-184,186-194,196-198,200-202,204-214,216-222,224-234,237-238; img 1-281; lowtext 2,7,9,15,17,23,25,27,35,104,133,150,195,199,235,239,261,273,279-281 | https://m-selig.ae.illinois.edu/uiuc_lsat/Low-Speed-Airfoil-Data-V2.pdf | UIUC LSAT vol 2. E423 pp.65-67, S1223 127-128, S1223RTL 129-131 (printed pages) |
| uiuc_lsat_vol3 | pdf | 454 | 295403 | garbled 6-7,14-21,24,75-83; img 1,4,44,365,368-369; lowtext 2,9,23,25,27,35,73,84,106,120,126,136,140,146,160,212,222,228,234,240,296,306,316,340,346,352,357,373,377,417,439 | https://m-selig.ae.illinois.edu/uiuc_lsat/Low-Speed-Airfoil-Data-V3.pdf | UIUC LSAT vol 3. SD7062 pp.255-257 (printed pages) |
| uiuc_propdb | html | 1 | 1586 |  | https://m-selig.ae.illinois.edu/props/propDB.html | UIUC Propeller Data Site index (wind-tunnel data, Vol 1-4); cross-check for APC simulated data |
| uw_2026_rule_summary | pdf | 1 | 829 | img 1 | https://aerouw.org/rule_summary.pdf | Unofficial team summary of 2026 rules; contains an error (says single motor) |
| vspaero_tutorial | pdf | 16 | 2475 | img 1-16 | https://openvsp.org/wiki/lib/exe/fetch.php?media=workshop20:vspaero_gui_tutorial_-_basics.pdf | OpenVSP 2020 workshop: VSPAERO GUI basics |
| vt_aoe_a10_prelim_design | pdf | 113 | 14779 | img 6-9,13,16-20,24-30,34-35,37-47,52-58,62-72,78-93,97-100,104-108,112; lowtext 78,80-82,84,86,108 | https://www.aoe.vt.edu/content/dam/aoe_vt_edu/people/faculty/praj/avd-fundamentals/A10%20-%20Preliminary%20Design%20-%20Config%20Refinement%20and%20Validation.pdf | Virginia Tech AOE (Raj): preliminary design, configuration refinement and validation. |
| vt_aoe_a5_initial_sizing | pdf | 47 | 10531 | img 5,9-18,22,24-25,29,33,37-38,40-41,46-47; lowtext 42,45; math 10,12,31-36 | https://www.aoe.vt.edu/content/dam/aoe_vt_edu/people/faculty/praj/avd-fundamentals/A5%20-%20Initial%20Sizing%20-%20Wing%20Loading%20and%20Thrust%20Loading%20Estimati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 | Virginia Tech AOE 4065/4066 (Raj): initial sizing, wing and thrust loading method. |
| vt_aoe_a7a_config_layout | pdf | 100 | 8172 | img 6-13,15-20,23-25,27-29,31-34,36-39,41-45,47-54,56-58,60-61,65-66,70-73,75-99; lowtext 30,35,42-43,47,51,59,63,67,69,75-77,79-99 | https://www.aoe.vt.edu/content/dam/aoe_vt_edu/people/faculty/praj/avd-fundamentals/A7A%20-%20Configuration%20Layout%20-%20Drawings%20and%20Loft.pdf | Virginia Tech AOE (Raj): configuration layout, drawings and lofting. |
| wiki_two_liter_bottle | html | 1 | 864 |  | https://en.wikipedia.org/wiki/Two-liter_bottle |  |
| wood_handbook_ch10 | pdf | 26 | 33773 | img 2-4,6,15-20; lowtext 24 | https://www.fpl.fs.usda.gov/documnts/fplgtr/fplgtr282/chapter_10_fpl_gtr282.pdf | Wood Handbook ch10 adhesives (bond performance: epoxy, PVA) |
| wood_handbook_ch11 | pdf | 32 | 38061 | img 2,4-5,9,11,14-16,19,23,25,27; lowtext 30 | https://www.fpl.fs.usda.gov/documnts/fplgtr/fplgtr282/chapter_11_fpl_gtr282.pdf | Wood Handbook ch11 wood-based composites (plywood manufacture/grading background) |
| wood_handbook_ch12 | pdf | 18 | 22236 | lowtext 16 | https://www.fpl.fs.usda.gov/documnts/fplgtr/fplgtr282/chapter_12_fpl_gtr282.pdf | Wood Handbook ch12 mechanical properties of plywood/panels (shear-web design) |
| wood_handbook_ch5 | pdf | 48 | 70914 | img 2,17,27,30-33,35-40 | https://www.fpl.fs.usda.gov/documnts/fplgtr/fplgtr282/chapter_05_fpl_gtr282.pdf | USDA Wood Handbook 2021 ch5 mechanical properties. Table 5-3a softwoods (Sitka spruce), 5-3b hardwoods (balsa, basswood). KEY for spar allowables |
| wood_handbook_ch8 | pdf | 30 | 40500 | img 2-4,6-7,9-10,13-17,19-21,23-26 | https://www.fpl.fs.usda.gov/documnts/fplgtr/fplgtr282/chapter_08_fpl_gtr282.pdf | Wood Handbook ch8 fastenings (bolts/screws in wood; wing attach, gear blocks) |
| xflr5_part1_theory | pdf | 18 | 2748 | img 1-5,7,9-17; lowtext 2,6-7 | https://flow5.tech/xflr5/docs/Part%20I%3A%20Theoretical%20overview.pdf | XFLR5 official docs Part I theory (Deperrois 2019) |
| xflr5_part2_inviscid | pdf | 31 | 3829 | img 2,4-10,12,16-19,22-28; lowtext 1,4-5,9,13 | https://flow5.tech/xflr5/docs/ | XFLR5 official docs Part II inviscid/wing analysis (exact URL unrecorded; see flow5.tech/xflr5/docs) |
| xflr5_part3_viscous | pdf | 26 | 3998 | img 2-25; lowtext 20-21 | https://flow5.tech/xflr5/docs/Part%20III%3A%20The%20viscous%20flow_rev1.2.pdf | XFLR5 docs Part III viscous flow |
| xfoil_doc | txt | 1 | 19650 |  | https://web.mit.edu/drela/Public/web/xfoil/xfoil_doc.txt | XFOIL 6.9 user primer (Drela/Youngren) |
