Xavier8264/SAE-Aero-Design/analysis/sizing/out/sweep_summary.txt

Sweep: 780 designs at DA 2000 ft, zero wind, S1223, band 1.0 empty weight
 n slots  span chord  S    AR   W_TO  W_e  pay  mix   FS  mean3  FFS  margin  E_FFS
 2   3     95   28 18.47 3.39  35.9  17.5  18.4 0E3F   33  26.7  36.7  6.27  36.7
 2   4     95   28 18.47 3.39  36.0  17.9  18.1 0E4F   44  37.7  47.7  1.92  46.7
 2   5     95   28 18.47 3.39  36.0  18.2  17.8 1E4F   47  42.3  52.3  0.55  51.1
 2   6     95   28 18.47 3.39  36.0  18.5  17.5 1E4F   47  42.3  52.3  0.23  52.4
 2   7     95   28 18.47 3.39  35.7  18.7  17.0 4E3F   45  42.0  52.0  0.68  52.6
 2   8     95   28 18.47 3.39  35.7  18.8  16.9 4E3F   45  42.0  52.0  0.59  52.0
 4   3     95   28 18.47 3.39  36.2  17.9  18.3 0E3F   33  26.7  36.7  6.13  36.7
 4   4     95   28 18.47 3.39  36.2  18.3  18.0 0E4F   44  37.7  47.7  1.78  46.7
 4   5     95   28 18.47 3.39  36.3  18.6  17.7 1E4F   47  42.3  52.3  0.41  51.1
 4   6     95   28 18.47 3.39  36.3  18.9  17.3 1E4F   47  42.3  52.3  0.08  52.4
 4   7     95   28 18.47 3.39  36.0  19.1  16.9 4E3F   45  42.0  52.0  0.53  51.3
 4   8     95   28 18.47 3.39  36.0  19.2  16.8 4E3F   45  42.0  52.0  0.44  52.0
Top design: 2 motors 12x6e, 95 x 28 in, 7 slots -> 4E3F FS 45, FFS 52.0, E_FFS 52.6
  13 designs within 1 point of the best E_FFS: span 95-95 in, chord 26-32 in, slots 6-8
Best 2-motor E_FFS 52.6 (95x28, 7 slots); best 4-motor E_FFS 52.4 (95x28, 6 slots)
RECOMMENDED (smallest wing, then fewest slots, within 0.5 E_FFS of the optimum): 2x12x6e, 95 x 26 in (S 17.15 ft2, AR 3.65), 6 slots: W_TO 35.0, W_e 17.7, payload 17.38 lb -> 1E4F FS 47 (margin 0.13 lb), ladder 1E3F -> 0E4F -> 1E4F, E_FFS 52.4
  V_stall 33.1 ft/s, V_R 36.4 ft/s, climb gradient 0.129, charge 1.38 Ah of 1.76, landing roll 393 ft free / 114 ft braked, length ~93 in, bay 29.9 in long
Airfoil at design geometry: s1223 CLmax 1.66 pay 17.4; s1223rtl CLmax 1.63 pay 17.0; e423 CLmax 1.55 pay 16.2; fx74cl5140 CLmax 1.59 pay 16.4; ch10sm CLmax 1.53 pay 16.0; s1210 CLmax 1.42 pay 14.9; sd7062 CLmax 1.20 pay 12.3
Sensitivity (payload lb / mix / FFS): nominal: 17.4/1E4F/52 (takeoff); W_e x0.8 structure: 20.3/0E5F/59 (takeoff); W_e x1.2 structure: 14.5/2E3F/46 (takeoff); CLmax -10%: 15.6/3E3F/49 (takeoff); CLmax +10%: 19.1/2E4F/57 (takeoff); thrust x0.85: 15.9/3E3F/49 (takeoff); thrust x1.00: 18.6/2E4F/57 (takeoff); headwind 5 kt: 23.2/1E5F/63 (circuit); headwind 8 kt: 23.4/1E5F/63 (circuit); DA 1400 (median): 17.8/1E4F/52 (takeoff)
  band 0.8: best 95x28 in 7 slots, pay 20.1 -> 3E4F FFS 60.0 E_FFS 60.0
  band 1.2: best 95x24 in 6 slots, pay 14.4 -> 2E3F FFS 46.0 E_FFS 45.0
Payload vs DA (zero wind): 18.96 -0.790 lb per 1000 ft; FS at DA -1500/0/1500/2000/3000: 50/50/47/47/44
