Xavier8264/SAE-Aero-Design/analysis/sizing/out/weight_summary.txt

K_BUILD fitted to NAU 2026 (12.2 lb): 1.066
  NAU 2026 breakdown: wing 4.17, fuselage 2.30, tail 0.61, gear 1.17, misc 0.66, propulsion 1.68, battery 0.55, avionics 1.05 -> 12.20 lb
  Sanity NAU 2018 (120 in, 13.6 ft2, assumed W_TO 40 lb): model 15.3 lb vs 18.6 lb actual (older rules, different payload/fuselage; order-of-magnitude check only)
Empty weight (lb, band 0.8/1.0/1.2 on structure), 2 motors, S1223, W_TO 35 lb:
  80 x 19 in (10.56 ft2), 2 slots: 10.91 / 12.82 / 14.73   wing 4.32 fus 1.88 tail 0.75 gear 1.89
  90 x 18 in (11.25 ft2), 5 slots: 12.02 / 14.20 / 16.39   wing 4.63 fus 2.84 tail 0.75 gear 1.89
  95 x 20 in (13.19 ft2), 5 slots: 12.79 / 15.17 / 17.55   wing 5.42 fus 2.84 tail 0.86 gear 1.89
  95 x 22 in (14.51 ft2), 5 slots: 13.33 / 15.84 / 18.36   wing 5.98 fus 2.84 tail 0.92 gear 1.89
  95 x 24 in (15.83 ft2), 6 slots: 14.17 / 16.89 / 19.61   wing 6.56 fus 3.16 tail 0.98 gear 1.89
