Xavier8264/SAE-Aero-Design/analysis/sizing/out/airfoil_polars.png

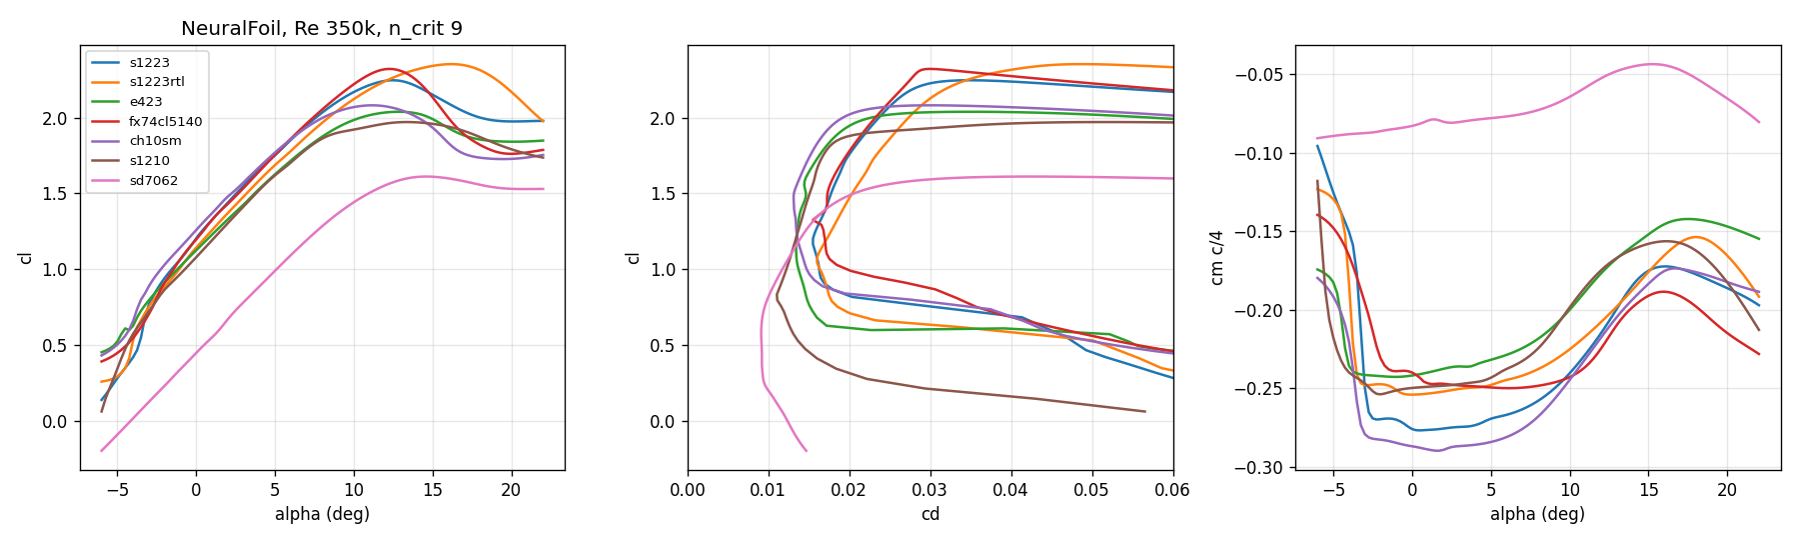
analysis/sizing/out/airfoil_polars.png
