Xavier8264/SAE-Aero-Design/analysis/sizing/out/da_march_hist.png

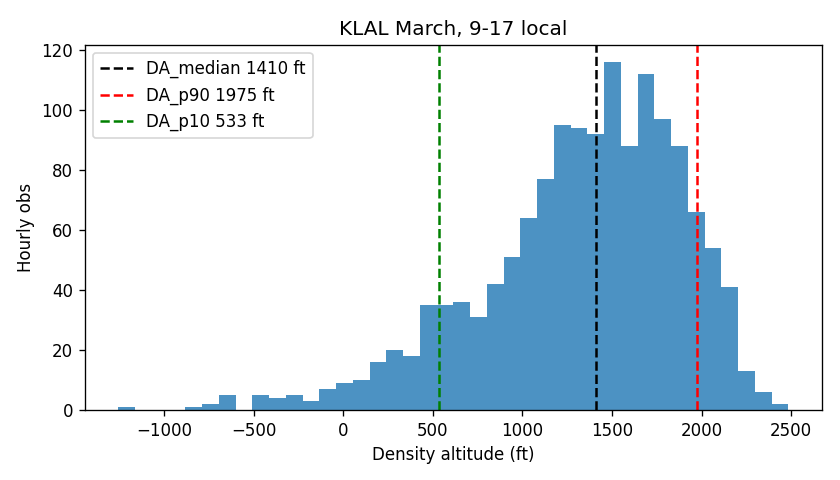
analysis/sizing/out/da_march_hist.png
