Xavier8264/SAE-Aero-Design/analysis/sizing/out/design_payload_vs_DA.png

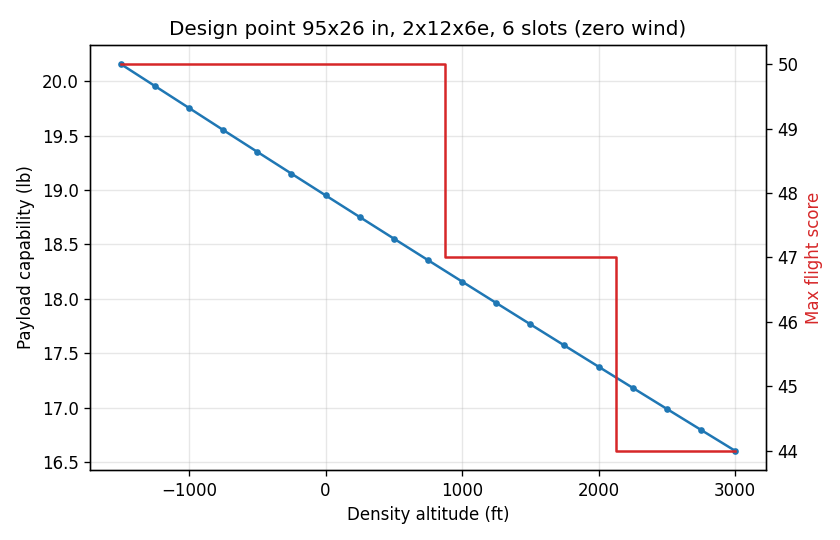
analysis/sizing/out/design_payload_vs_DA.png
