Xavier8264/SAE-Aero-Design/analysis/sizing/out/prop_thrust_vs_V.png

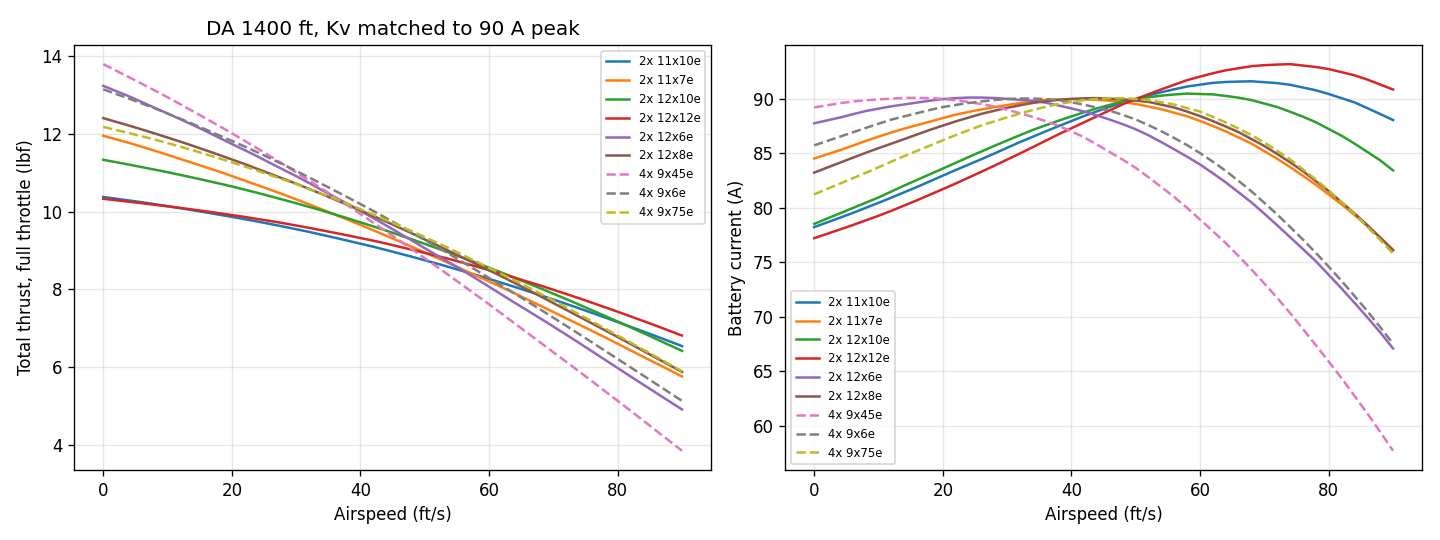
analysis/sizing/out/prop_thrust_vs_V.png
