Xavier8264/SAE-Aero-Design/analysis/sizing/out/scoring_fs_vs_payload.png

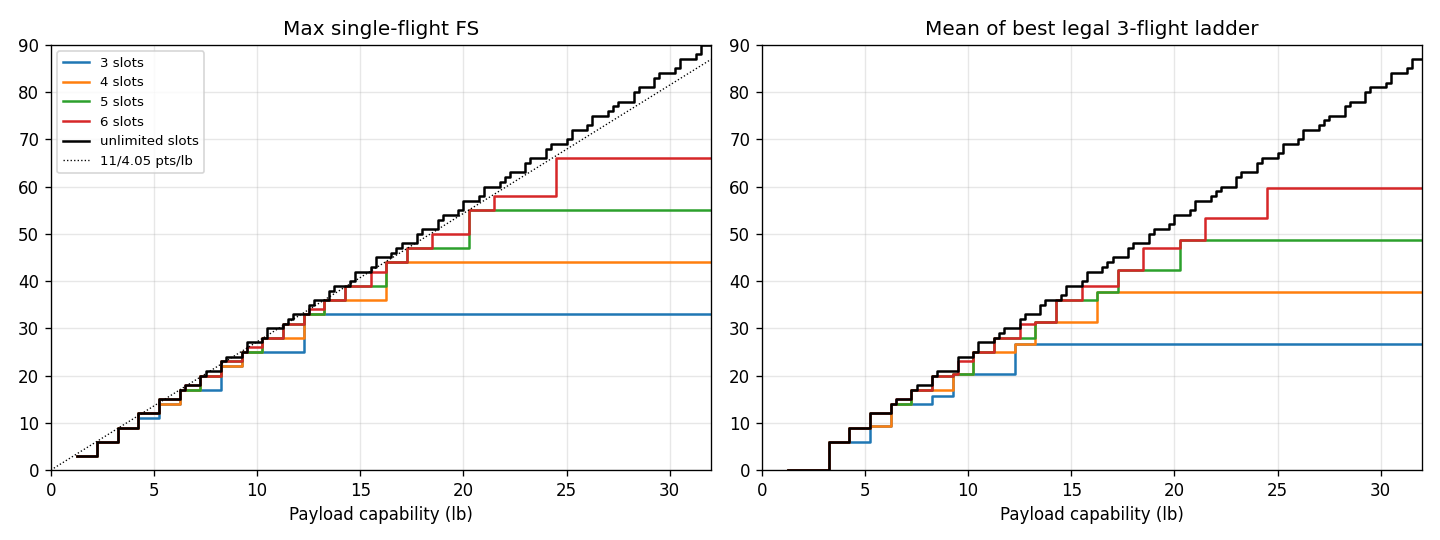
analysis/sizing/out/scoring_fs_vs_payload.png
