Xavier8264/SAE-Aero-Design/analysis/sizing/out/sweep_payload_vs_S.png

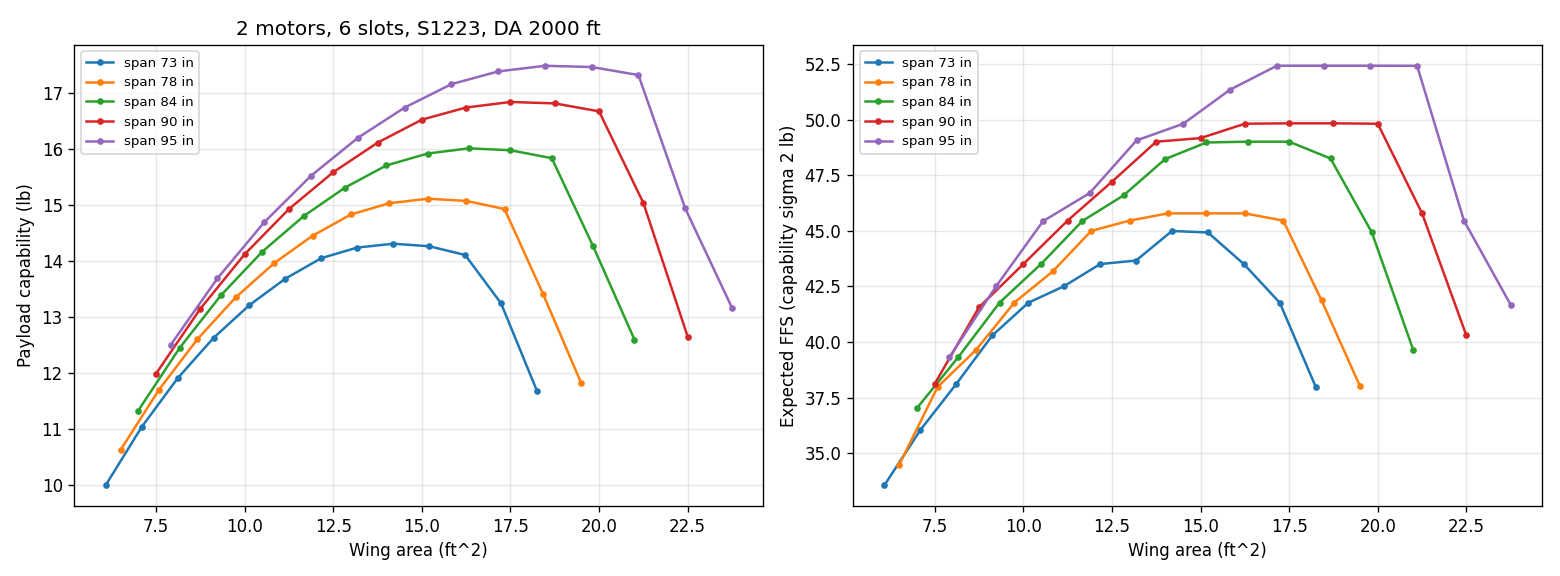
analysis/sizing/out/sweep_payload_vs_S.png
