Xavier8264/SAE-Aero-Design/analysis/sizing/out/takeoff_wto_vs_S.png

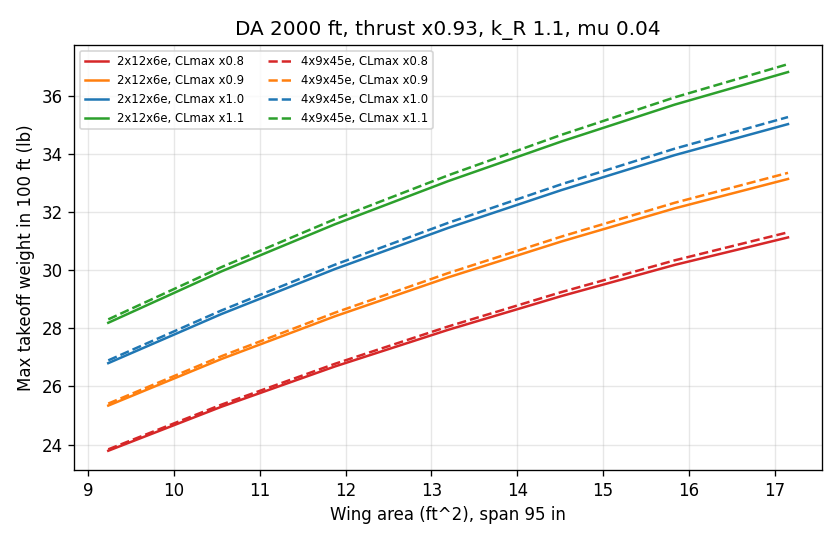
analysis/sizing/out/takeoff_wto_vs_S.png
