Xavier8264/SAE-Aero-Design/reference/render/rules_2027_p44.png

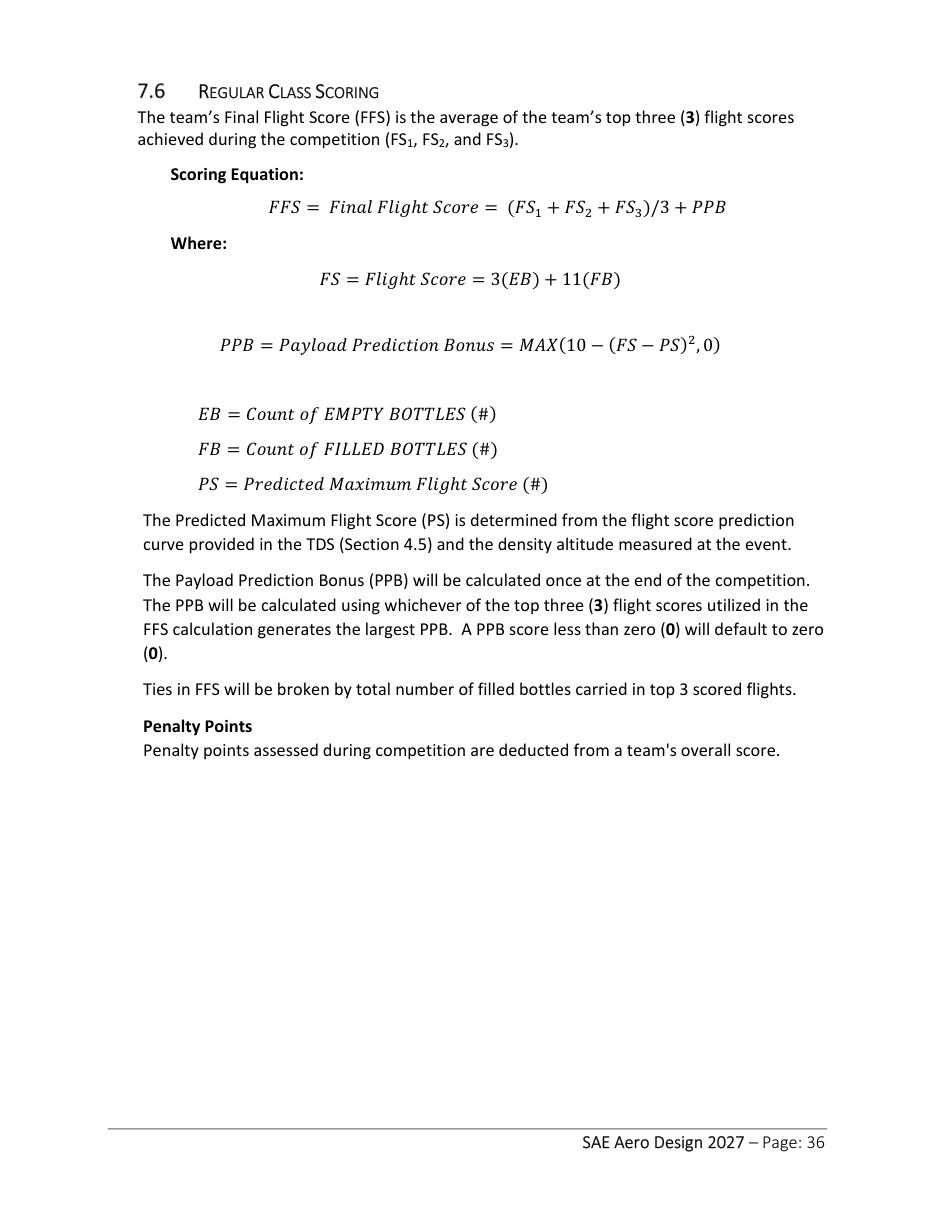
reference/render/rules_2027_p44.png
