Xavier8264/SAE-Aero-Design/Solidworks/SunSky Motor X2820.SLDPRT

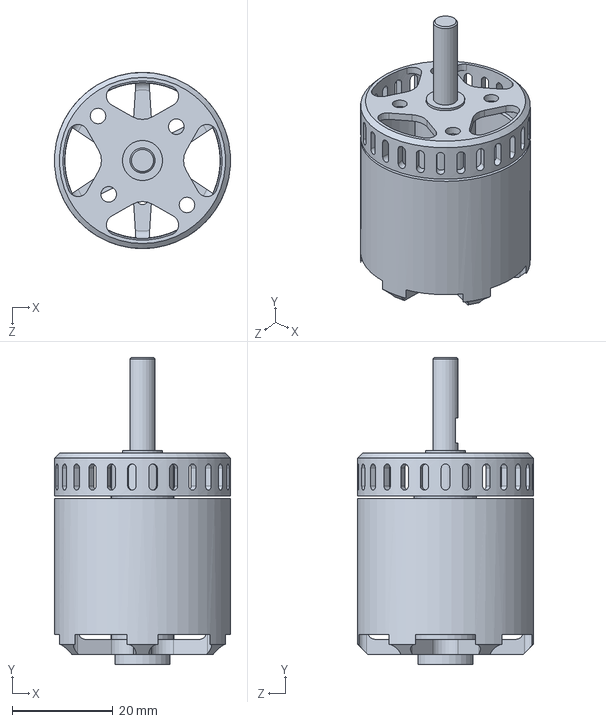
[picture p10: CAD file, 2026-09-24]
Solidworks/SunSky Motor X2820.SLDPRT
35.0 x 61.0 x 35.0 mm
