Xavier8264/SAE-Aero-Design/analysis/tests/out/predict_config/summary.txt

Ceiling line check over 9 points: refit K 776.2 rpm/V, R' 75.0 mOhm (log: 776.1 / 75.0); max |err| vs log line 0.35 pct
Per-prop calibration against APC PER3 (k_t thrust, k_q torque/current):
          k_t  k_t_sd  n_kt  k_t_all    k_q  k_q_sd  n_kq
12x10e  1.009   0.014    11    1.006  1.170   0.016     2
12x6e   1.018   0.012    10    1.006  1.113   0.014     3
12x8e   0.981   0.011    43    0.975  1.042     NaN     1
9x45e   0.973   0.027     6    0.950  1.150   0.016     3
Ceiling points: 12x8E 8228 rpm 33.7 A 13.09 V k_q 1.042; 12x6E 8440 rpm 29.2 A 13.07 V k_q 1.129; 12x6E 8400 rpm 28.4 A 12.95 V k_q 1.107; 9x4.5E 10041 rpm 13.3 A 13.93 V k_q 1.139; 9x4.5E 9997 rpm 13.3 A 13.87 V k_q 1.142; 9x4.5E 9953 rpm 13.4 A 13.84 V k_q 1.169; 12x10E 7386 rpm 36.4 A 12.24 V k_q 1.158; 12x6E 8585 rpm 29.5 A 13.28 V k_q 1.104; 12x10E 7337 rpm 36.6 A 12.22 V k_q 1.182

Predictions, full throttle, DA 1400 ft (rho 1.1756), T0 static, TVR at 36.4 ft/s; totals per aircraft
-- ESC as set (776.1, 0.075), pack fresh ideal (16.4, 0.039)
    layout     factors   variant  rpm0  T0_lbf  TVR_lbf  I_motor_pk_A  pct_46A  I_pack_pk_A  V_batt_min  below_LVC
 4 x 9x75e  from 9x45e band high  9549   10.73     8.81          19.4       42         77.5       13.38      False
  4 x 9x6e  from 9x45e band high  9907   10.58     8.13          16.4       36         65.7       13.84      False
 4 x 9x75e  from 9x45e   nominal  9363    9.85     8.02          20.5       45         81.9       13.21      False
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
  stiff 16.8 V, 0 ohm pack: 4x9x6e 15.23/12.64 28A | 2x12x8e 15.01/12.69 60A | 2x12x10e 14.58/12.78 73A | 2x12x6e 14.46/11.42 50A | 4x9x45e 13.49/10.05 21A
