Xavier8264/SAE-Aero-Design/analysis/tests/out/predict_x2820.csv

prop | case | n_live | rpm | rpm_limit | T_per_motor_lbf | T_per_motor_g | T_total_lbf | I_per_motor_A | I_batt_A | V_batt_V | P_elec_per_motor_W | P_shaft_per_motor_W | pct_of_I_max | g_per_W
12x6e | stand, 1 motor | 1 | 10531 | 12500 | 6.67 | 3024 | 6.67 | 41.1 | 41.1 | 14.97 | 615 | 529 | 89 | 4.91
12x6e | aircraft, 2 motors | 2 | 10007 | 12500 | 6.0 | 2720 | 11.99 | 37.1 | 74.3 | 14.14 | 525 | 453 | 81 | 5.18
12x8e | stand, 1 motor | 1 | 10074 | 12500 | 7.08 | 3210 | 7.08 | 49.4 | 49.4 | 14.77 | 729 | 611 | 107 | 4.4
12x8e | aircraft, 2 motors | 2 | 9494 | 12500 | 6.27 | 2845 | 12.54 | 44.0 | 87.9 | 13.8 | 607 | 511 | 96 | 4.69
12x10e | stand, 1 motor | 1 | 9736 | 12500 | 7.06 | 3201 | 7.06 | 55.5 | 55.5 | 14.61 | 811 | 665 | 121 | 3.95
12x10e | aircraft, 2 motors | 2 | 9125 | 12500 | 6.19 | 2808 | 12.38 | 48.9 | 97.7 | 13.56 | 663 | 547 | 106 | 4.24
9x6e | stand, 1 motor | 1 | 11635 | 16667 | 3.6 | 1634 | 3.6 | 21.1 | 21.1 | 15.47 | 327 | 294 | 46 | 5.0
9x6e | aircraft, 4 motors | 4 | 10720 | 16667 | 3.05 | 1383 | 12.19 | 18.1 | 72.2 | 14.19 | 256 | 230 | 39 | 5.39
9x45e | stand, 1 motor | 1 | 11883 | 16667 | 3.16 | 1435 | 3.16 | 16.6 | 16.6 | 15.58 | 259 | 233 | 36 | 5.55
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
