Xavier8264/SAE-Aero-Design/analysis/tests/data/12x8E_blue_states.csv

state_id | t_start_s | t_end_s | t_mid_s | n_frames | row0 | row1 | I_A | V_V | aux_value | aux_unit | P_W | P_minus_VxI_W | T_g_mean | T_g_median | T_g_min | T_g_max | n_thrust_frames | evidence_min | raw_agree_frac | flags
0 | 0.000 | 0.167 | 0.083 | 6 | [ 0.12A 15.41V] | [ 0.17Ap 1.8W] | 0.12 | 15.41 | 0.17 | Ap | 1.8 | -0.049 | 0.0 | 0.0 | 0 | 0 | 6 | 20.726 | 1.000 | short
1 | 0.200 | 0.600 | 0.400 | 13 | [ 0.12A 15.40V] | [ 0.17Ap 1.8W] | 0.12 | 15.40 | 0.17 | Ap | 1.8 | -0.048 | 0.0 | 0.0 | 0 | 0 | 13 | 42.112 | 1.000
2 | 0.700 | 1.033 | 0.867 | 11 | [ 0.11A 15.41V] | [ 0.17Ap 1.8W] | 0.11 | 15.41 | 0.17 | Ap | 1.8 | 0.105 | 0.0 | 0.0 | 0 | 0 | 11 | 37.444 | 1.000
3 | 1.067 | 1.200 | 1.133 | 5 | [ 0.11A 15.40V] | [ 0.17Ap 1.8W] | 0.11 | 15.40 | 0.17 | Ap | 1.8 | 0.106 | 0.0 | 0.0 | 0 | 0 | 5 | 15.722 | 1.000 | short
4 | 1.300 | 2.100 | 1.700 | 25 | [ 0.11A 15.40V] | [ 15.40Vm 1.8W] | 0.11 | 15.40 | 15.40 | Vm | 1.8 | 0.106 | 0.0 | 0.0 | 0 | 0 | 25 | 85.394 | 1.000
5 | 2.133 | 2.467 | 2.300 | 11 | [ 0.11A 15.40V] | [ 15.40Vm 1.7W] | 0.11 | 15.40 | 15.40 | Vm | 1.7 | 0.006 | 0.0 | 0.0 | 0 | 0 | 11 | 37.157 | 1.000
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
