Xavier8264/SAE-Aero-Design/analysis/tests/data/12x8E_frames.csv

frame | t_s | blue_valid | thrust_valid | reg_blue | reg_thrust | ecc_blue | ecc_thrust | blue_gain | blue_rms | blue_rel_rms | blue_weight | blur_sx_px | blur_sy_px | blue_iters | blue_stable | blue_raw_row0 | blue_raw_row1 | blue_raw_min_margin | blue_row0 | blue_row1 | blue_state_id | thrust_raw | thrust_raw_min_margin | thrust_sigma | thrust_weight | thrust_display | T_g | thrust_possible_mix | t_proc_s
0 | 0.000 | 1 | 1 | 2 | 2 | 0.979 | 0.796 | 1.078 | 7.965 | 7.389 | 1.000 | 4.677 | 3.396 | 1 | 1 | [ 0.12A 15.41V] | [ 0.17Ap 1.8W] | 3.449 | [ 0.12A 15.41V] | [ 0.17Ap 1.8W] | 0 | [ 0] | 0.980 | 0.036 | 0.581 | [ 0] | 0 | 0 | 26.042
1 | 0.033 | 1 | 1 | 2 | 2 | 0.978 | 0.796 | 1.076 | 7.795 | 7.241 | 1.000 | 4.735 | 3.497 | 1 | 1 | [ 0.12A 15.41V] | [ 0.17Ap 1.8W] | 3.472 | [ 0.12A 15.41V] | [ 0.17Ap 1.8W] | 0 | [ 0] | 0.971 | 0.036 | 0.589 | [ 0] | 0 | 0 | 16.807
2 | 0.067 | 1 | 1 | 2 | 2 | 0.978 | 0.796 | 1.079 | 7.810 | 7.236 | 1.000 | 4.806 | 3.392 | 1 | 1 | [ 0.12A 15.41V] | [ 0.17Ap 1.8W] | 3.451 | [ 0.12A 15.41V] | [ 0.17Ap 1.8W] | 0 | [ 0] | 0.971 | 0.040 | 0.475 | [ 0] | 0 | 0 | 24.494
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
