Xavier8264/SAE-Aero-Design/analysis/tests/data/12x8E_smoke_frames.csv

frame | t_s | blue_valid | thrust_valid | reg_blue | reg_thrust | ecc_blue | ecc_thrust | blue_gain | blue_rms | blue_rel_rms | blue_weight | blur_sx_px | blur_sy_px | blue_iters | blue_stable | blue_raw_row0 | blue_raw_row1 | blue_raw_min_margin | blue_row0 | blue_row1 | blue_state_id | thrust_raw | thrust_raw_min_margin | thrust_sigma | thrust_weight | thrust_display | T_g | thrust_possible_mix | t_proc_s
0 | 0.000 | 1 | 1 | 2 | 2 | 0.983 | 0.645 | 1.087 | 8.510 | 7.826 | 1.000 | 4.669 | 3.330 | 1 | 1 | [ 0.12A 15.41V] | [ 0.17Ap 1.8W] | 3.555 | [ 0.12A 15.41V] | [ 0.17Ap 1.8W] | 0 | [ 0] | 1.000 | 0.033 | 1.000 | [ 0] | 0 | 0 | 16.807
1 | 0.033 | 1 | 1 | 2 | 2 | 0.983 | 0.645 | 1.086 | 8.312 | 7.657 | 1.000 | 4.700 | 3.423 | 1 | 1 | [ 0.12A 15.41V] | [ 0.17Ap 1.8W] | 3.585 | [ 0.12A 15.41V] | [ 0.17Ap 1.8W] | 0 | [ 0] | 0.999 | 0.033 | 0.981 | [ 0] | 0 | 0 | 9.241
2 | 0.067 | 1 | 1 | 2 | 2 | 0.983 | 0.644 | 1.088 | 8.409 | 7.729 | 1.000 | 4.791 | 3.299 | 1 | 1 | [ 0.12A 15.41V] | [ 0.17Ap 1.8W] | 3.571 | [ 0.12A 15.41V] | [ 0.17Ap 1.8W] | 0 | [ 0] | 0.993 | 0.033 | 0.973 | [ 0] | 0 | 0 | 11.863
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
