Xavier8264/SAE-Aero-Design/analysis/tests/out/predict_config/calibration.csv

 | k_t | k_t_sd | n_kt | k_t_all | k_q | k_q_sd | n_kq
12x10e | 1.0087746845362267 | 0.014471746558062755 | 11 | 1.0056310115637137 | 1.170079938764285 | 0.016406007737246094 | 2
12x6e | 1.0182361317957802 | 0.011867550779931308 | 10 | 1.0063819030253627 | 1.1133248210435864 | 0.013746909868632076 | 3
12x8e | 0.98121 | 0.010730879892998625 | 43 | 0.97454 | 1.0420652473376937 |  | 1
9x45e | 0.9728630488072254 | 0.02680558167887814 | 6 | 0.9503459339826296 | 1.150064317438659 | 0.016258814950448806 | 3
