Xavier8264/SAE-Aero-Design/analysis/tests/out/reduce/12x8E_points.csv

state_id | t_start_s | t_end_s | win_start_s | win_end_s | n_hops | n_voiced | rpm_mean | rpm_std | rpm_min | rpm_max | rpm_slope_per_s | spread_rpm_median | I_A | V_V | T_g_mean | T_apc_g | T_over_Tapc | flags | full_throttle | Q_apc_Nm | T_ratio | P_shaft_apc_W | P_elec_W | Kv_A_pt | R_A_pt | Kv_B_pt | kQ_B_pt
49 | 25.367 | 25.667 | 25.017 | 25.35 | 17 | 17 | 2120 | 7.2 | 2102 | 2131.4 | 43.8 | 2.25 | 1.04 | 15.34 | 114.9 | 138.99 | 0.812 |  | False | 0.028497 | 0.82669 | 6.3264 | 15.954
50 | 25.833 | 26.167 | 25.483 | 25.85 | 18 | 18 | 2129.4 | 3.4 | 2120.6 | 2132.9 | 8.9 | 1.92 | 1.01 | 15.32 | 114 | 140.23 | 0.798 |  | False | 0.028738 | 0.81296 | 6.4084 | 15.473
51 | 26.233 | 26.633 | 25.883 | 26.316 | 21 | 21 | 2131.9 | 4.4 | 2119.7 | 2137.6 | 3.8 | 1.31 | 1.02 | 15.32 | 114.8 | 140.56 | 0.802 |  | False | 0.028803 | 0.81675 | 6.4303 | 15.626
53 | 27.133 | 27.5 | 26.783 | 27.183 | 20 | 20 | 2274.4 | 4.1 | 2267.4 | 2280.5 | 26.7 | 2.46 | 1.16 | 15.32 | 133.9 | 160.04 | 0.822 |  | False | 0.03258 | 0.83667 | 7.7597 | 17.771
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
