Xavier8264/SAE-Aero-Design/analysis/tests/out/reduce/12x8E_predict.csv

fit | prop | pack | V0 | R_pack_mOhm | n_motors | rpm | I_motor_A | I_pack_A | V_batt | T_motor_g | T_total_lbf | pct_of_46A
A | 12x6e | this pack | 15.365853796943451 | 68.3 | 1 | 8774 | 29.2 | 29.2 | 13.37 | 2036 | 4.49 | 63
A | 12x6e | this pack | 15.365853796943451 | 68.3 | 2 | 8006 | 24.5 | 49.0 | 12.02 | 1688 | 7.44 | 53
A | 12x6e | fresh 16.0/R ramp | 16.0 | 68.3 | 1 | 9057 | 31.0 | 31.0 | 13.88 | 2173 | 4.79 | 67
A | 12x6e | fresh 16.0/R ramp | 16.0 | 68.3 | 2 | 8254 | 26.0 | 51.9 | 12.45 | 1797 | 7.92 | 56
A | 12x6e | fresh 16.4/R step | 16.4 | 39.2 | 1 | 9676 | 35.2 | 35.2 | 15.02 | 2488 | 5.49 | 77
A | 12x6e | fresh 16.4/R step | 16.4 | 39.2 | 2 | 9094 | 31.2 | 62.5 | 13.95 | 2191 | 9.66 | 68
A | 12x8e | this pack | 15.365853796943451 | 68.3 | 1 | 8218 | 33.6 | 33.6 | 13.07 | 2077 | 4.58 | 73
A | 12x8e | this pack | 15.365853796943451 | 68.3 | 2 | 7428 | 27.7 | 55.4 | 11.58 | 1692 | 7.46 | 60
A | 12x8e | fresh 16.0/R ramp | 16.0 | 68.3 | 1 | 8473 | 35.6 | 35.6 | 13.56 | 2211 | 4.87 | 77
A | 12x8e | fresh 16.0/R ramp | 16.0 | 68.3 | 2 | 7652 | 29.3 | 58.6 | 12.0 | 1797 | 7.92 | 64
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
