Xavier8264/SAE-Aero-Design/analysis/tests/data/12x8E_rpm.csv

t_s | voiced | rpm | F_Hz | F_coarse_Hz | salience | n_harm | harmonics | spread_rpm | snr_max_dB | method | F_limit_Hz
0.000 | 0 |  |  |  |  |  |  |  |  |  | 0.0
0.020 | 0 |  |  |  |  |  |  |  |  |  | 0.0
0.040 | 0 |  |  |  |  |  |  |  |  |  | 0.0
0.060 | 0 |  |  |  |  |  |  |  |  |  | 0.0
0.080 | 0 |  |  |  |  |  |  |  |  |  | 0.0
0.100 | 0 |  |  |  |  |  |  |  |  |  | 0.0
0.120 | 0 |  |  |  |  |  |  |  |  |  | 0.0
0.140 | 0 |  |  |  |  |  |  |  |  |  | 0.0
0.160 | 0 |  |  |  |  |  |  |  |  |  | 0.0
0.180 | 0 |  |  |  |  |  |  |  |  |  | 0.0
0.200 | 0 |  |  |  |  |  |  |  |  |  | 0.0
0.220 | 0 |  |  |  |  |  |  |  |  |  | 0.0
0.240 | 0 |  |  |  |  |  |  |  |  |  | 0.0
0.260 | 0 |  |  |  |  |  |  |  |  |  | 0.0
0.280 | 0 |  |  |  |  |  |  |  |  |  | 0.0
0.300 | 0 |  |  |  |  |  |  |  |  |  | 0.0
0.320 | 0 |  |  |  |  |  |  |  |  |  | 0.0
0.340 | 0 |  |  |  |  |  |  |  |  |  | 0.0
0.360 | 0 |  |  |  |  |  |  |  |  |  | 0.0
0.380 | 0 |  |  |  |  |  |  |  |  |  | 0.0
0.400 | 0 |  |  |  |  |  |  |  |  |  | 0.0
0.420 | 0 |  |  |  |  |  |  |  |  |  | 0.0
0.440 | 0 |  |  |  |  |  |  |  |  |  | 0.0
0.460 | 0 |  |  |  |  |  |  |  |  |  | 0.0
0.480 | 0 |  |  |  |  |  |  |  |  |  | 0.0
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
