Xavier8264/SAE-Aero-Design/analysis/tests/data/12x8E_rpm_states.csv

state_id | t_start_s | t_end_s | win_start_s | win_end_s | n_hops | n_voiced | rpm_mean | rpm_std | rpm_min | rpm_max | rpm_slope_per_s | spread_rpm_median | I_A | V_V | T_g_mean | T_apc_g | T_over_Tapc | flags
0 | 0.000 | 0.167 | -0.350 | -0.150 | 0 | 0 |  |  |  |  |  |  | 0.12 | 15.41 | 0.0 |  |  | motor_off
1 | 0.200 | 0.600 | -0.150 | 0.283 | 15 | 0 |  |  |  |  |  |  | 0.12 | 15.40 | 0.0 |  |  | motor_off
2 | 0.700 | 1.033 | 0.350 | 0.716 | 18 | 0 |  |  |  |  |  |  | 0.11 | 15.41 | 0.0 |  |  | motor_off
3 | 1.067 | 1.200 | 0.717 | 0.883 | 9 | 0 |  |  |  |  |  |  | 0.11 | 15.40 | 0.0 |  |  | motor_off
4 | 1.300 | 2.100 | 0.950 | 1.783 | 42 | 0 |  |  |  |  |  |  | 0.11 | 15.40 | 0.0 |  |  | motor_off
5 | 2.133 | 2.467 | 1.783 | 2.150 | 18 | 0 |  |  |  |  |  |  | 0.11 | 15.40 | 0.0 |  |  | motor_off
6 | 2.567 | 2.867 | 2.217 | 2.550 | 17 | 0 |  |  |  |  |  |  | 0.12 | 15.41 | 0.0 |  |  | motor_off
7 | 2.933 | 3.400 | 2.583 | 3.083 | 25 | 0 |  |  |  |  |  |  | 0.11 | 15.40 | 0.0 |  |  | motor_off
8 | 3.433 | 3.800 | 3.083 | 3.483 | 20 | 0 |  |  |  |  |  |  | 0.11 | 15.40 | 0.0 |  |  | motor_off
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
