Xavier8264/SAE-Aero-Design/analysis/tests/out/audio/12x8E/12x8E_rpm.png

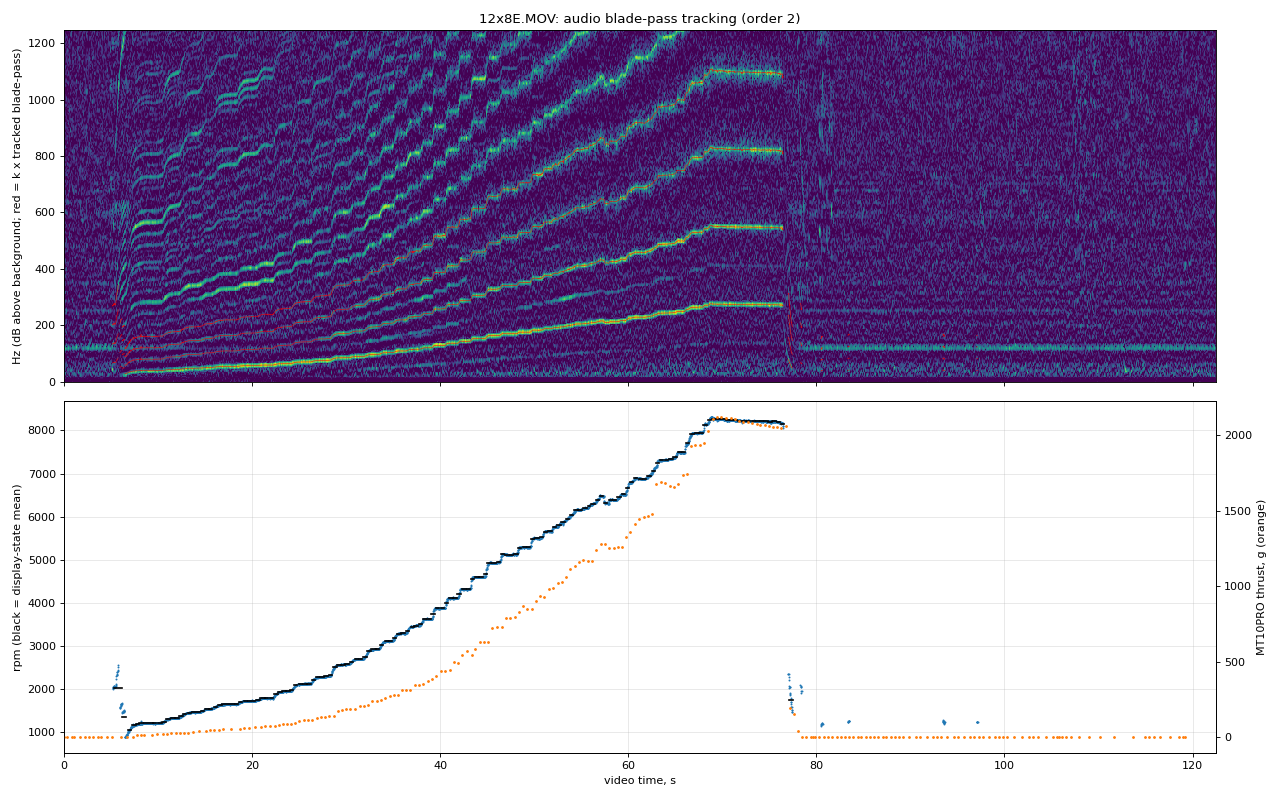
analysis/tests/out/audio/12x8E/12x8E_rpm.png
