Xavier8264/SAE-Aero-Design/analysis/tests/out/audio/2026-09-25_12x10E_T2/2026-09-25_12x10E_T2_rpm.png

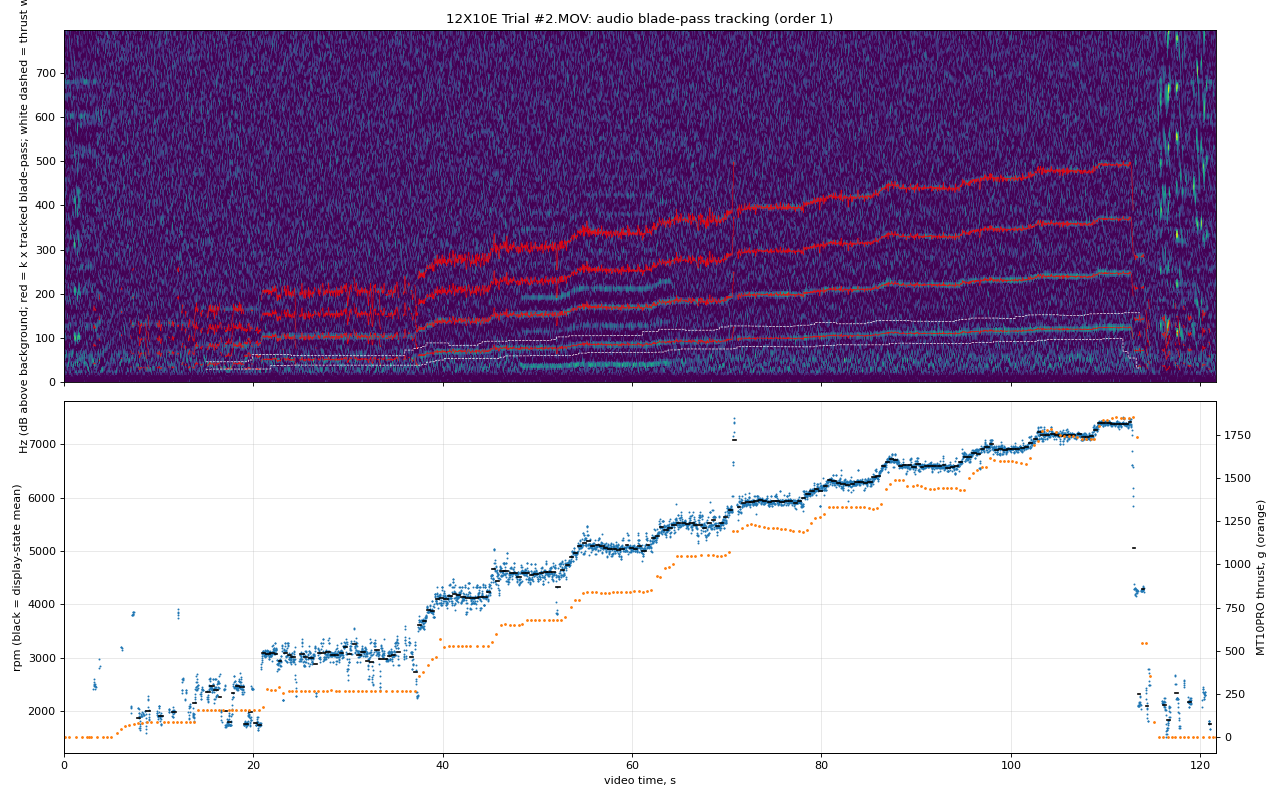
analysis/tests/out/audio/2026-09-25_12x10E_T2/2026-09-25_12x10E_T2_rpm.png
