Xavier8264/SAE-Aero-Design/analysis/tests/out/audio/2026-09-29_9x4.5E_T1/2026-09-29_9x4.5E_T1_rpm.png

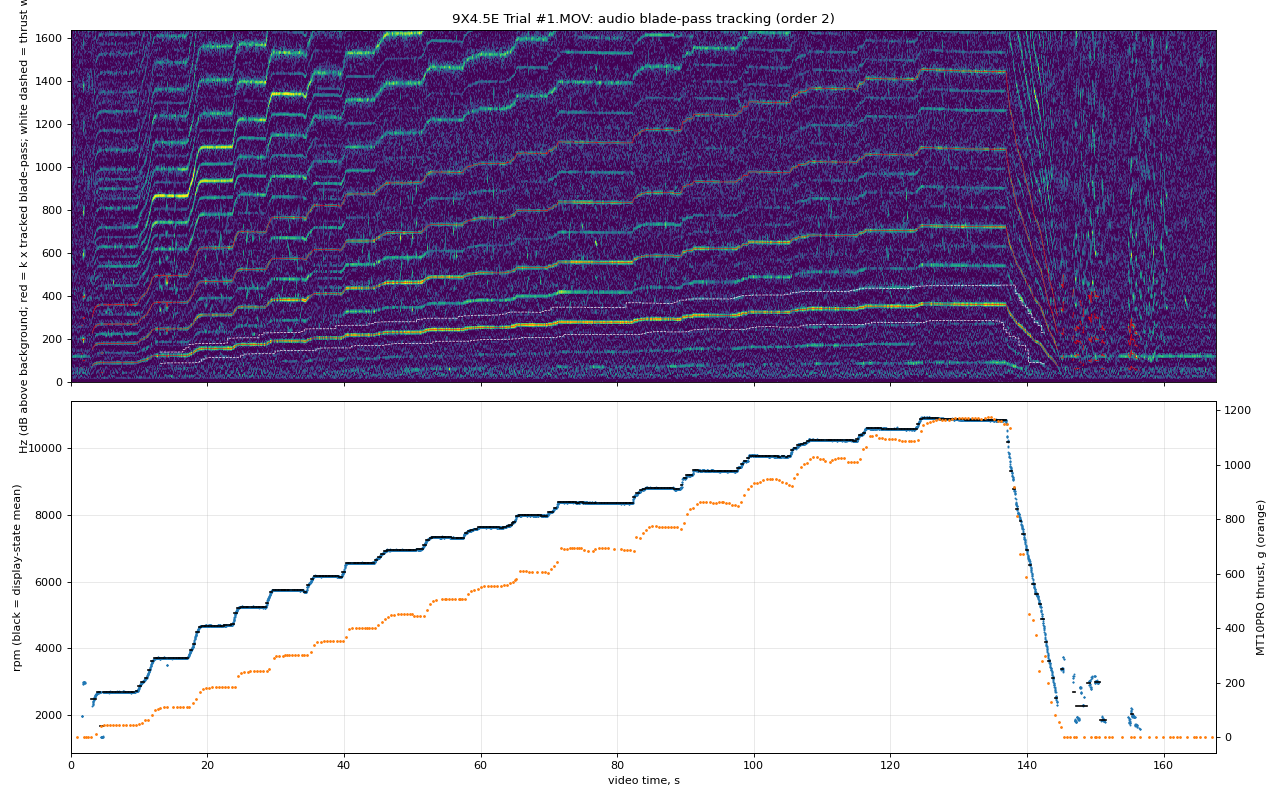
analysis/tests/out/audio/2026-09-29_9x4.5E_T1/2026-09-29_9x4.5E_T1_rpm.png
