Xavier8264/SAE-Aero-Design/analysis/tests/out/audio/2026-09-29_12x8E_T1/2026-09-29_12x8E_T1_rpm.png

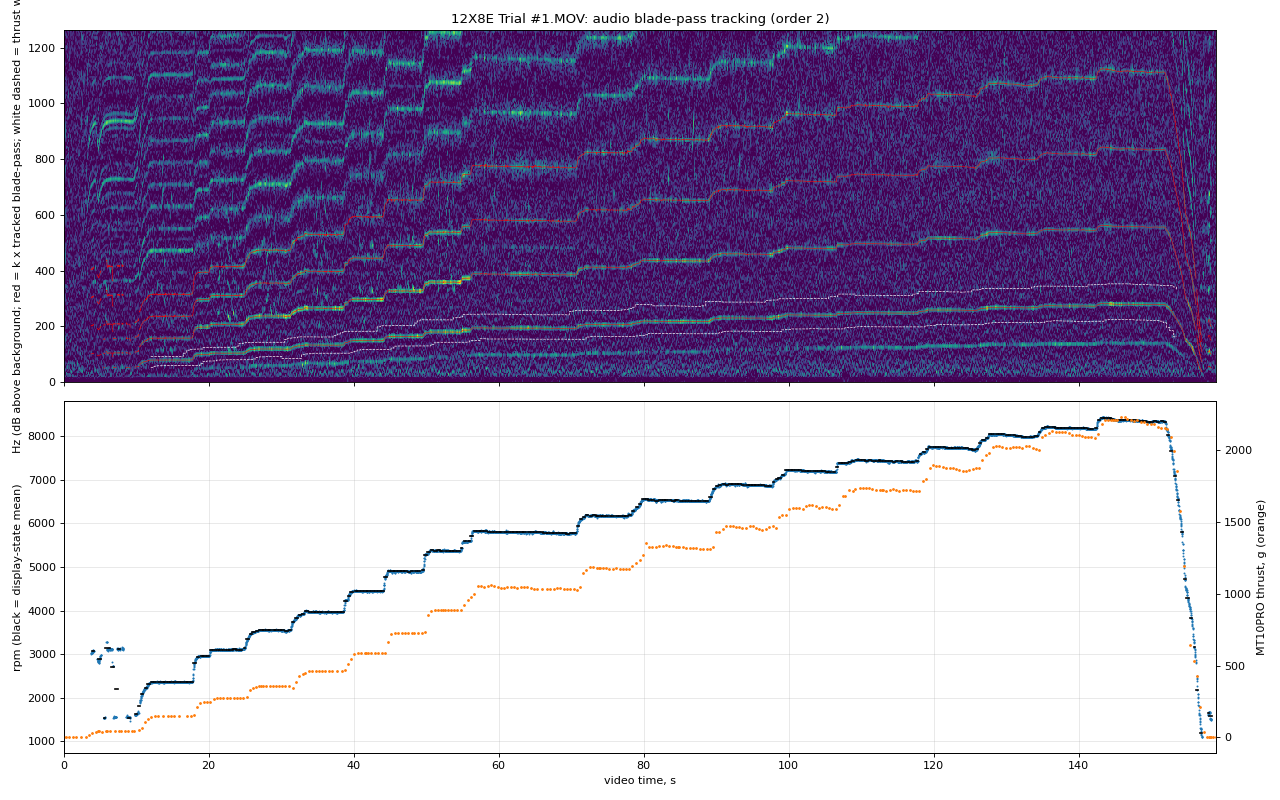
analysis/tests/out/audio/2026-09-29_12x8E_T1/2026-09-29_12x8E_T1_rpm.png
