Xavier8264/SAE-Aero-Design/analysis/tests/out/battery/2026-09-25_9x4.5E_T1_zoom.png

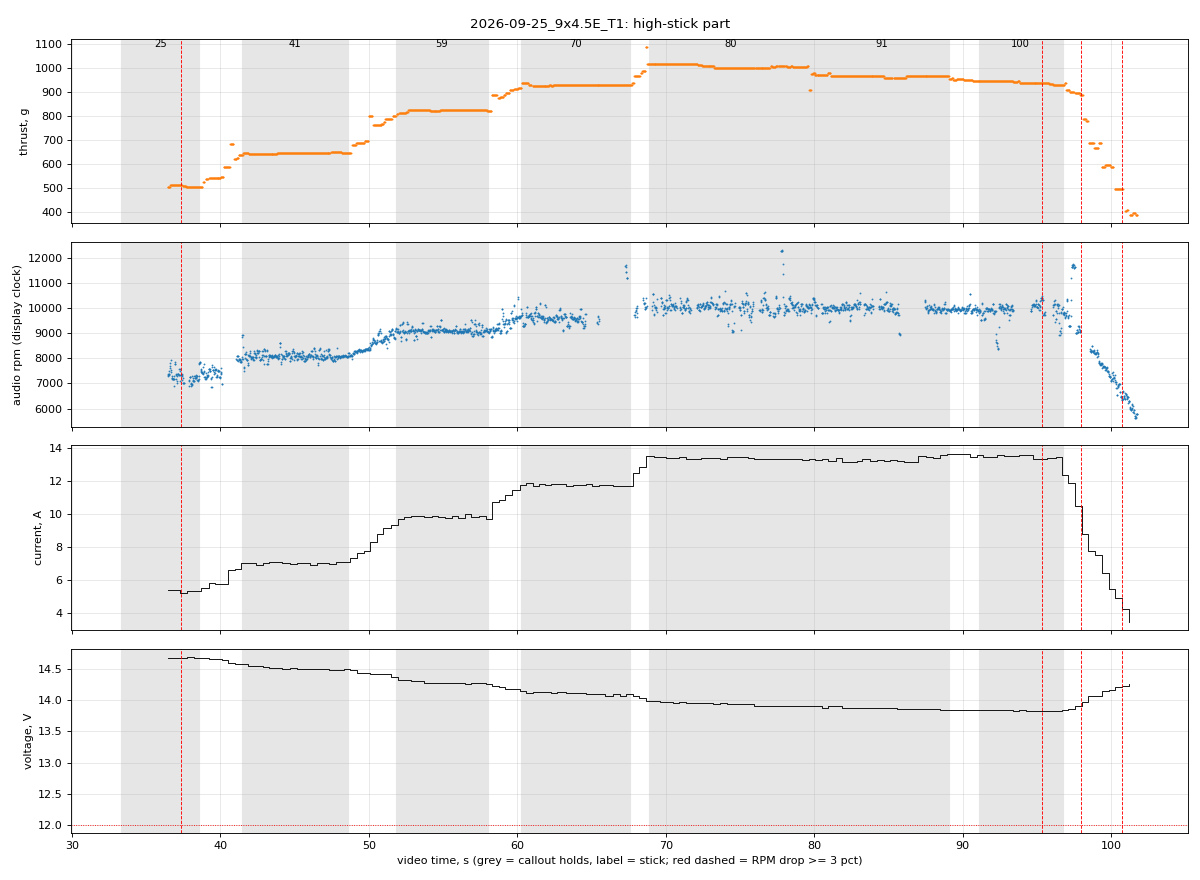
analysis/tests/out/battery/2026-09-25_9x4.5E_T1_zoom.png
