Xavier8264/SAE-Aero-Design/analysis/tests/out/battery/2026-09-25_12x6E_T2_zoom.png

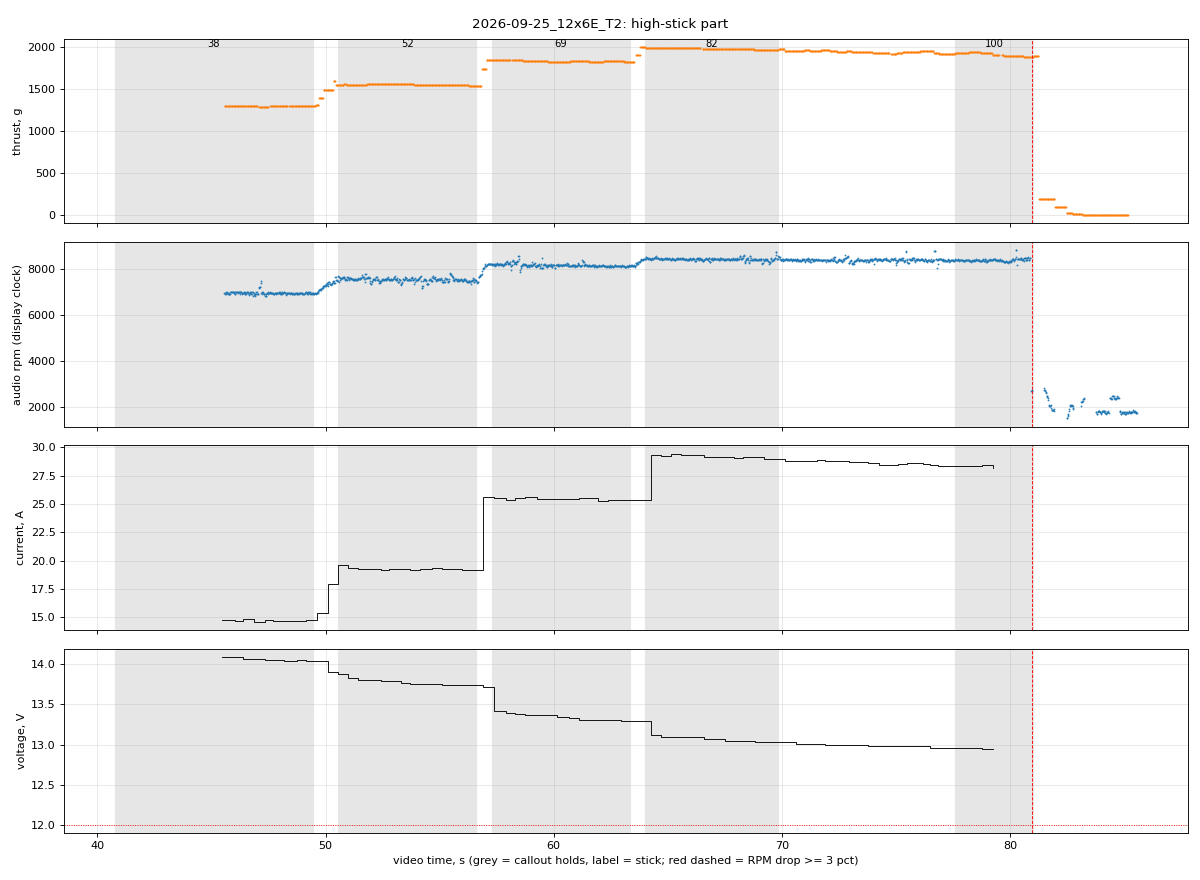
analysis/tests/out/battery/2026-09-25_12x6E_T2_zoom.png
