Xavier8264/SAE-Aero-Design/analysis/tests/out/battery/2026-09-25_12x10E_T1_zoom.png

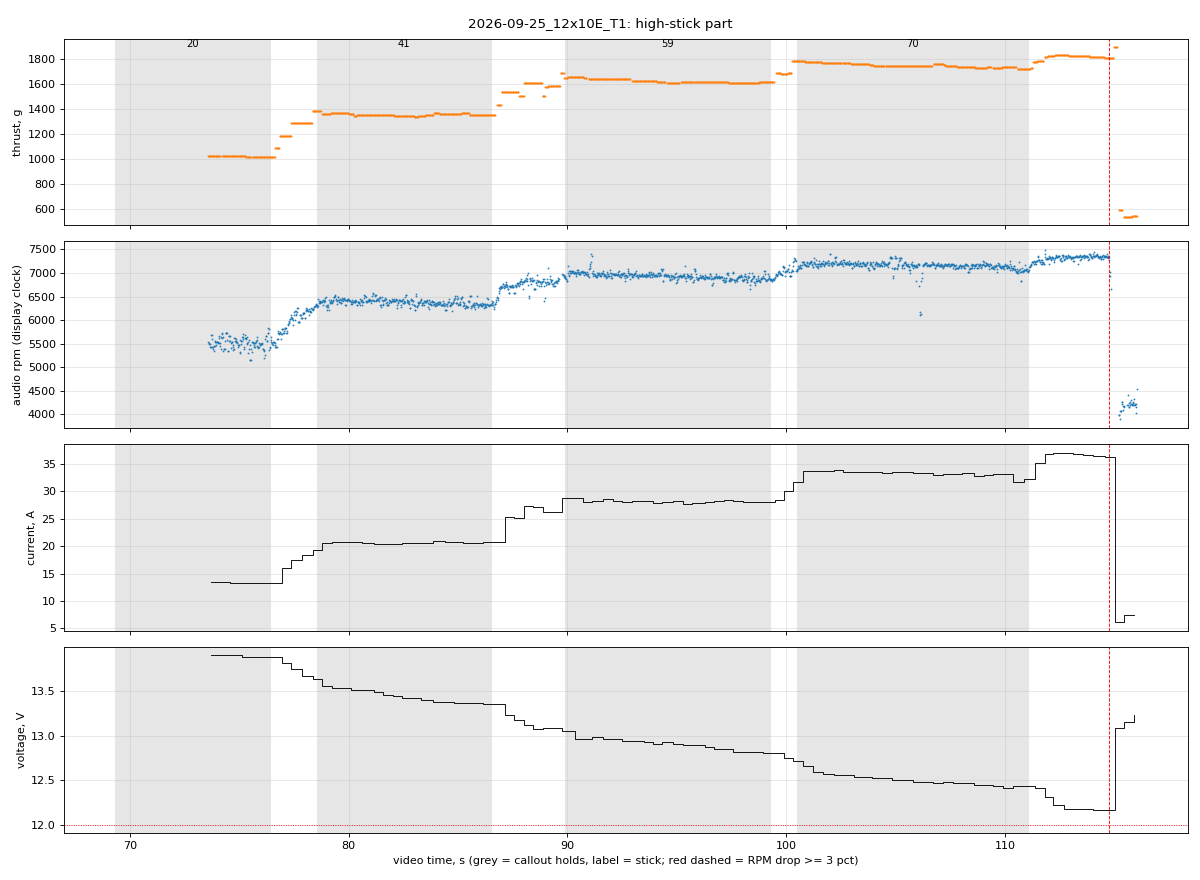
analysis/tests/out/battery/2026-09-25_12x10E_T1_zoom.png
