Xavier8264/SAE-Aero-Design/analysis/tests/out/battery/2026-09-25_battery_vs_stick.png

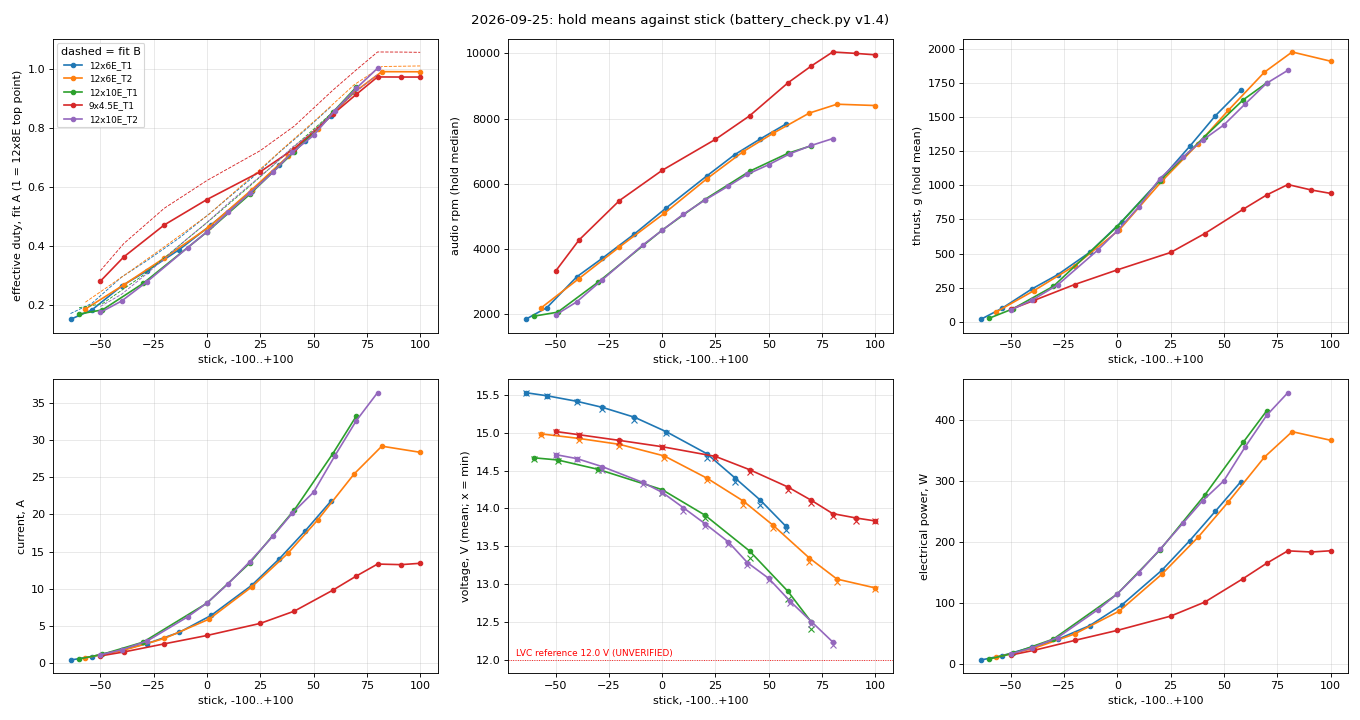
analysis/tests/out/battery/2026-09-25_battery_vs_stick.png
