Xavier8264/SAE-Aero-Design/analysis/tests/out/battery/2026-09-29_12x8E_T1_zoom.png

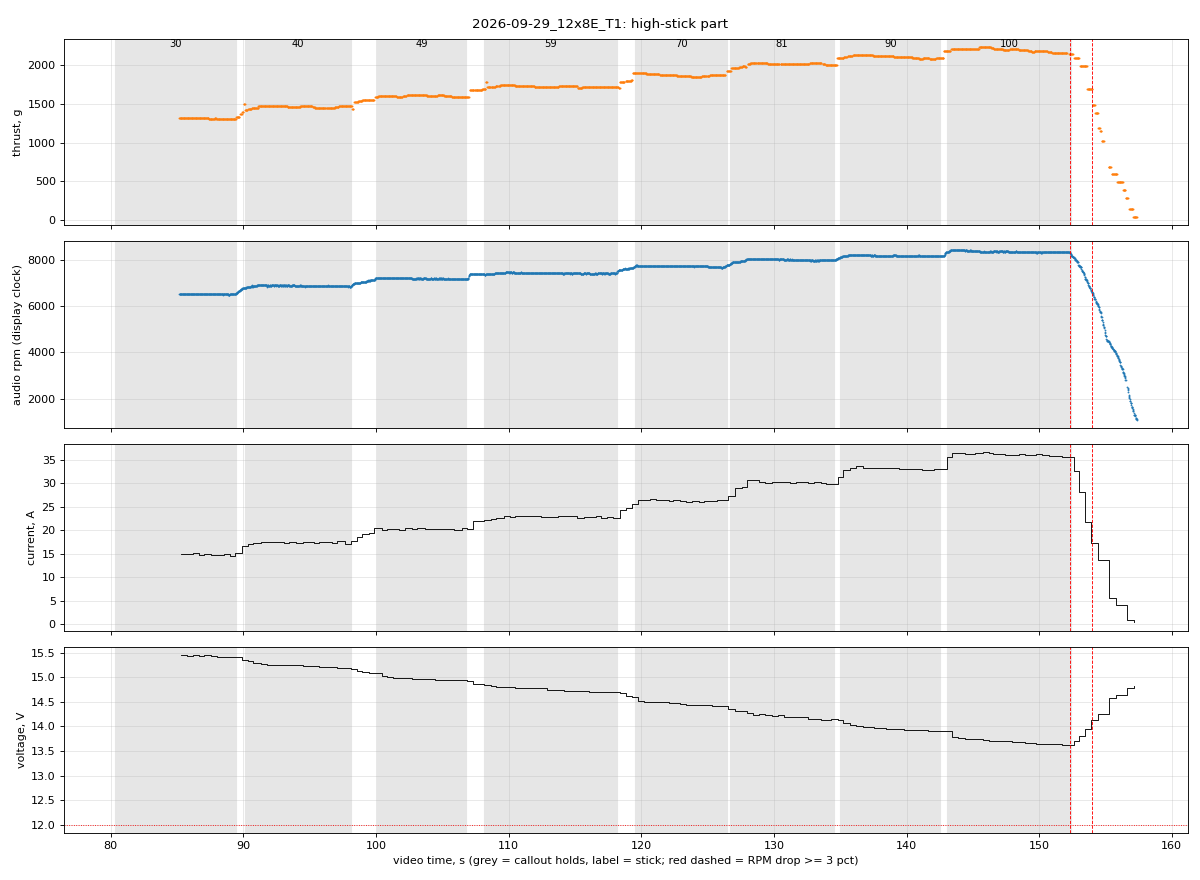
analysis/tests/out/battery/2026-09-29_12x8E_T1_zoom.png
