Xavier8264/SAE-Aero-Design/analysis/tests/out/battery/2026-09-29_battery_vs_stick.png

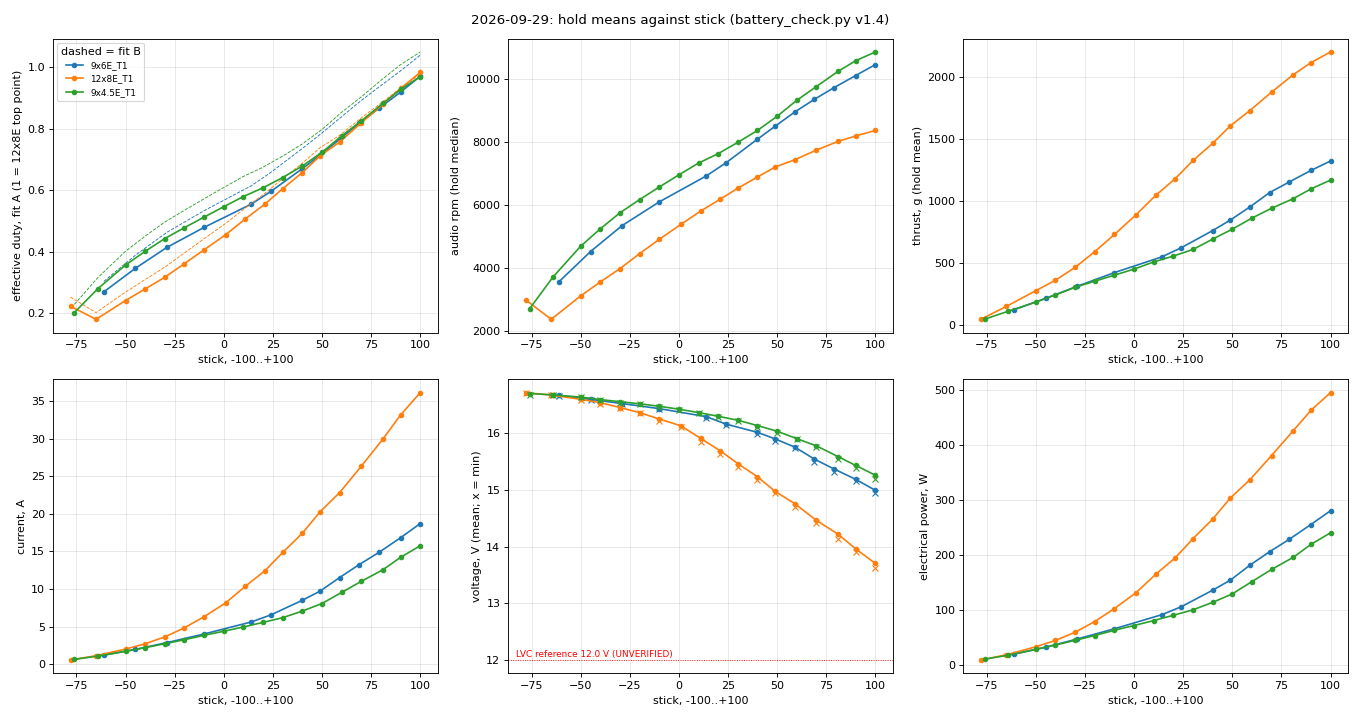
analysis/tests/out/battery/2026-09-29_battery_vs_stick.png
