Xavier8264/SAE-Aero-Design/analysis/tests/out/throttle/2026-09-25_9x4.5E_T1_timeseries.png

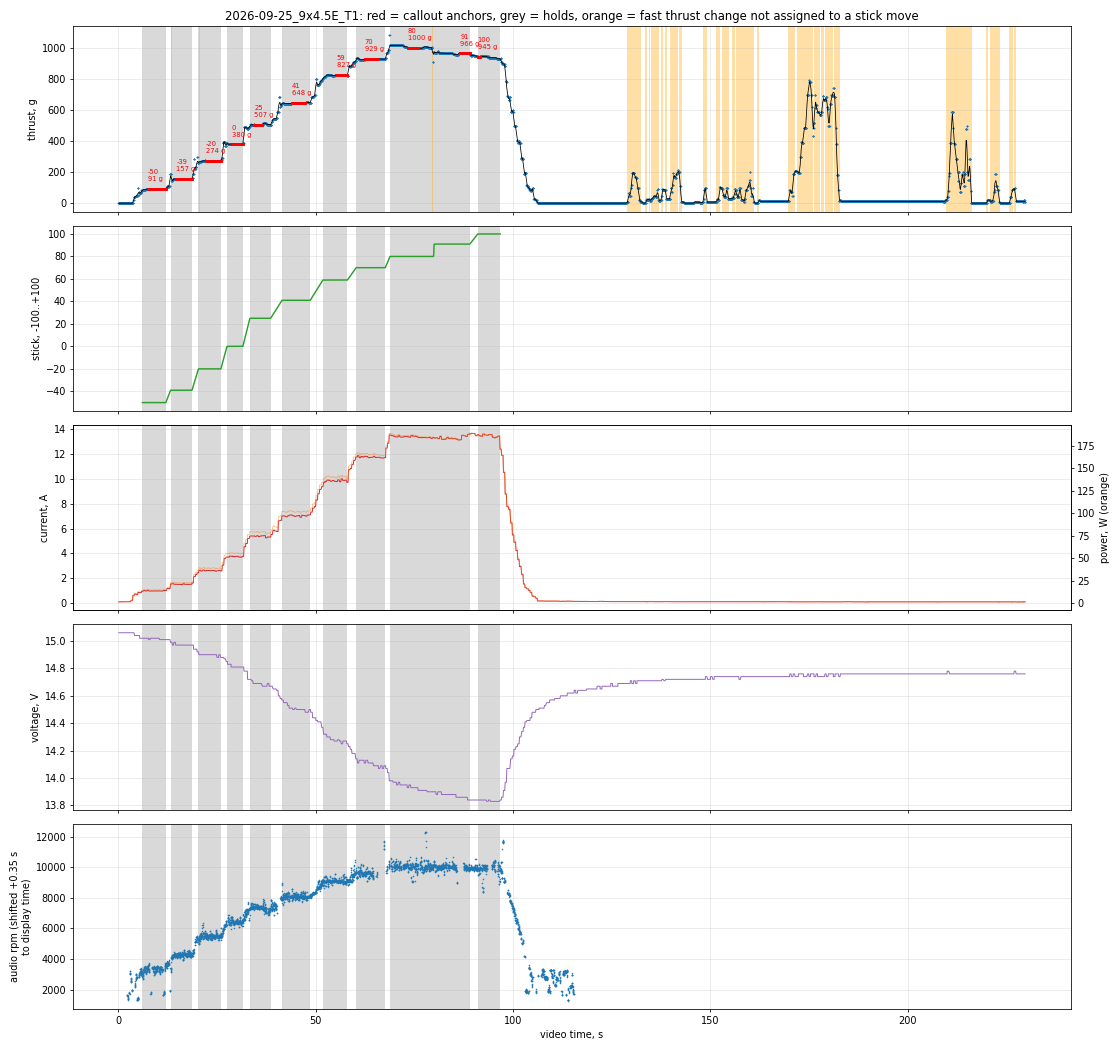
analysis/tests/out/throttle/2026-09-25_9x4.5E_T1_timeseries.png
