Xavier8264/SAE-Aero-Design/analysis/tests/out/throttle/2026-09-25_12x10E_T1_timeseries.png

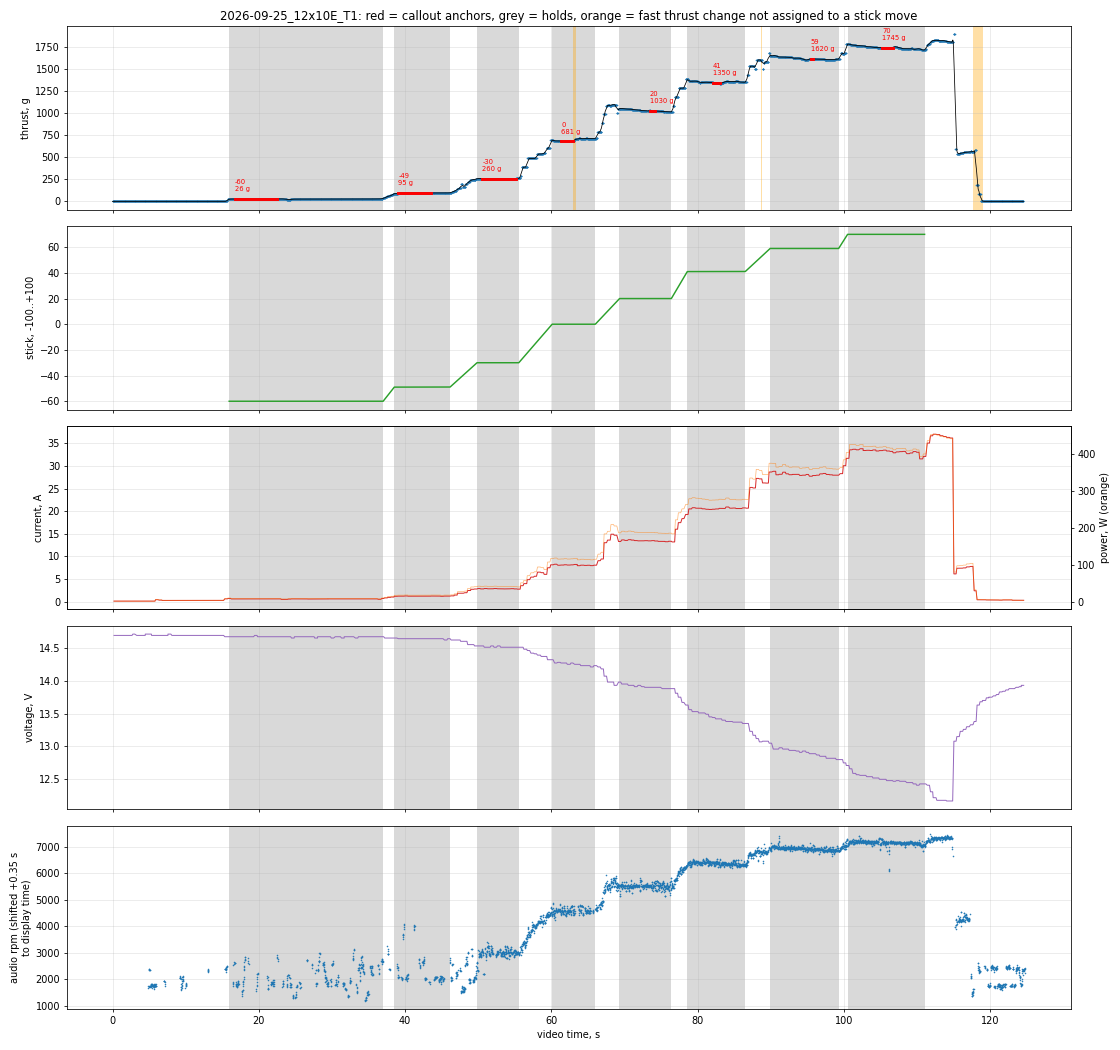
analysis/tests/out/throttle/2026-09-25_12x10E_T1_timeseries.png
