Xavier8264/SAE-Aero-Design/analysis/tests/out/throttle/2026-09-25_vs_throttle.png

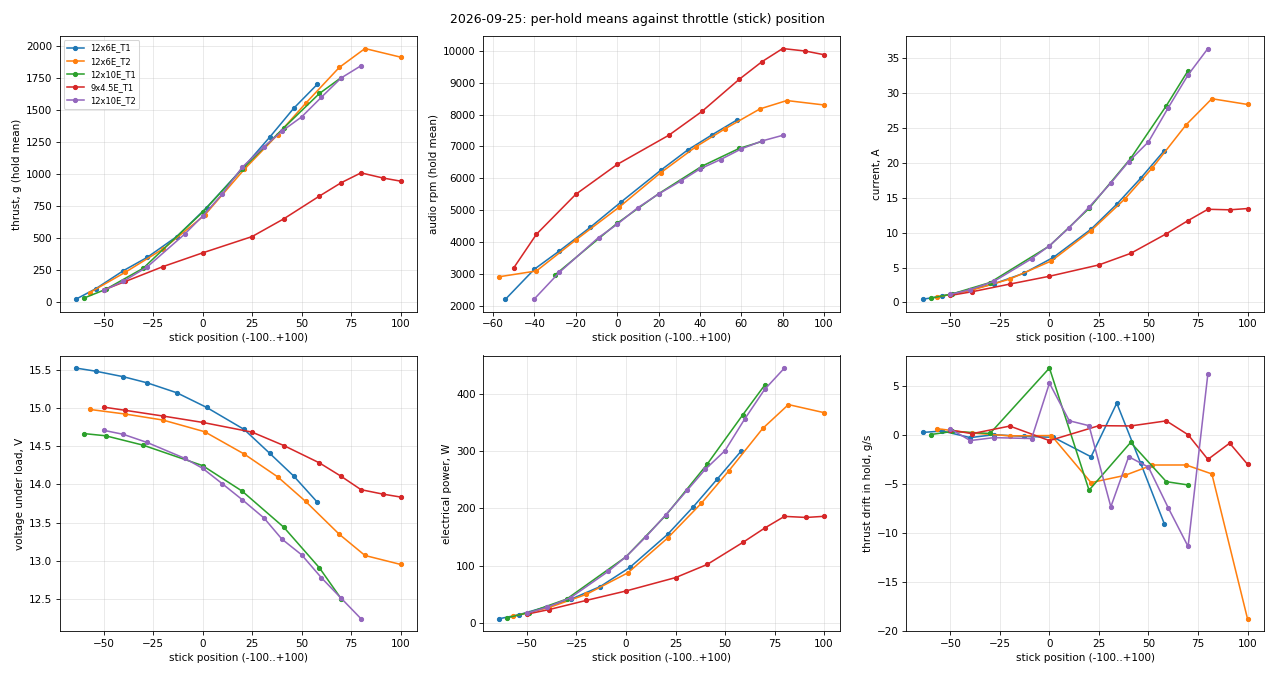
analysis/tests/out/throttle/2026-09-25_vs_throttle.png
