Xavier8264/SAE-Aero-Design/analysis/tests/out/throttle/2026-09-29_12x8E_T1_timeseries.png

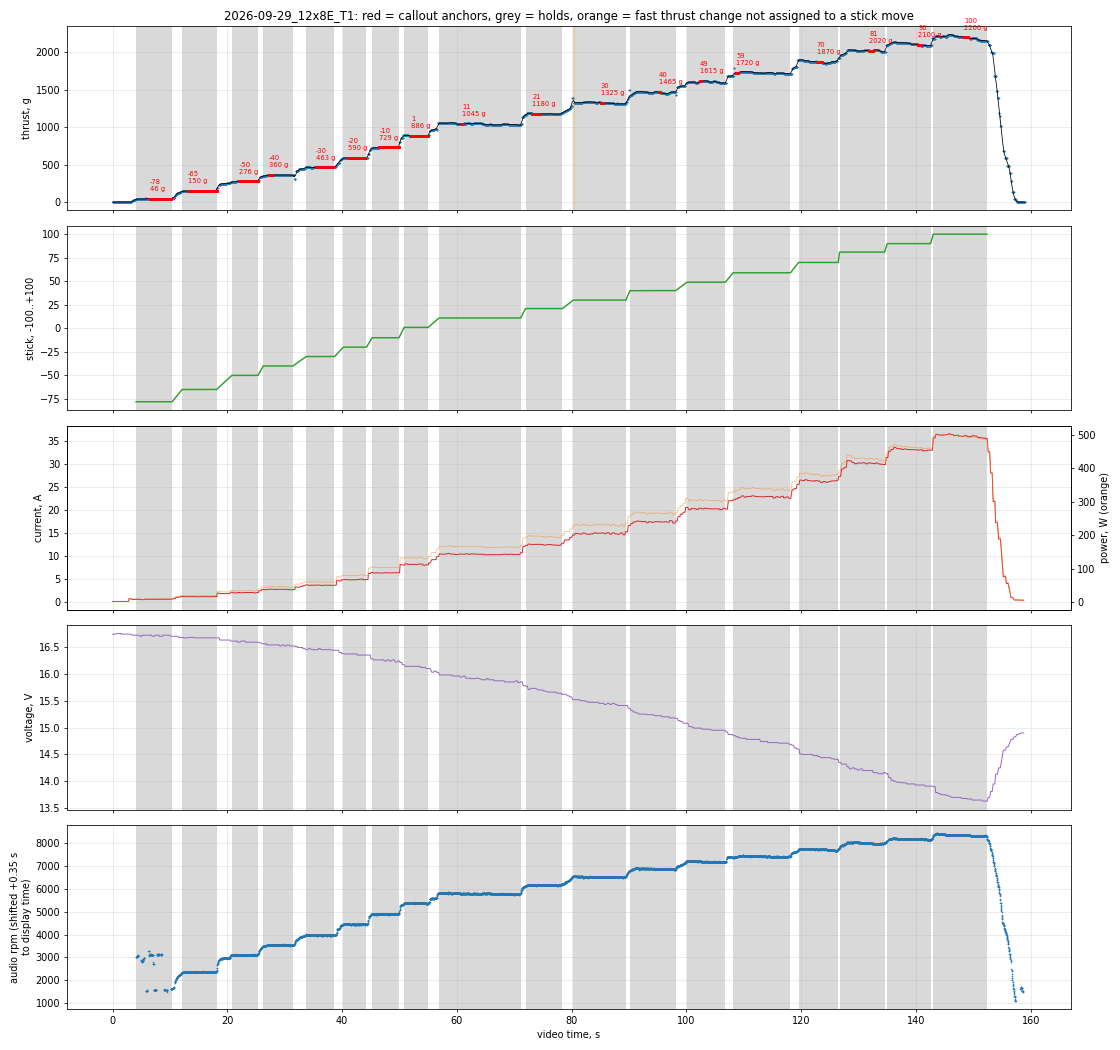
analysis/tests/out/throttle/2026-09-29_12x8E_T1_timeseries.png
