Xavier8264/SAE-Aero-Design/(commit log)

2026-09-19 Add doc2text script for token-efficient document lookups and conversions
    - Implemented functionality to fetch, add, render, and manage documents.
    - Supports various formats including PDF, HTML, DOCX, PPTX, and XLSX.
    - Generates plain text outputs with page markers and flags for document quality.
    - Maintains a manifest and index for easy reference and retrieval.
    [cc_model_config.txt, klal_asos_2021-03_to_2026-04.csv, noaa_lakeland_normals.csv]
2026-09-20 Add conceptual sizing analysis and log the results
    analysis/sizing/: scripts (density altitude, scoring, propulsion, airfoils,
    aero, weight, takeoff, sweep, design card, AeroSandbox VLM check) plus their
    outputs in analysis/sizing/out/.
    Design point: 95 x 26 in rectangular S1223 wing, 2 x APC 12x6E on one 4S 2200,
    6-slot bottle bay, W_TO 35.0 lb, W_empty 17.7 lb, payload 17.4 lb, top rung
    1E4F (flight score 47) at DA 2000 ft.
    [airfoil_polars.csv, airfoil_summary.csv, asb_check.csv, da_design_points.csv, da_march_klal.csv, design_airfoils.csv, design_payload_vs_DA.csv, design_point.csv]
2026-09-20 Archive 20 sources: design process, structures, FEA tools, flight test, build
    Fills the gaps that conceptual sizing left open. All URLs verified HTTP 200
    before archiving.
    - Design process: Virginia Tech AOE 4065/4066 notes (initial sizing,
    configuration layout, preliminary design), MIT 16.82 intro, NASA SP-2016-6105
    systems engineering handbook.
    - Structures and loads: NASA CR-132531 VG/VGH load factor statistics, UF spar
    optimization for a 14 lb RC aircraft, Syracuse worked spar sizing, USDA FPL
    RN-086 minimum weight sandwich (free substitute for the canceled MIL-HDBK-23).
    - Tools: OpenVSP manual, Gmsh manual, CalculiX 2.22 manual, FreeCAD FEM
    tutorial, SU2 quick start, ParaView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
    [vt_aoe_a7a_config_layout.txt]
2026-09-21 Add TEST_PLAN.md for T-1 wing panel weigh-in and T-2 static thrust stand
    - Created a new test plan document detailing the objectives, procedures, and equipment for T-1 and T-2 tests.
    - Document includes rules, acceptance criteria, and feedback mechanisms for integrating test results into the project.
    - Updated PROJECT_MEMORY.md with a summary of the test plan and its significance in reducing uncertainties in the project.
    - Adjusted analysis scripts and data structures to accommodate new test data.
2026-09-24 Add SunnySky X2820 800KV brushless motor specifications and test data
    - Created a new specification file for the SunnySky X2820 800KV brushless outrunner motor.
    - Included detailed specifications such as dimensions, motor Kv, recommended props, and maximum power ratings.
    - Added manufacturer test data for various propeller configurations at 4S voltage.
    - Provided reading notes for clarification on the data and measurements.
    [12x8E_blue_states.csv, 12x8E_frames.csv, 12x8E_points.csv, 12x8E_predict.csv, 12x8E_rpm.csv, 12x8E_rpm_states.csv, 12x8E_smoke_blue_states.csv, 12x8E_smoke_frames.csv]
2026-09-27 Add new weather data file for MKL station on 2026-09-26
    - Created a new CSV file `kmkl_asos_2026-09-26.csv` containing hourly weather observations.
    - Included fields: station, valid time, temperature (tmpf), dew point (dwpf), relative humidity (relh), altitude (alti), and mean sea level pressure (mslp).
    [2026-09-25_12x10E_T1_blue_states.csv, 2026-09-25_12x10E_T1_frames.csv, 2026-09-25_12x10E_T1_holds.csv, 2026-09-25_12x10E_T1_rpm.csv, 2026-09-25_12x10E_T1_rpm_states.csv, 2026-09-25_12x10E_T1_t2.csv, 2026-09-25_12x10E_T1_throttle.csv, 2026-09-25_12x10E_T1_thrust_states.csv]
2026-09-30 Add new weather data for MKL station on 2026-09-30
    [2026-09-29_12x8E_T1_blue_states.csv, 2026-09-29_12x8E_T1_frames.csv, 2026-09-29_12x8E_T1_holds.csv, 2026-09-29_12x8E_T1_rpm.csv, 2026-09-29_12x8E_T1_rpm_states.csv, 2026-09-29_12x8E_T1_t2.csv, 2026-09-29_12x8E_T1_throttle.csv, 2026-09-29_12x8E_T1_thrust_states.csv]
